FordPrfkt/StepperController/Boards/StepperDisplay/StepperDisplay_Top.png

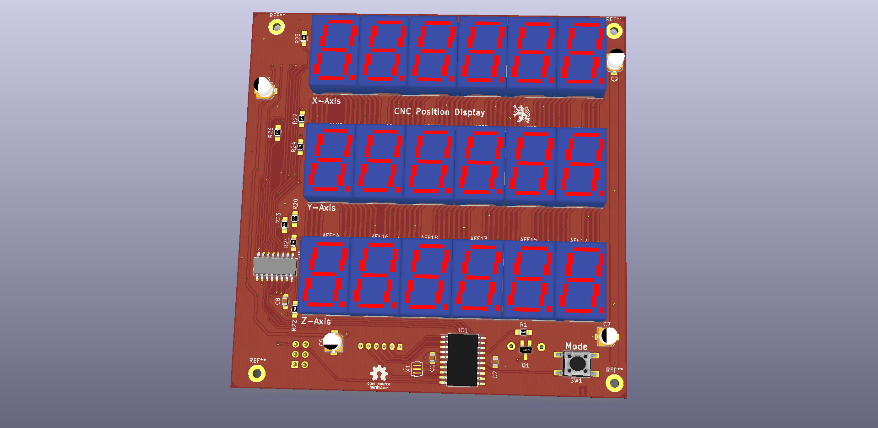
Boards/StepperDisplay/StepperDisplay_Top.png
