FordPrfkt/StepperController/boards/HighPowerDriver/HPDriver/HPDriver.png

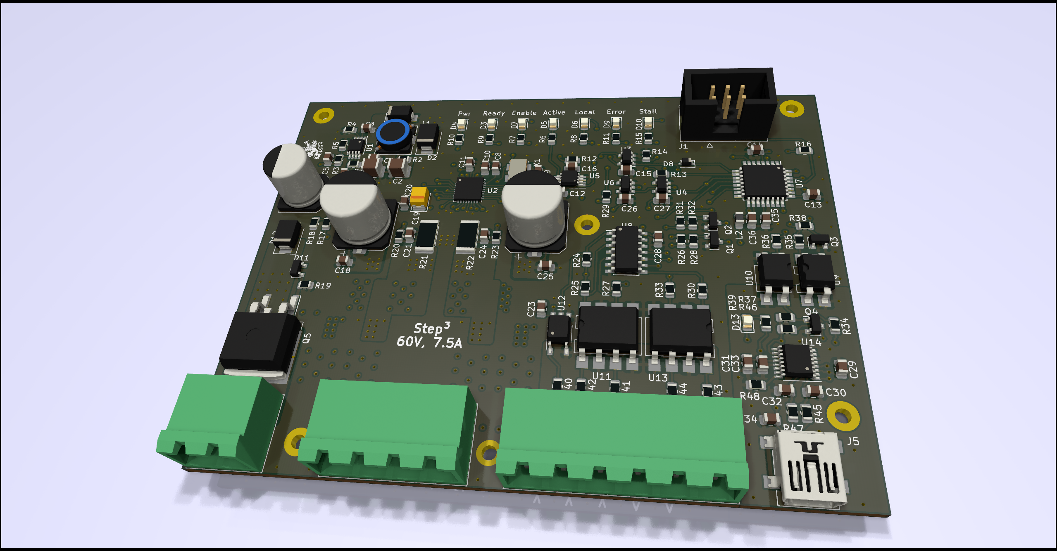
boards/HighPowerDriver/HPDriver/HPDriver.png
