FordPrfkt/StepperController/README.md

# StepperController
Stepper Motor Controller using TMC2660
