FordPrfkt/StepperController/Boards/StepperController/StepperController_Bot.png

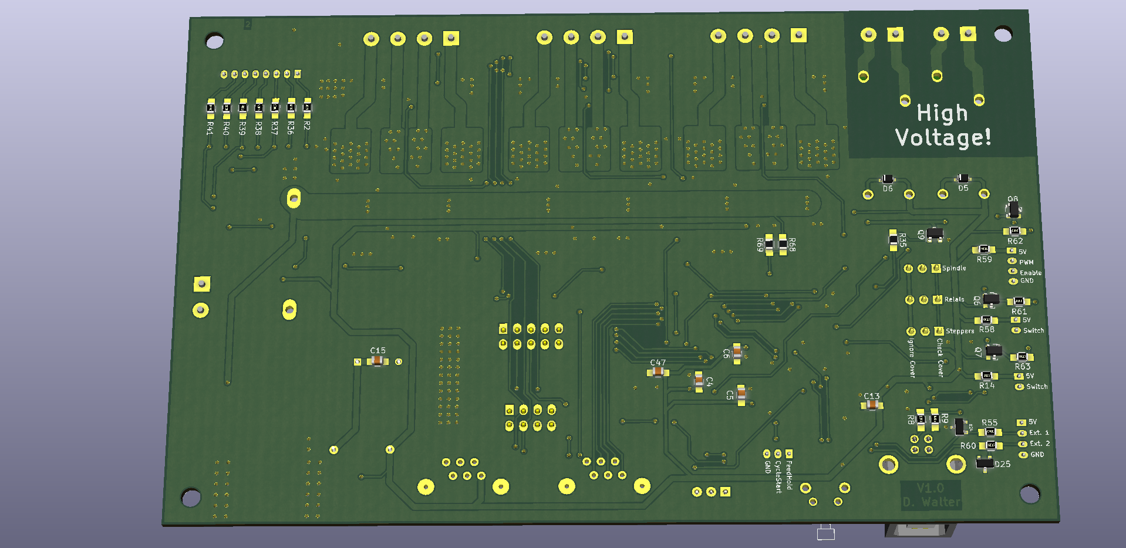
Boards/StepperController/StepperController_Bot.png
