FordPrfkt/StepperController/Boards/StepperController/StepperController_Top.png

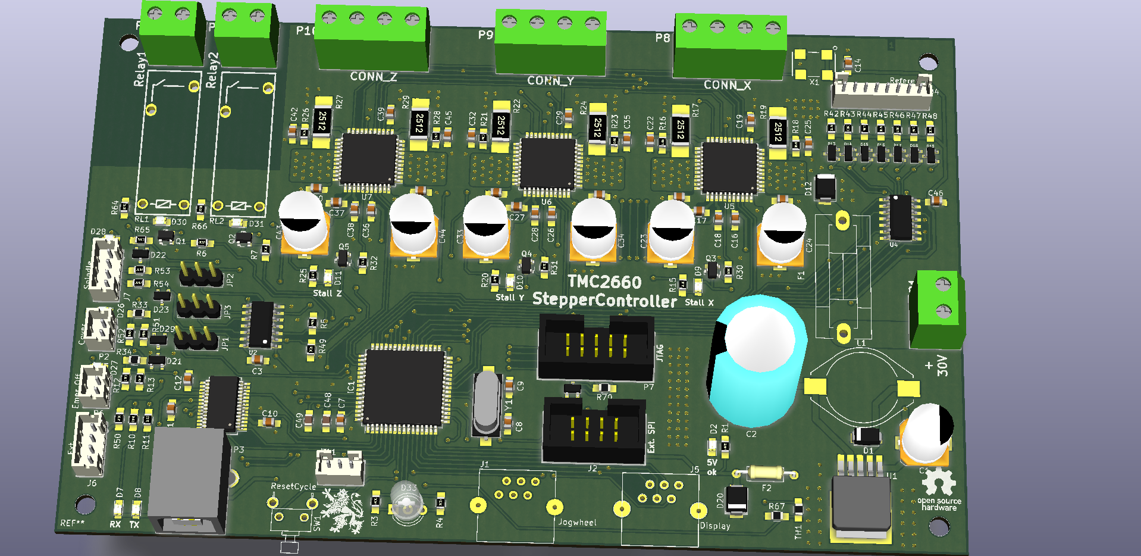
Boards/StepperController/StepperController_Top.png
