FordPrfkt/StepperController/Boards/StepperDisplay/StepperDisplay_Bot.png

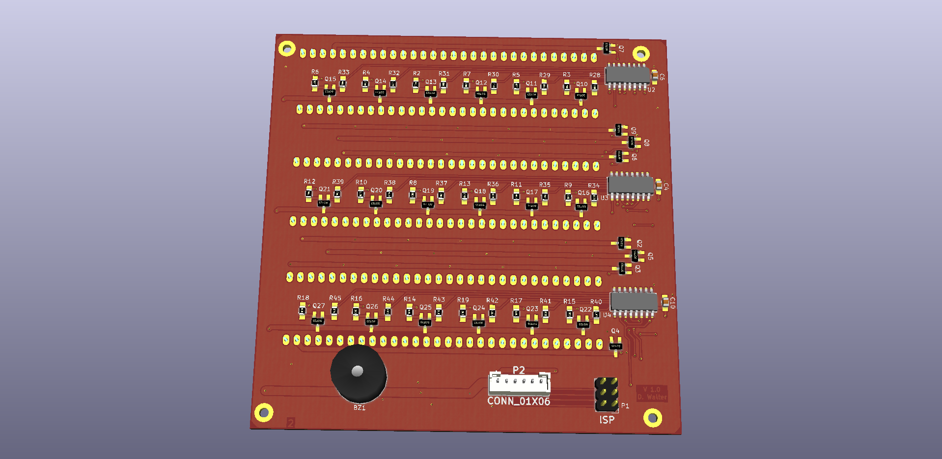
Boards/StepperDisplay/StepperDisplay_Bot.png
