FordPrfkt/StepperController/Boards/StepperController/StepperController.pdf

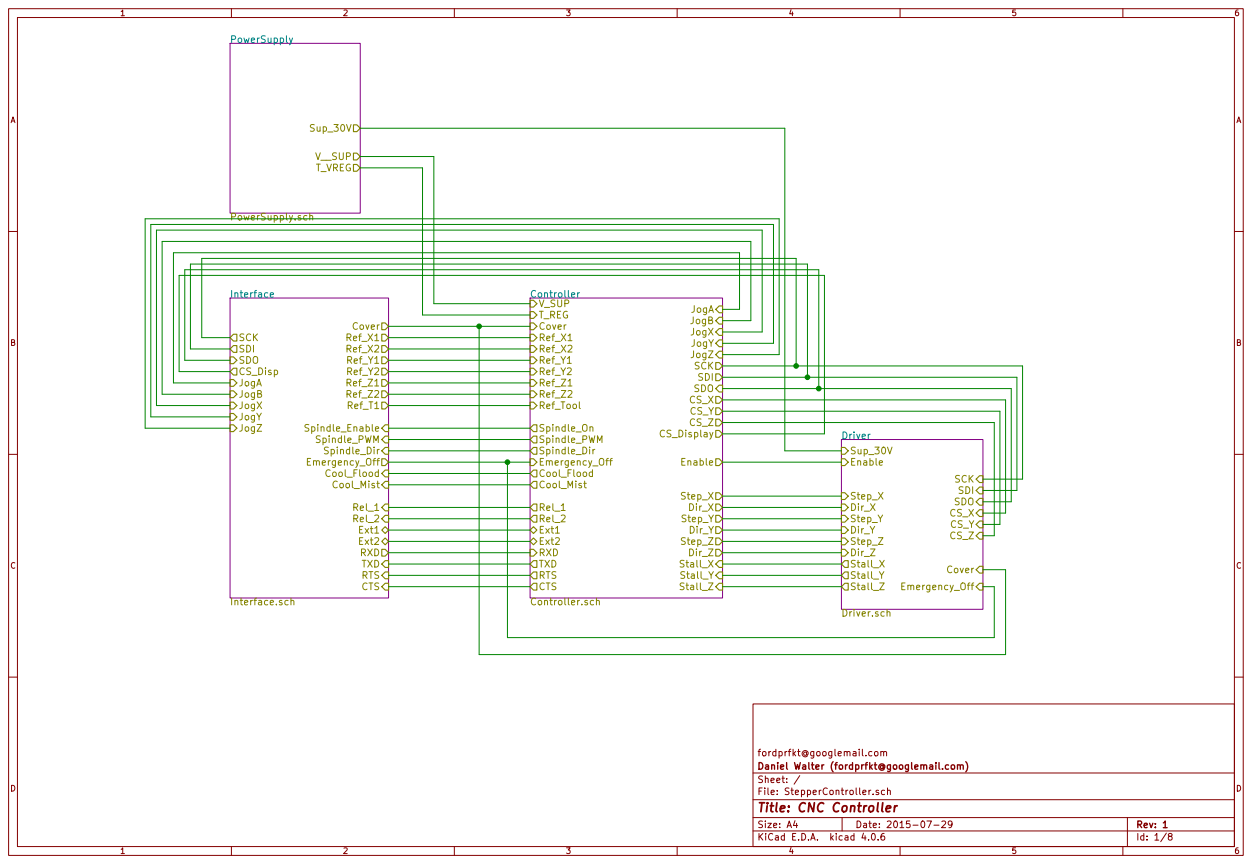
[picture p6: page 1]

fordprfkt@googlemail.com
File: StepperController.sch Sheet: / Daniel Walter (fordprfkt@googlemail.com)

Id: 1/8 Title: CNC Controller

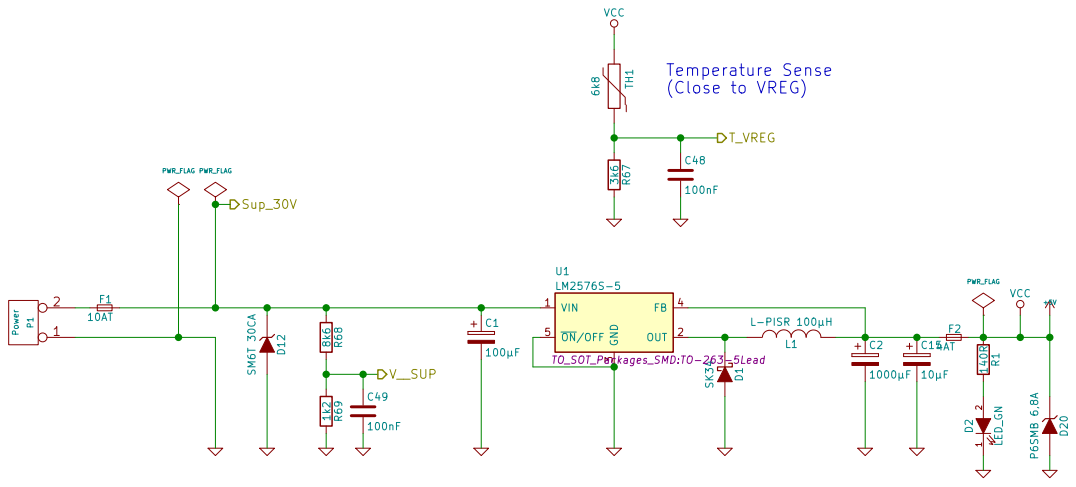
[picture p7: page 2]

fordprfkt@googlemail.com
Daniel Walter (fordprfkt@googlemail.com)
Sheet: /PowerSupply/
File: PowerSupply.sch
Id: 2/8 Title: CNC Controller

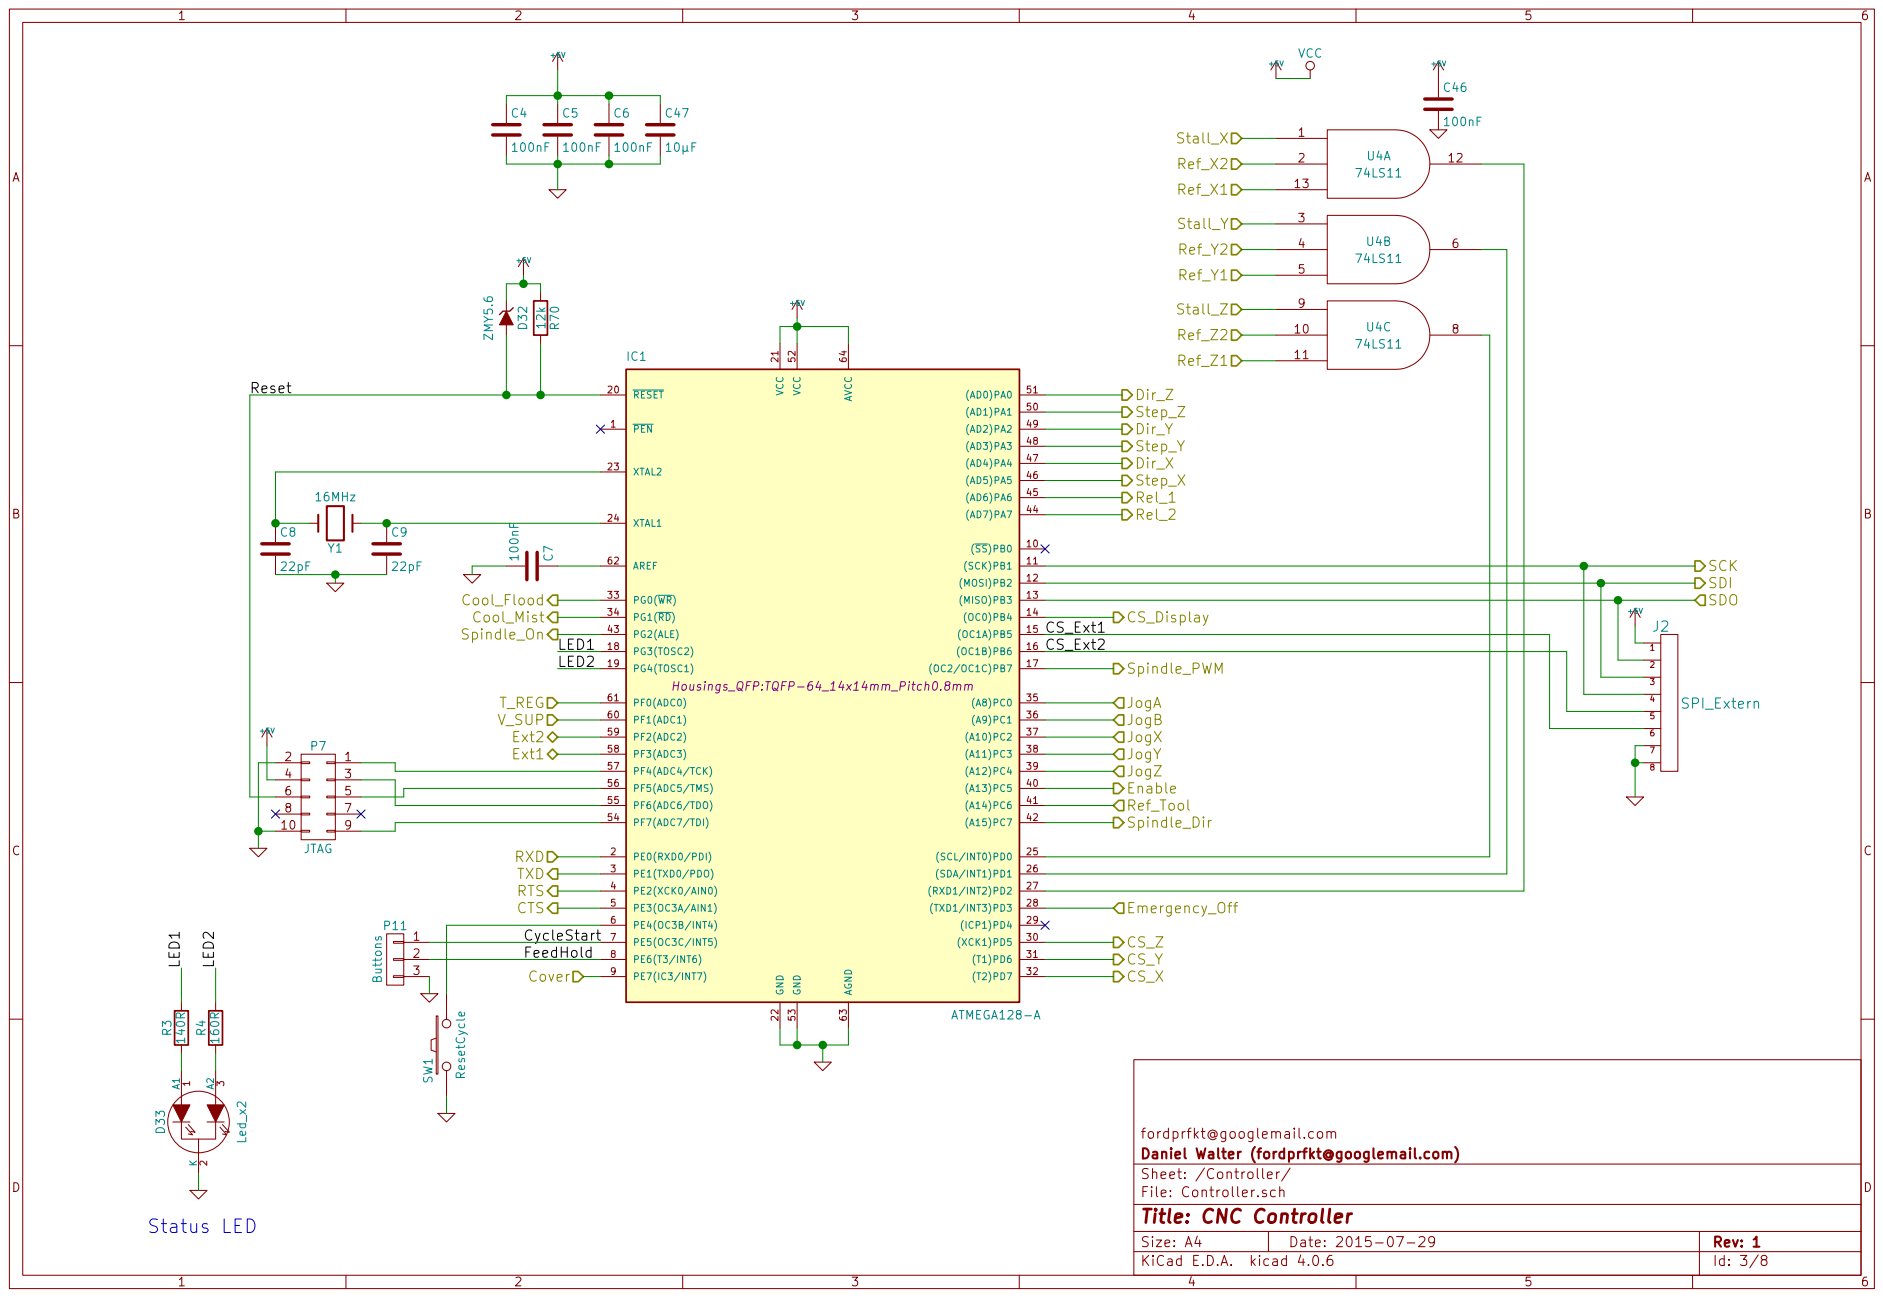
[picture p8: page 3]

PEN 1 PE0(RXD0/PDI) 2 PE1(TXD0/PDO) 3 PE2(XCK0/AIN0) 4 PE3(OC3A/AIN1) 5 PE4(OC3B/INT4) 6 PE5(OC3C/INT5) 7 PE6(T3/INT6) 8 PE7(IC3/INT7) 9 | CS_Display

CS_Ext2

Spindle_PWM JogA JogB JogX JogY JogZ Spindle_Dir

fordprfkt@googlemail.com
Id: 3/8 Title: CNC Controller File: Controller.sch Sheet: /Controller/ Daniel Walter (fordprfkt@googlemail.com)

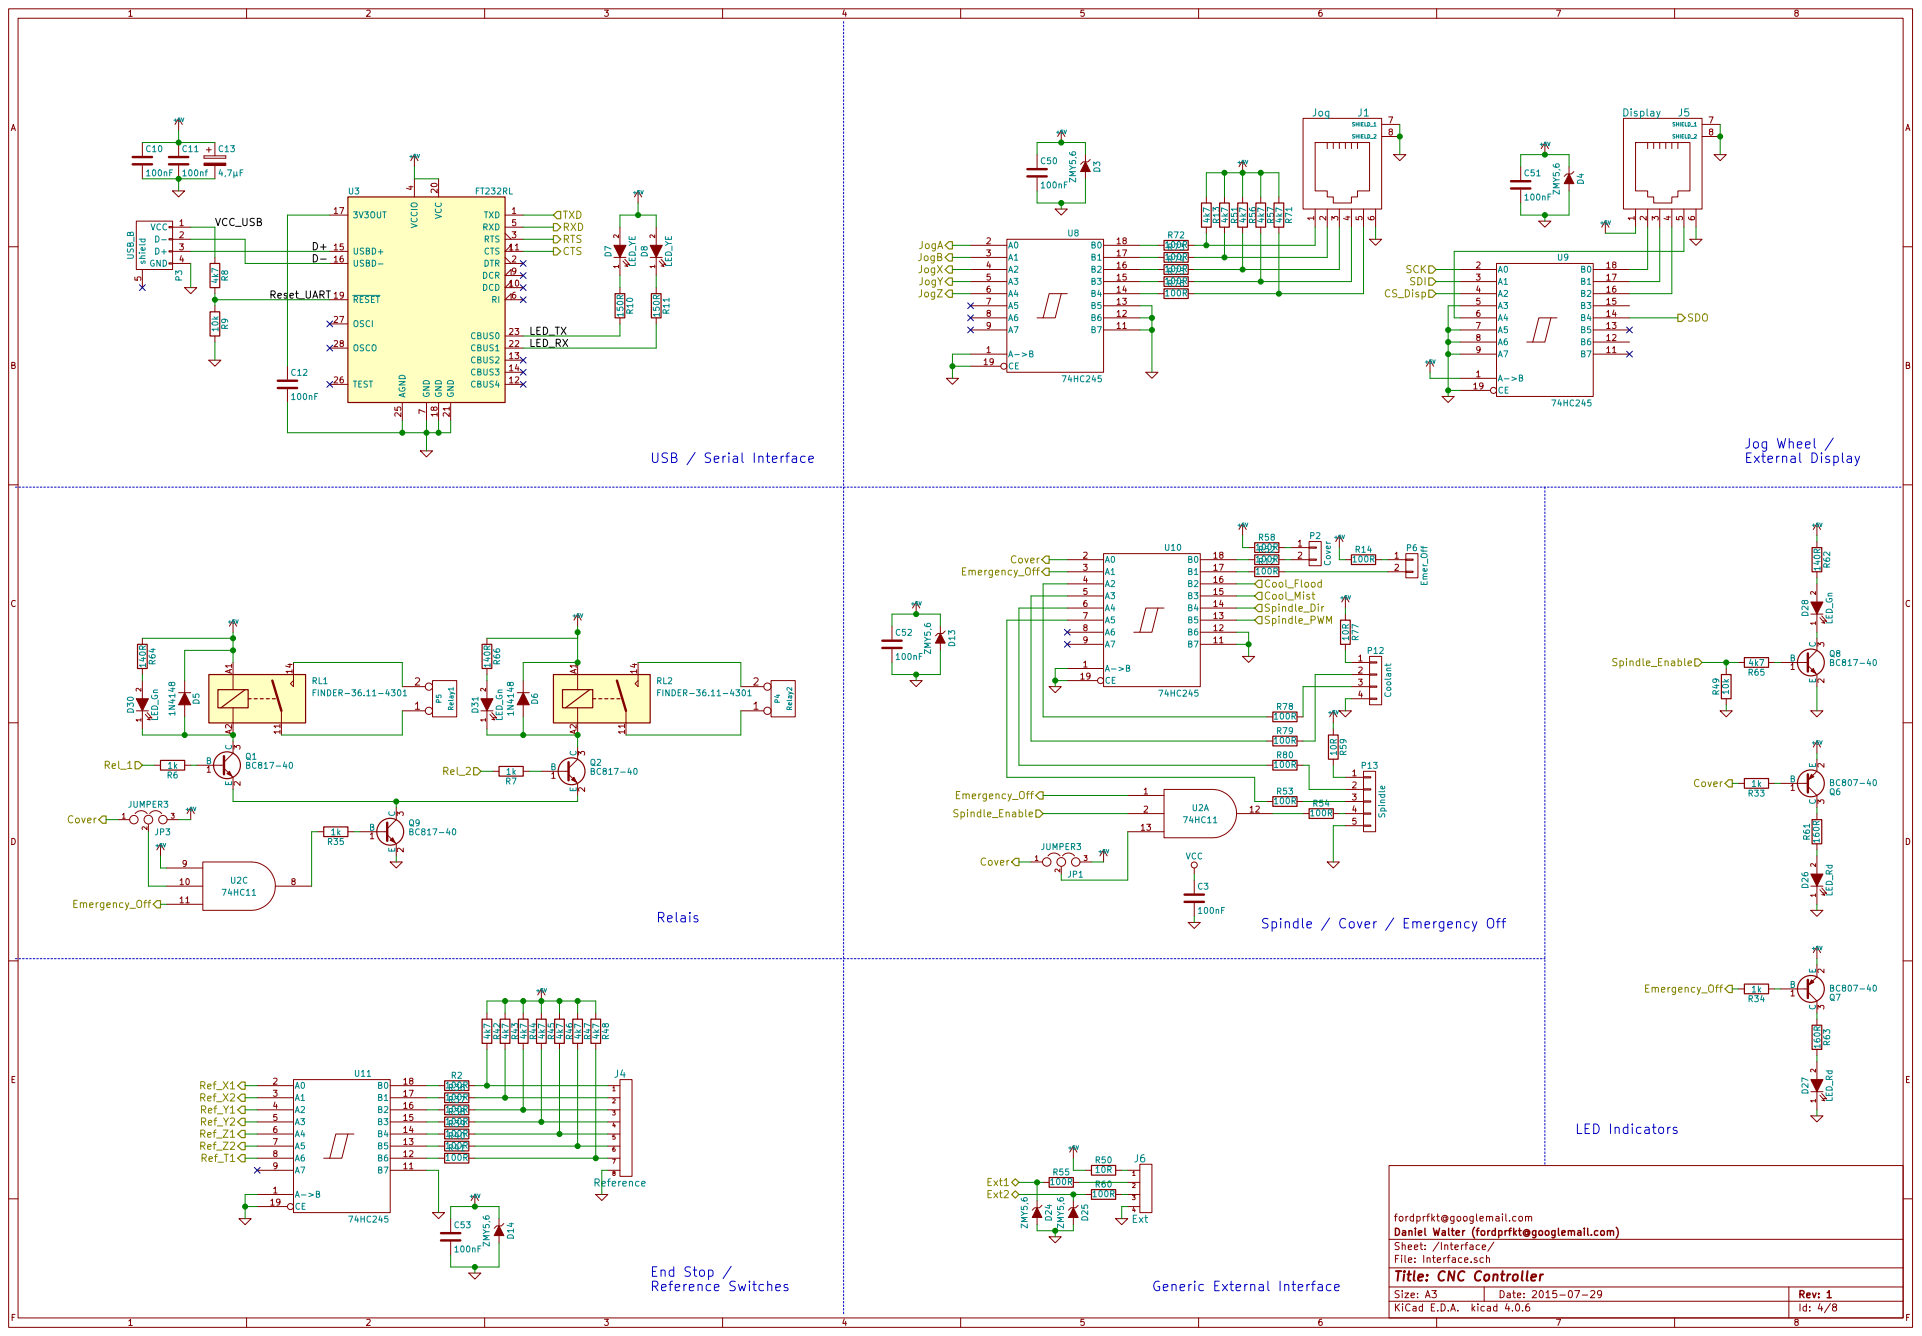
[picture p9: page 4]

7 DCR 9 DCD 10 VCC 20 CTS 11 GND 21 CBUS4 12 CBUS1 22 CBUS2 13 CBUS0 23 CBUS3 14 USBD+ 15 AGND 25 USBD- 16 TEST 26

Spindle / Cover / Emergency Off

fordprfkt@googlemail.com
Id: 4/8 Title: CNC Controller File: Interface.sch Sheet: /Interface/ Daniel Walter (fordprfkt@googlemail.com)

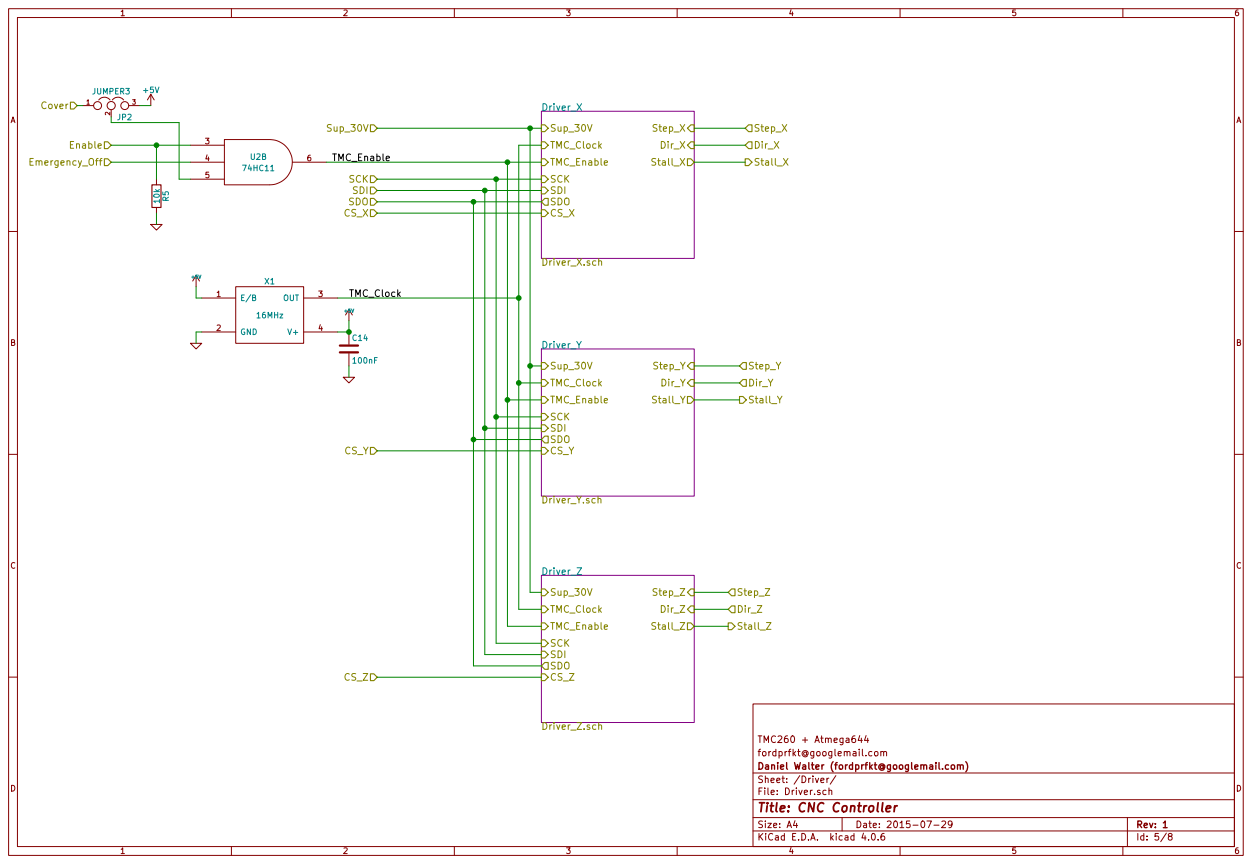
[picture p10: page 5]

TMC260 + Atmega644
fordprfkt@googlemail.com
Id: 5/8 Title: CNC Controller File: Driver.sch Sheet: /Driver/ Daniel Walter (fordprfkt@googlemail.com)

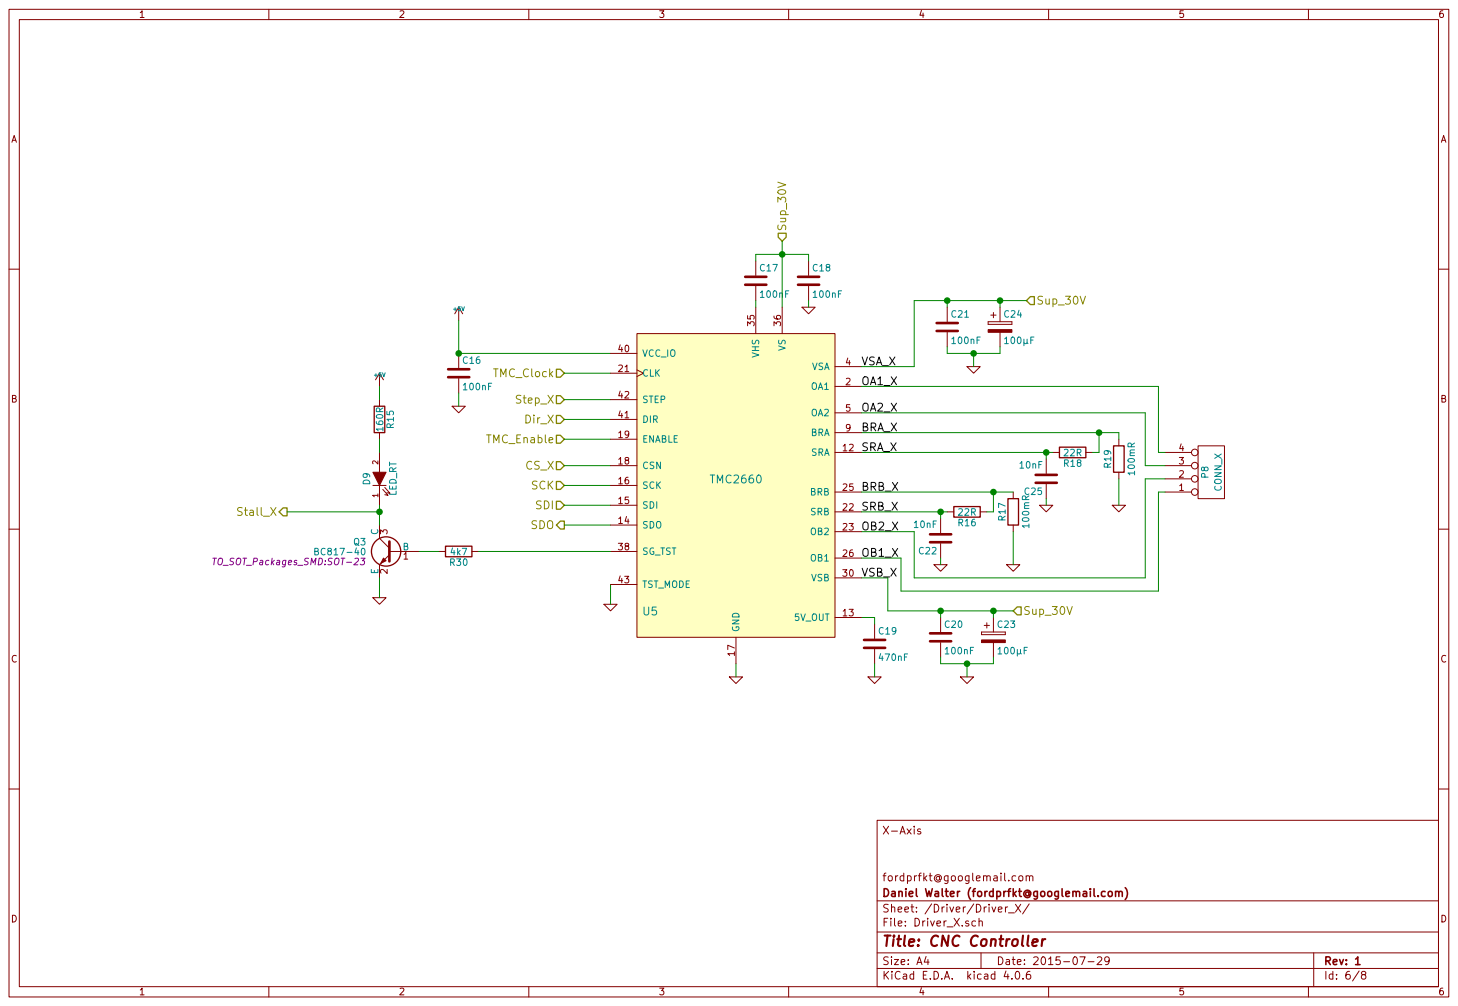
[picture p11: page 6]

fordprfkt@googlemail.com
Daniel Walter (fordprfkt@googlemail.com)
Sheet: /Driver/Driver_X/
File: Driver_X.sch
Id: 6/8 Title: CNC Controller

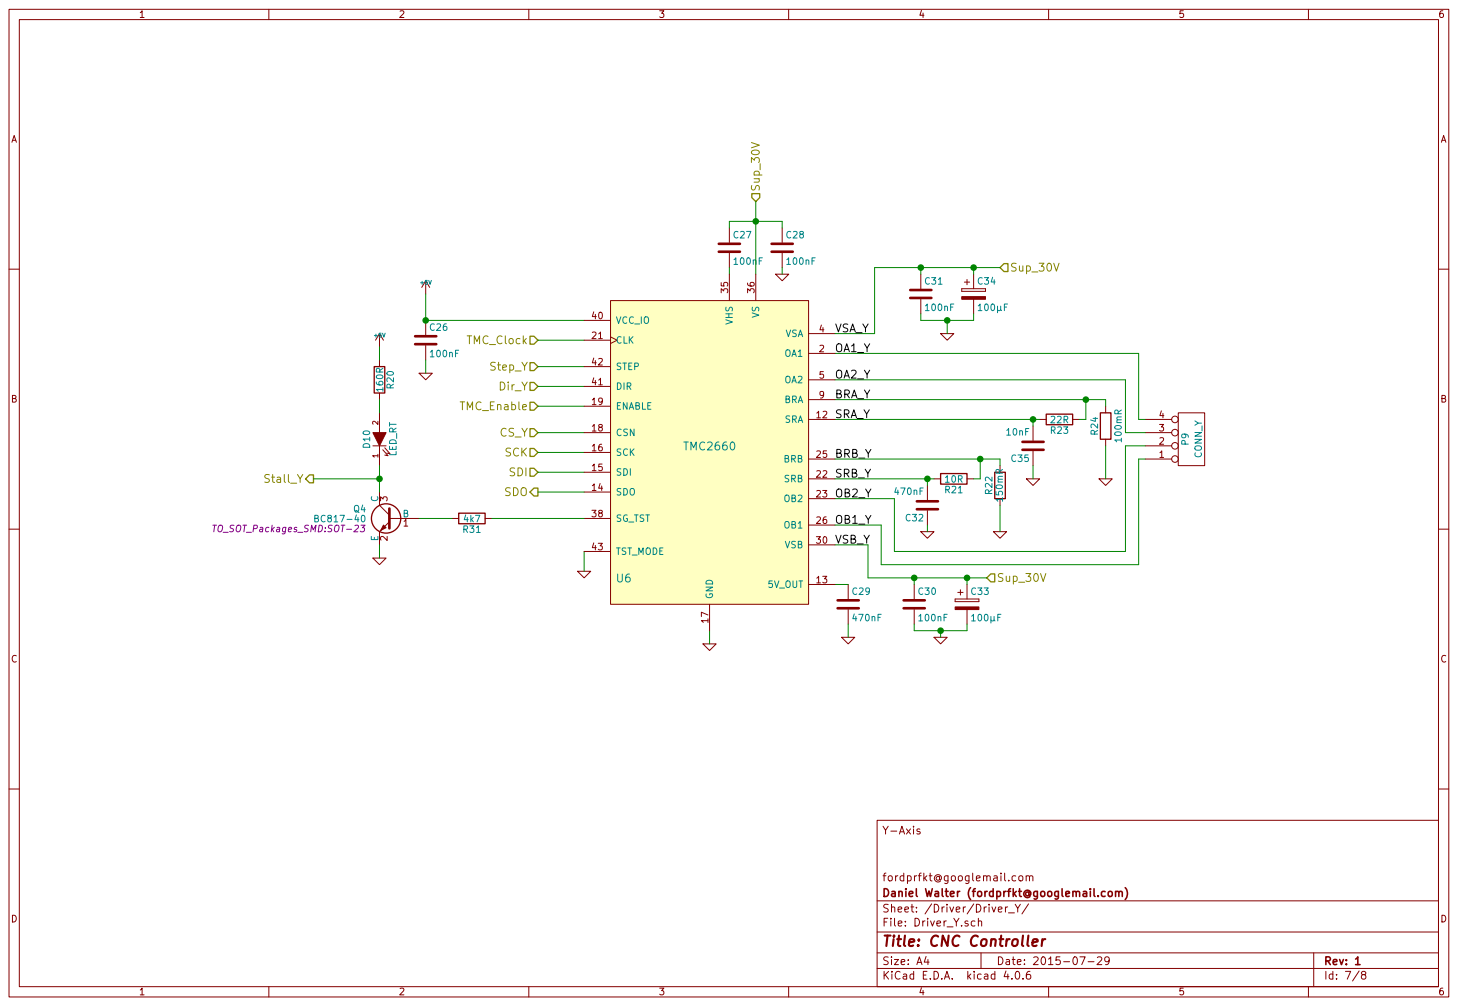
[picture p12: page 7]

fordprfkt@googlemail.com
Daniel Walter (fordprfkt@googlemail.com)
Sheet: /Driver/Driver_Y/
File: Driver_Y.sch
Id: 7/8 Title: CNC Controller

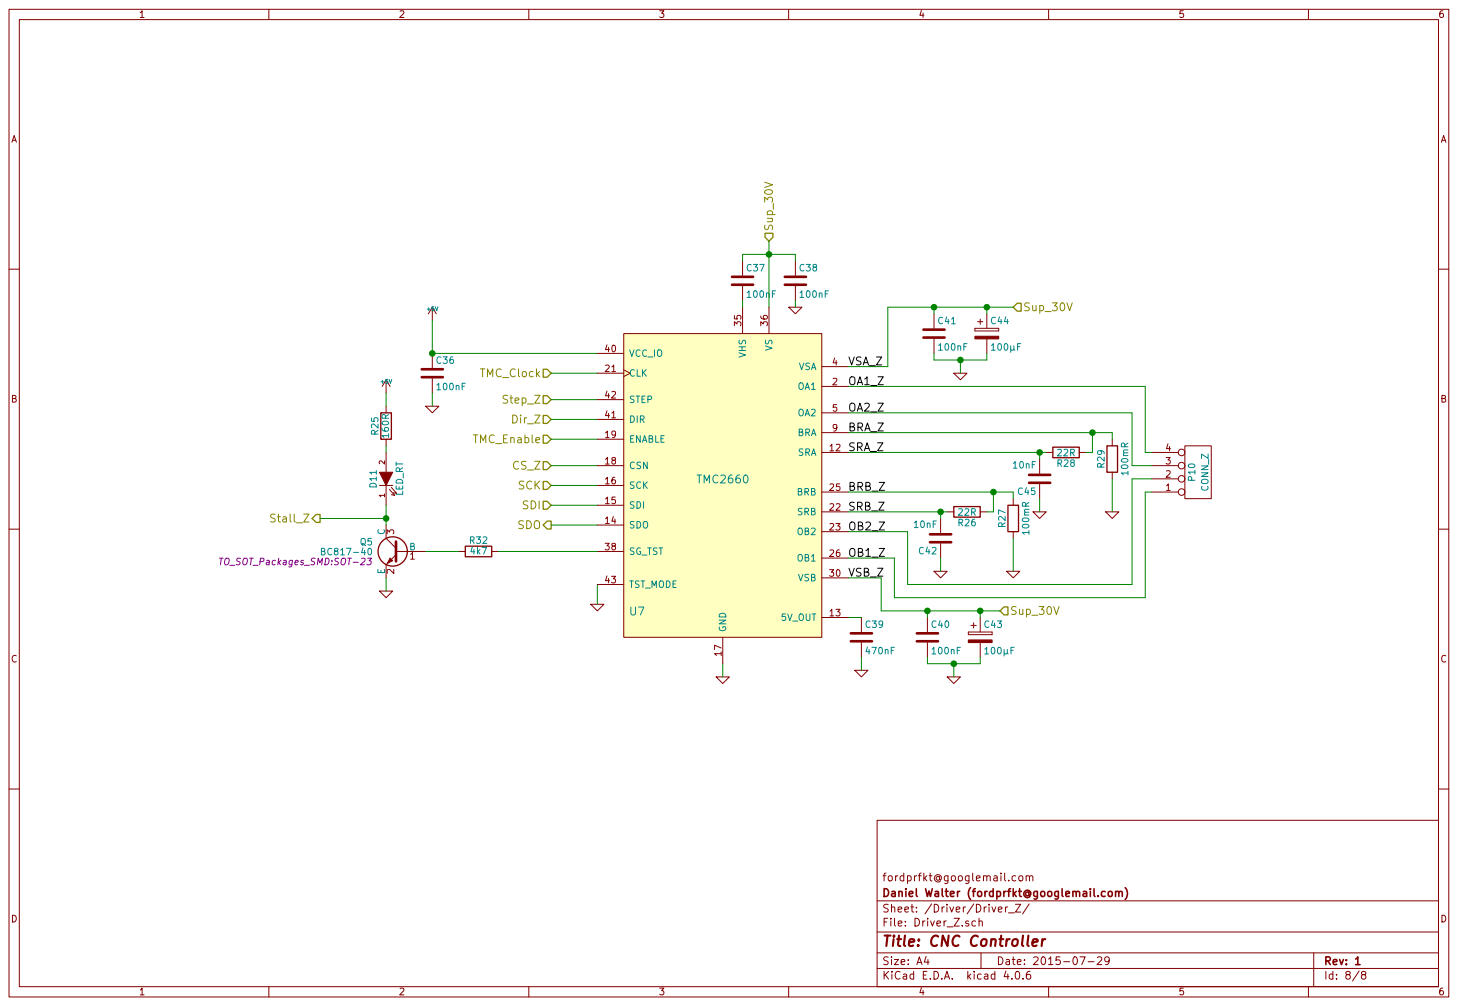
[picture p13: page 8]

Daniel Walter (fordprfkt@googlemail.com)
Sheet: /Driver/Driver_Z/
File: Driver_Z.sch
Id: 8/8 Title: CNC Controller
