FordPrfkt/StepperController/Boards/StepperDisplay/StepperDisplay.pdf

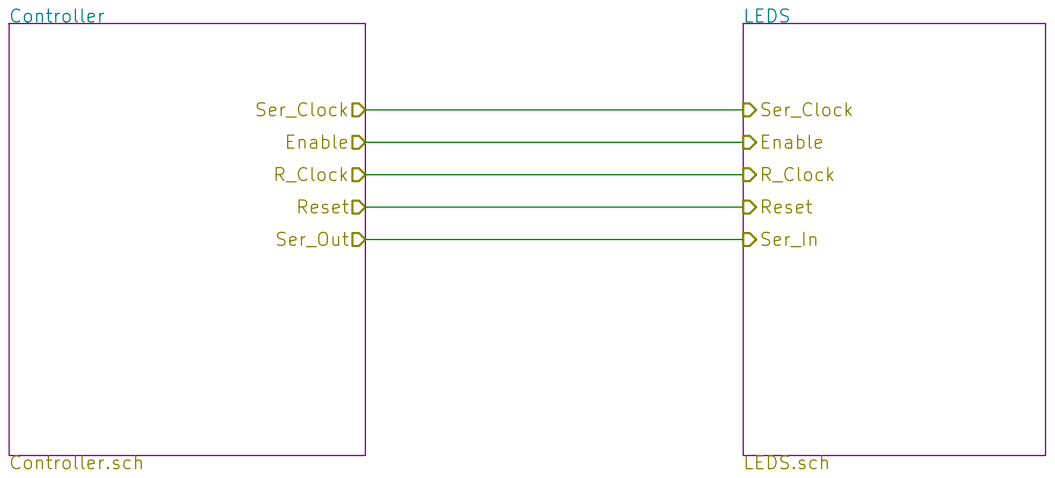
[picture p14: page 1]

File: StepperDisplay.sch Sheet: / Daniel Walter (fordprfkt@googlemail.com)

Id: 1/6 Title: CNC Controller Positionsanzeige

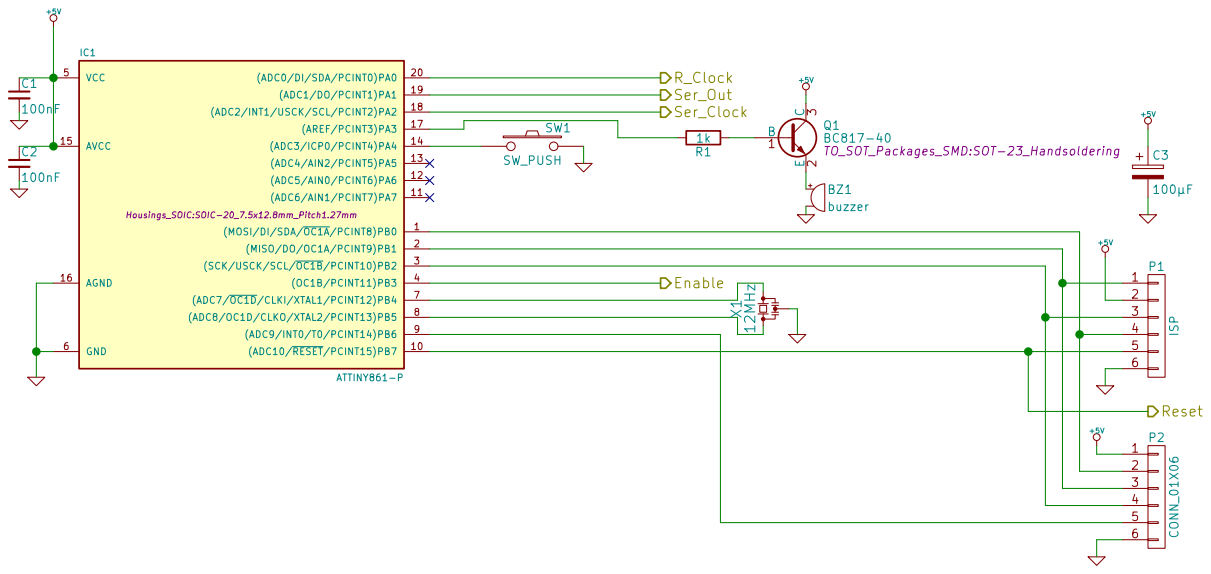
[picture p15: page 2]

File: Controller.sch Sheet: /Controller/ Daniel Walter (fordprfkt@googlemail.com)

Id: 2/6 Title: CNC Controller Positionsanzeige

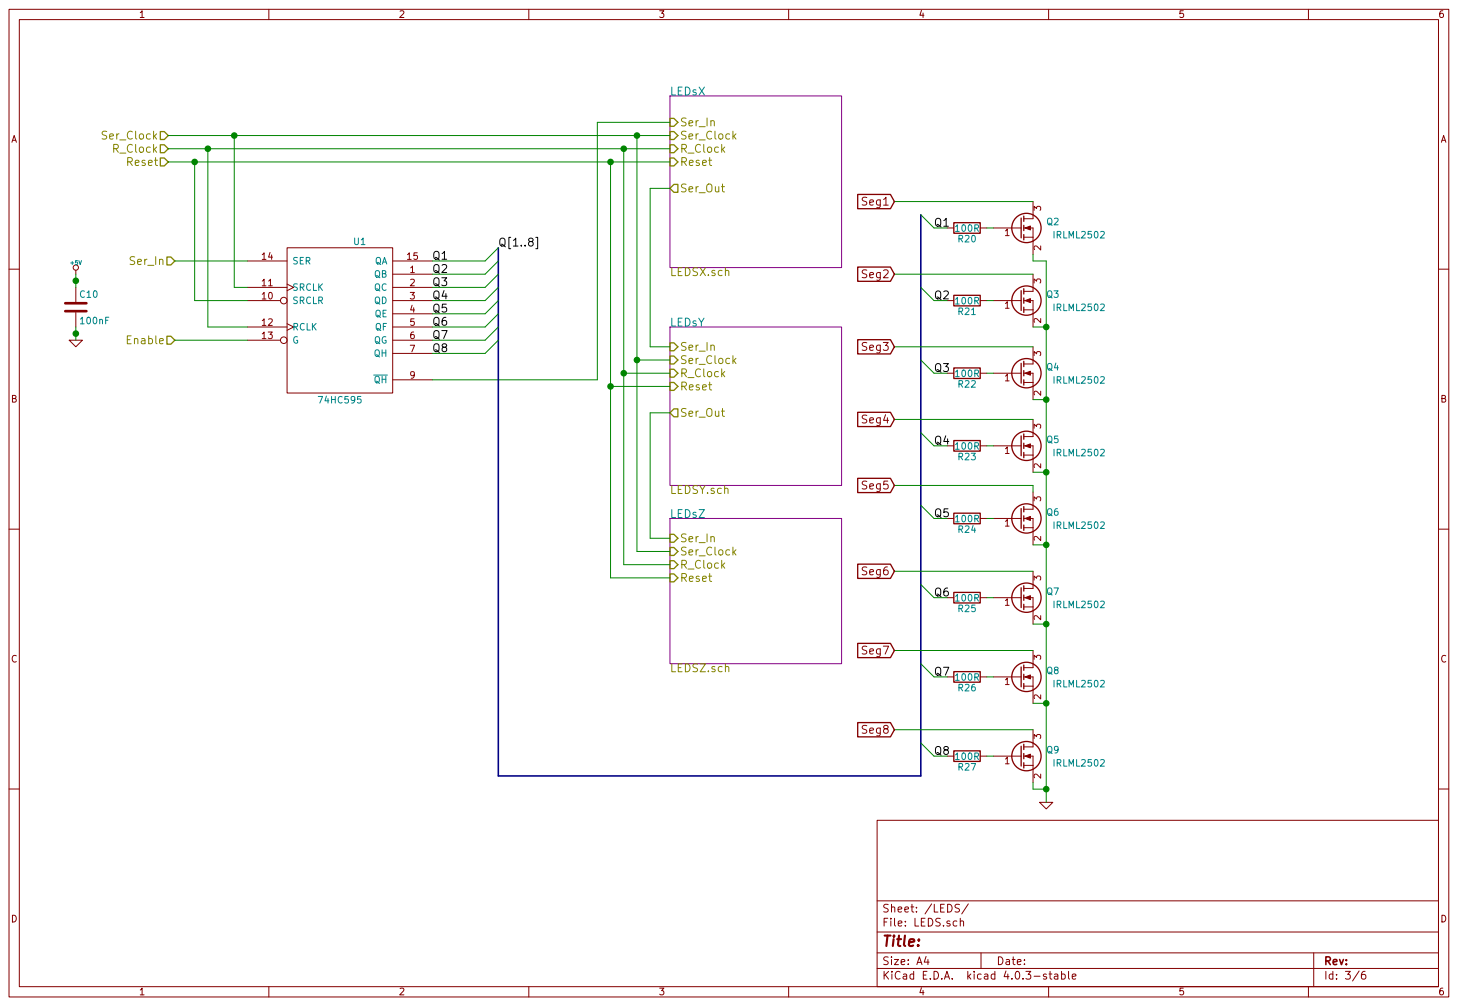
[picture p16: page 3]

Id: 3/6 Title: File: LEDS.sch Sheet: /LEDS/

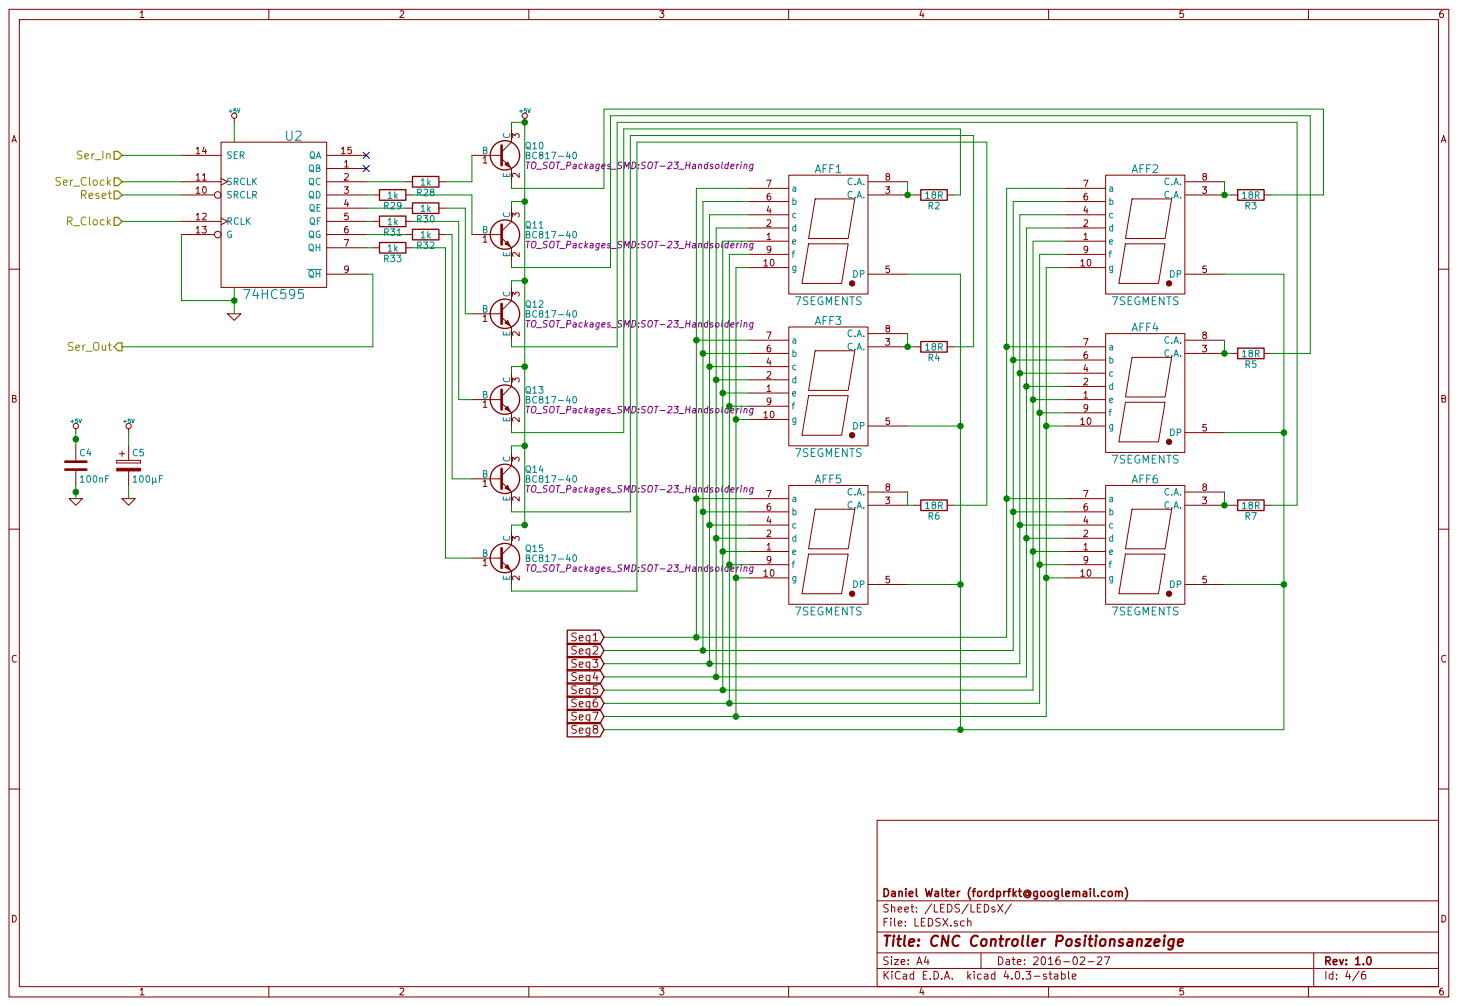
[picture p17: page 4]

File: LEDSX.sch Sheet: /LEDS/LEDsX/ Daniel Walter (fordprfkt@googlemail.com)

Id: 4/6 Title: CNC Controller Positionsanzeige

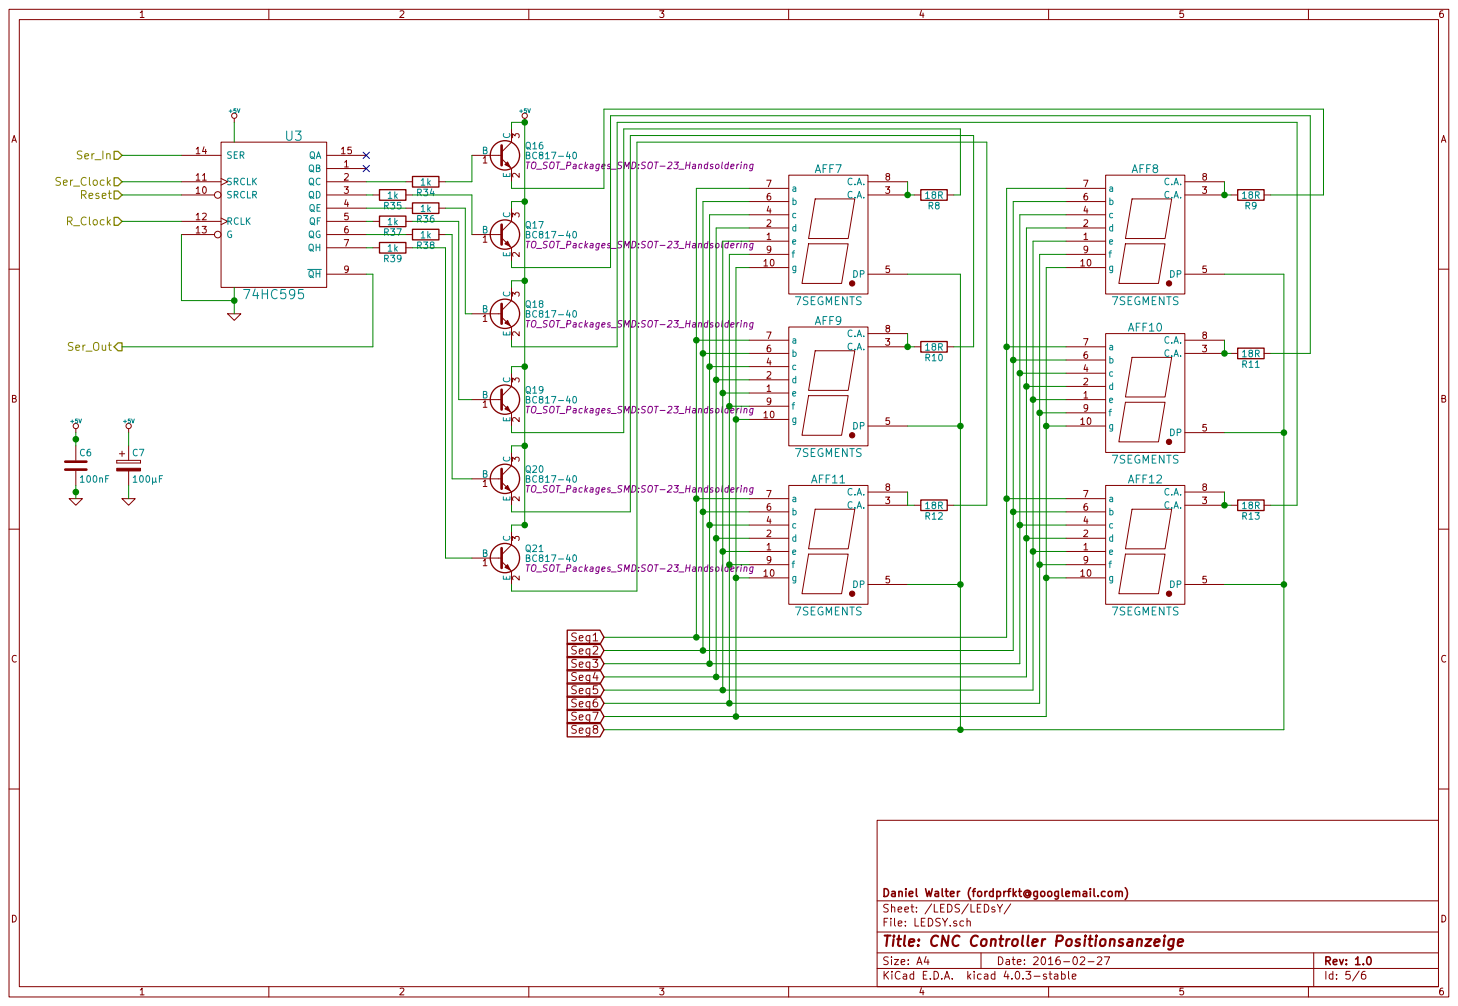
[picture p18: page 5]

File: LEDSY.sch Sheet: /LEDS/LEDsY/ Daniel Walter (fordprfkt@googlemail.com)

Id: 5/6 Title: CNC Controller Positionsanzeige

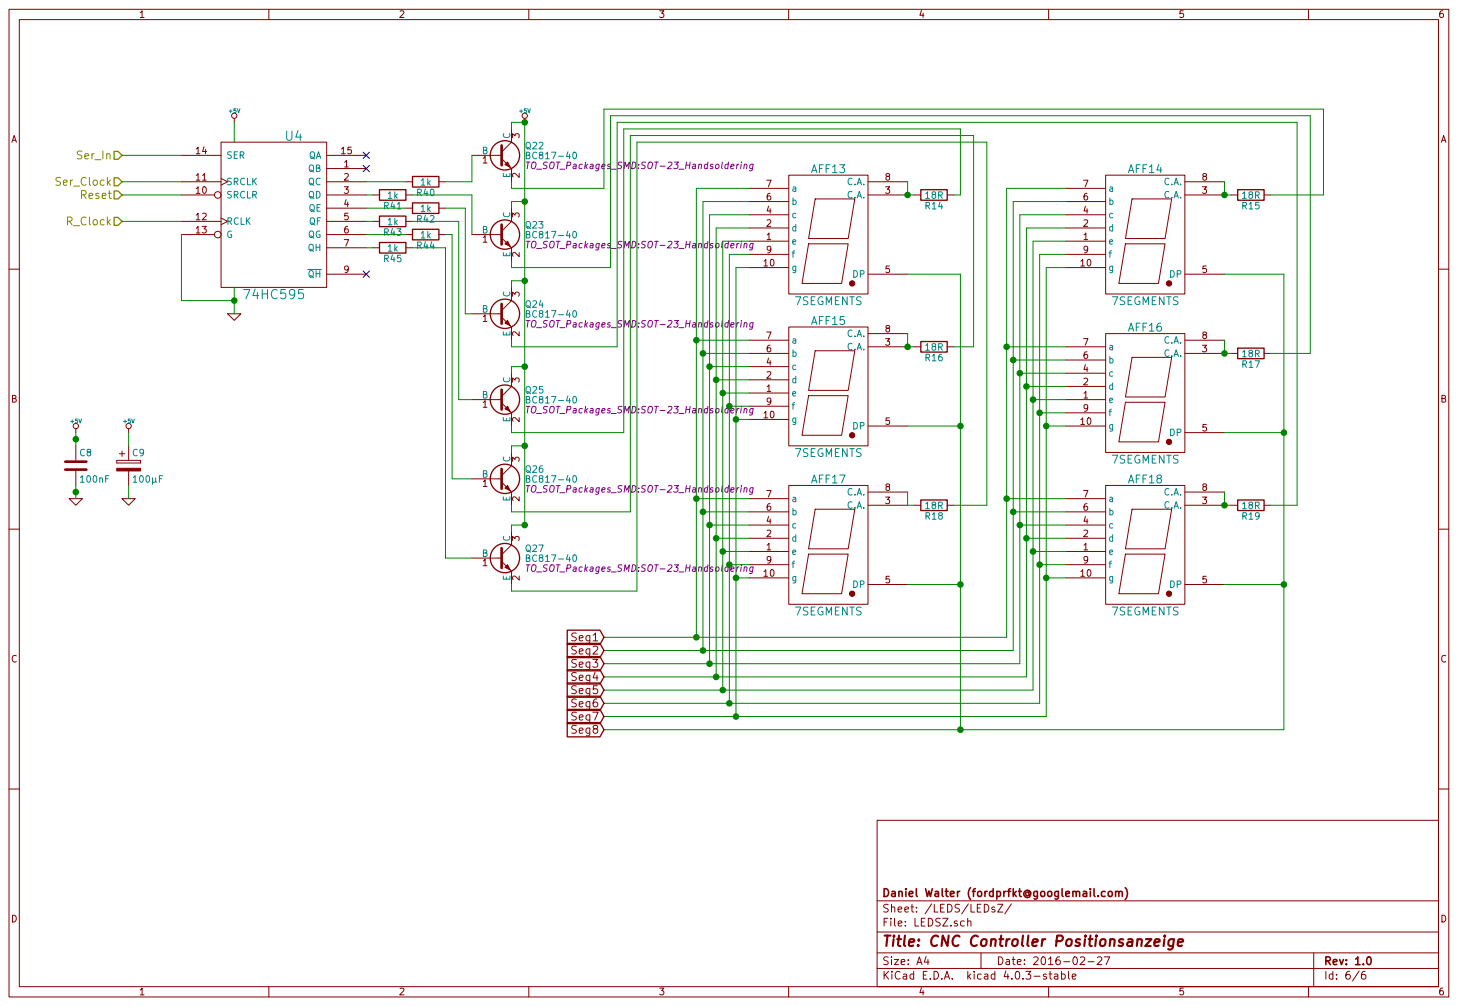
[picture p19: page 6]

File: LEDSZ.sch Sheet: /LEDS/LEDsZ/ Daniel Walter (fordprfkt@googlemail.com)

Id: 6/6 Title: CNC Controller Positionsanzeige
