FordPrfkt/StepperController/boards/HighPowerDriver/HPDriver/HPDriver.pdf

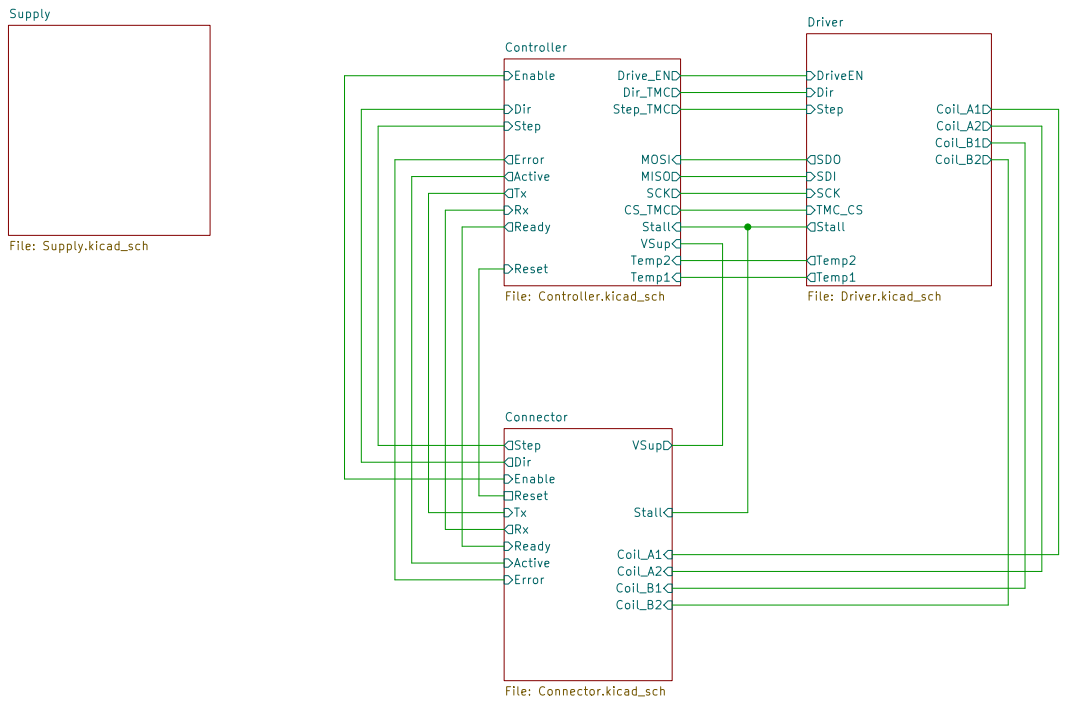
[picture p20: page 1]

Daniel Walter
File: HPDriver.kicad_sch Sheet: / fordprfkt@googlemail.com

Id: 1/5 Title: High Power Stepper Driver

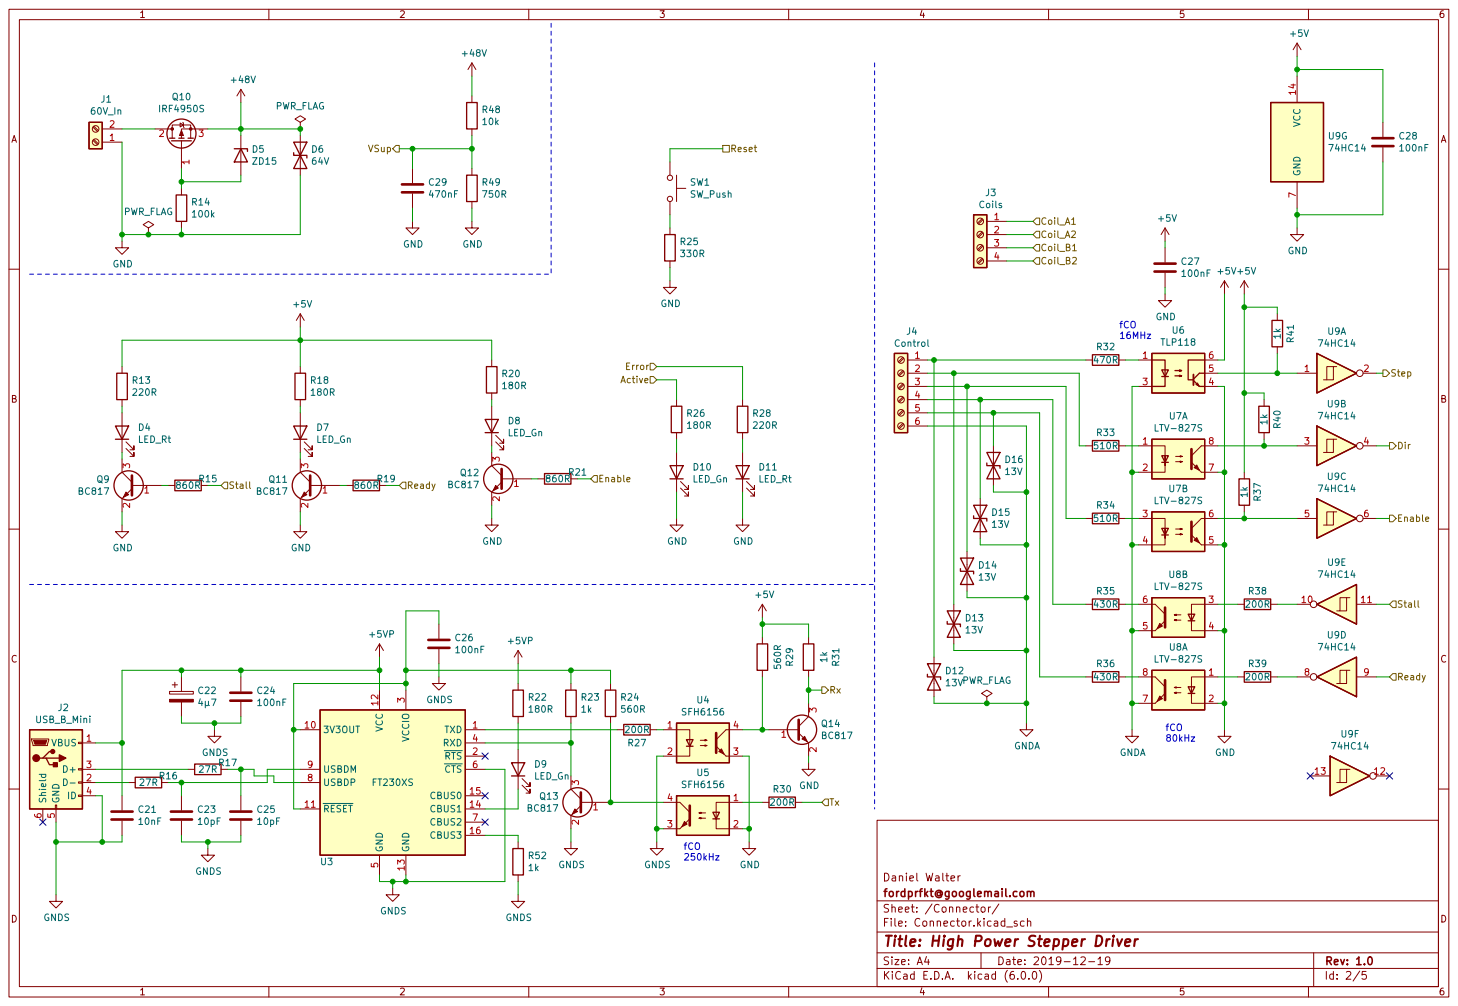
[picture p21: page 2]

5 ~{CTS} 6 CBUS2 7 USBDP 8 USBDM 9 U3 FT230XS GNDS C25

Daniel Walter
File: Connector.kicad_sch Sheet: /Connector/ fordprfkt@googlemail.com

Id: 2/5 Title: High Power Stepper Driver

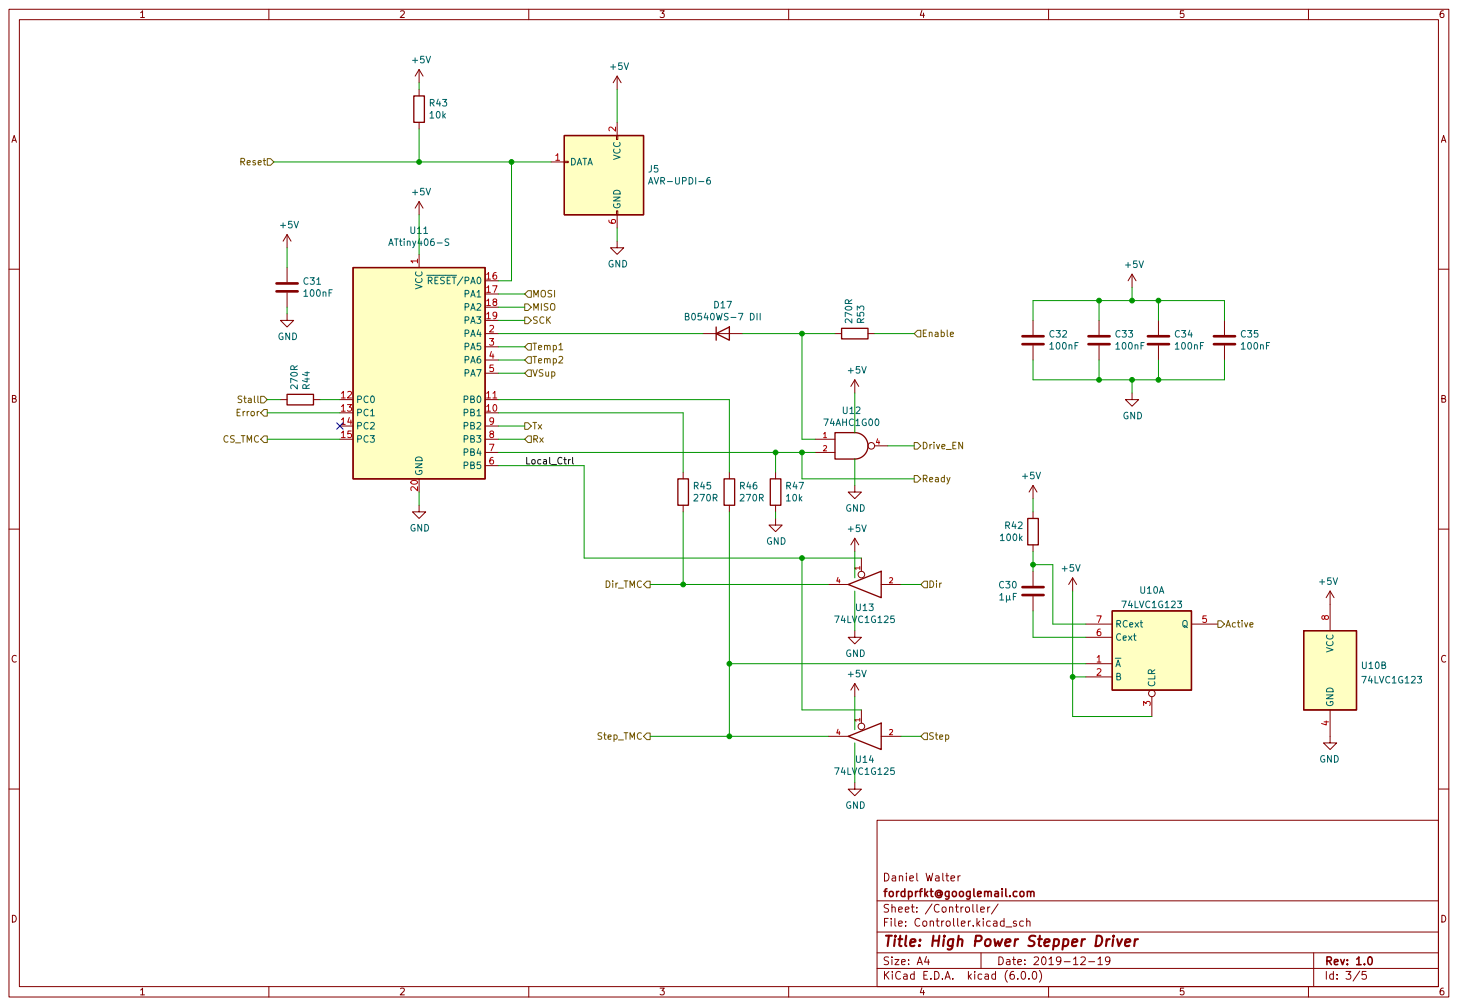
[picture p22: page 3]

File: Controller.kicad_sch Sheet: /Controller/ fordprfkt@googlemail.com

Id: 3/5 Title: High Power Stepper Driver

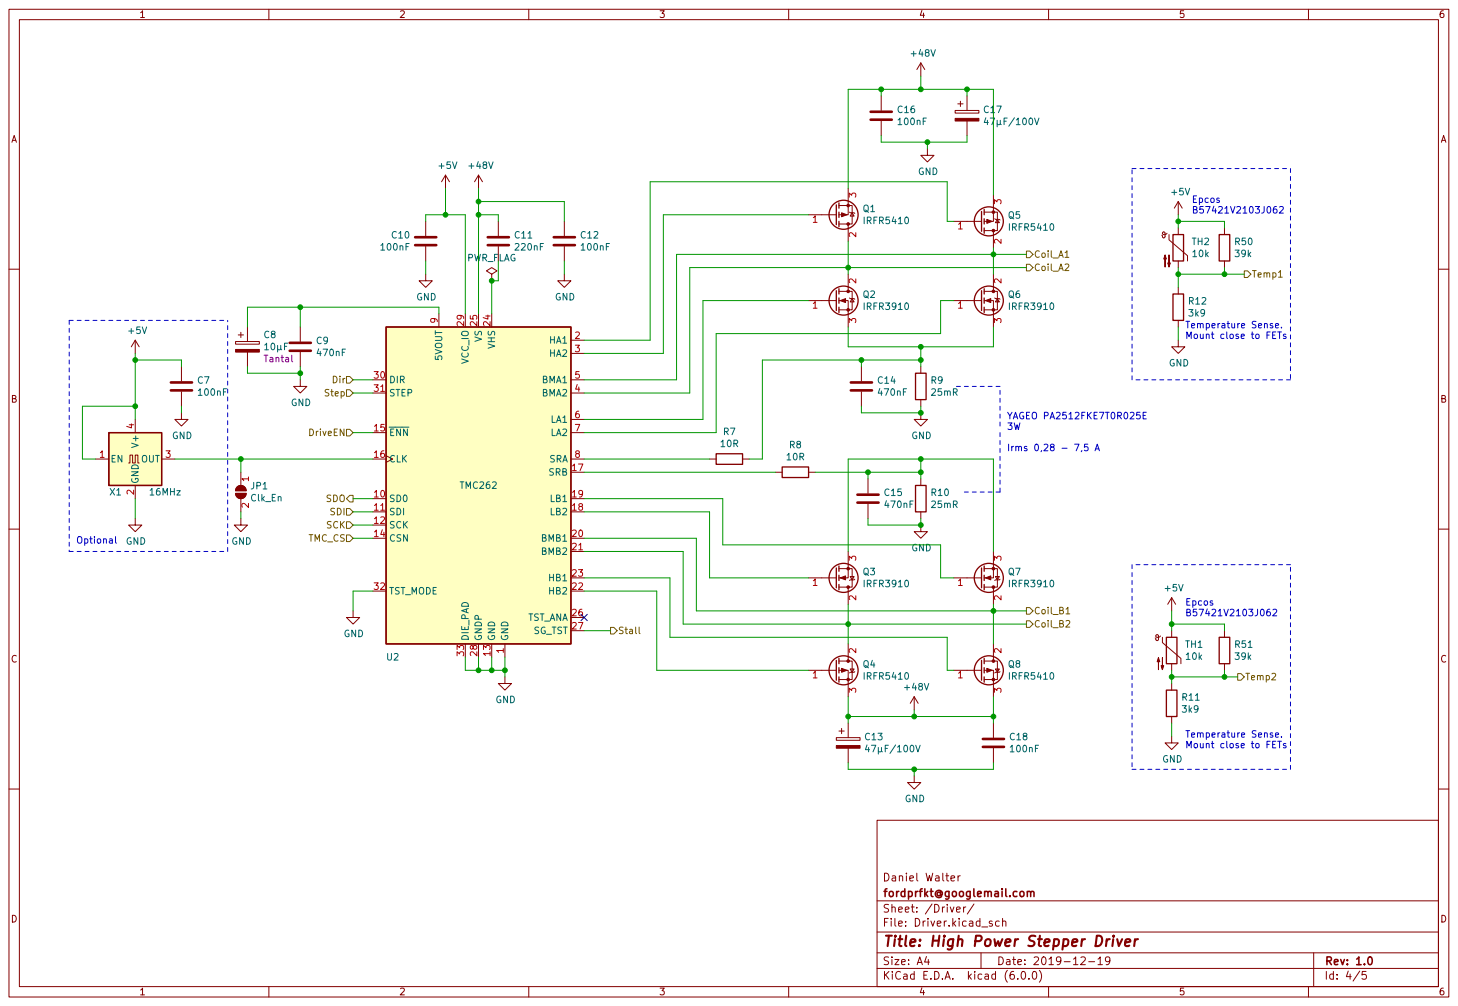
[picture p23: page 4]

Epcos B57421V2103J062 Temperature Sense. Mount close to FETs Optional

1 SD0 10 SDI 11 SCK 12 GND 13 CSN 14 ~{ENN} 15 CLK 16 SRB 17

Epcos B57421V2103J062 Temperature Sense. Mount close to FETs

Daniel Walter
File: Driver.kicad_sch Sheet: /Driver/ fordprfkt@googlemail.com

Id: 4/5 Title: High Power Stepper Driver

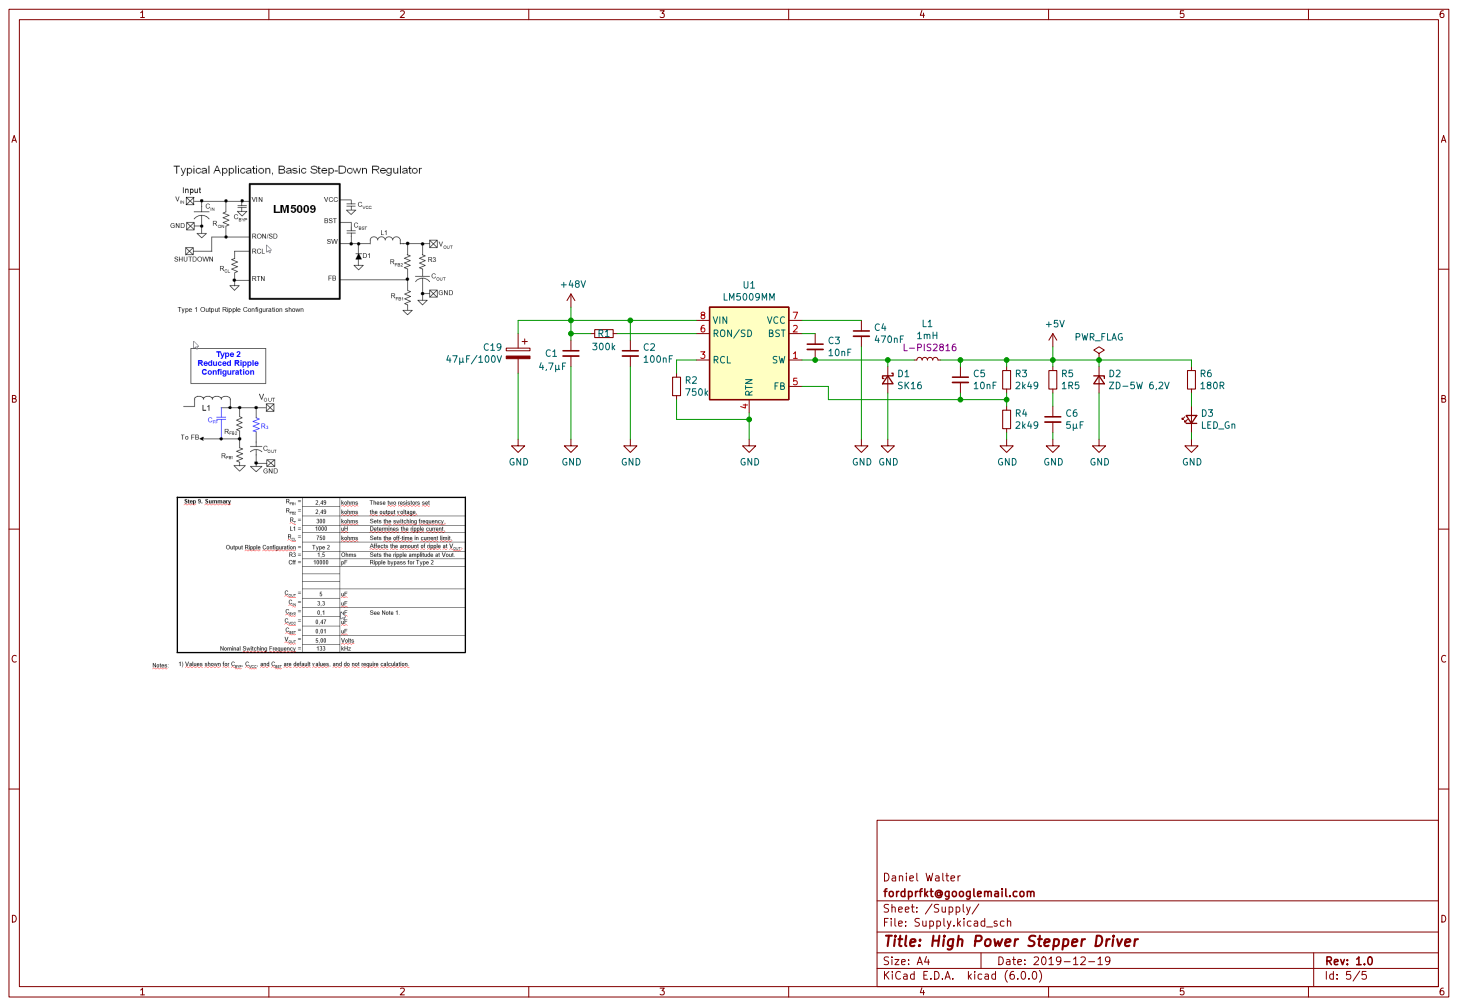
[picture p24: page 5]

4 FB 5 RON/SD 6 VCC 7 VIN 8 U1

Daniel Walter
fordprfkt@googlemail.com
Sheet: /Supply/
File: Supply.kicad_sch
Id: 5/5 Title: High Power Stepper Driver
