FordPrfkt/StepperController/boards/HighPowerDriver - Kopie/HPDriver/HPDriver.pdf

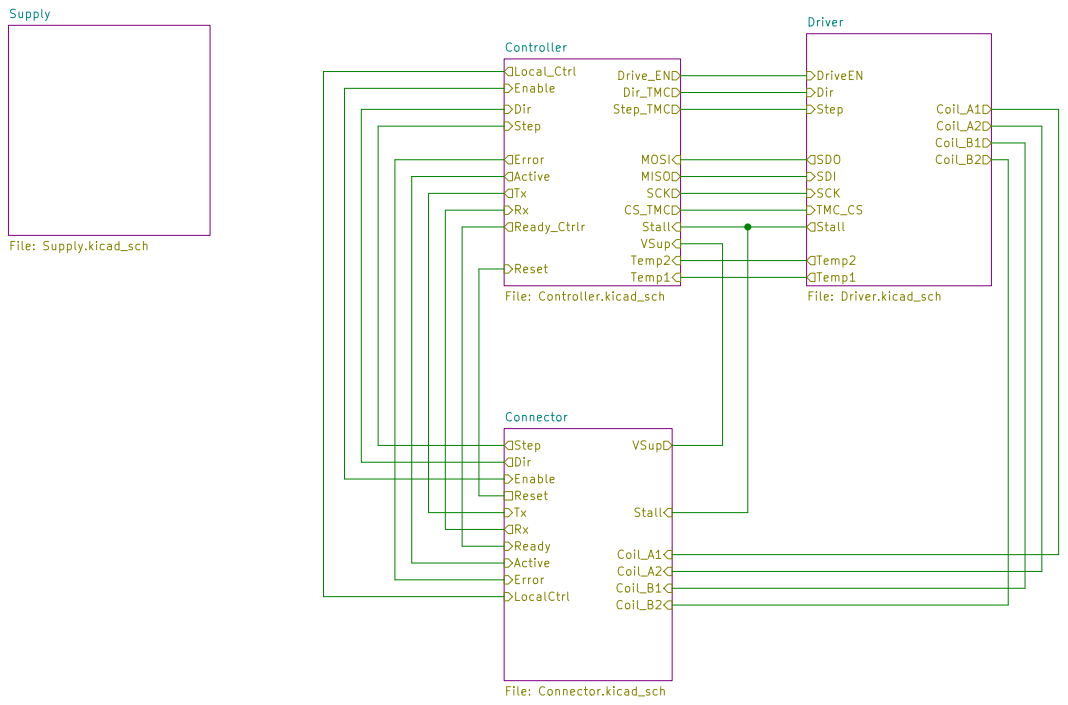
[picture p25: page 1]

SDO
SDI SCK
LocalCtrl Connector File: Connector.kicad_sch

Daniel Walter
File: HPDriver.kicad_sch Sheet: / fordprfkt@googlemail.com

Id: 1/5 Title: High Power Stepper Driver

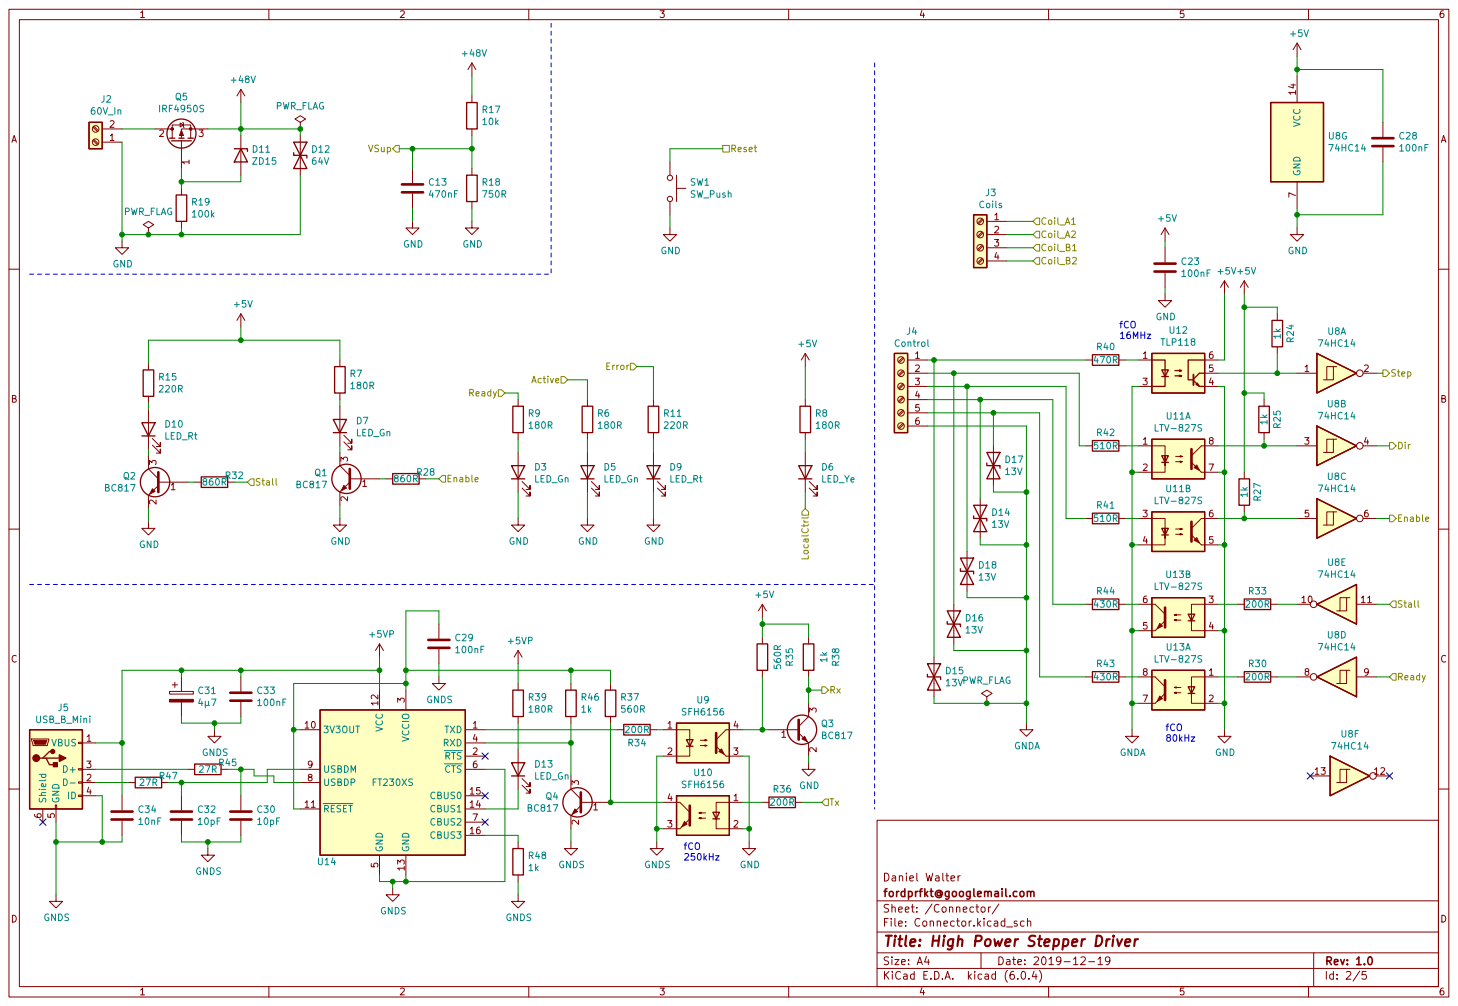
[picture p26: page 2]

6 | | LTV-827S R8

Daniel Walter
File: Connector.kicad_sch Sheet: /Connector/ fordprfkt@googlemail.com

Id: 2/5 Title: High Power Stepper Driver

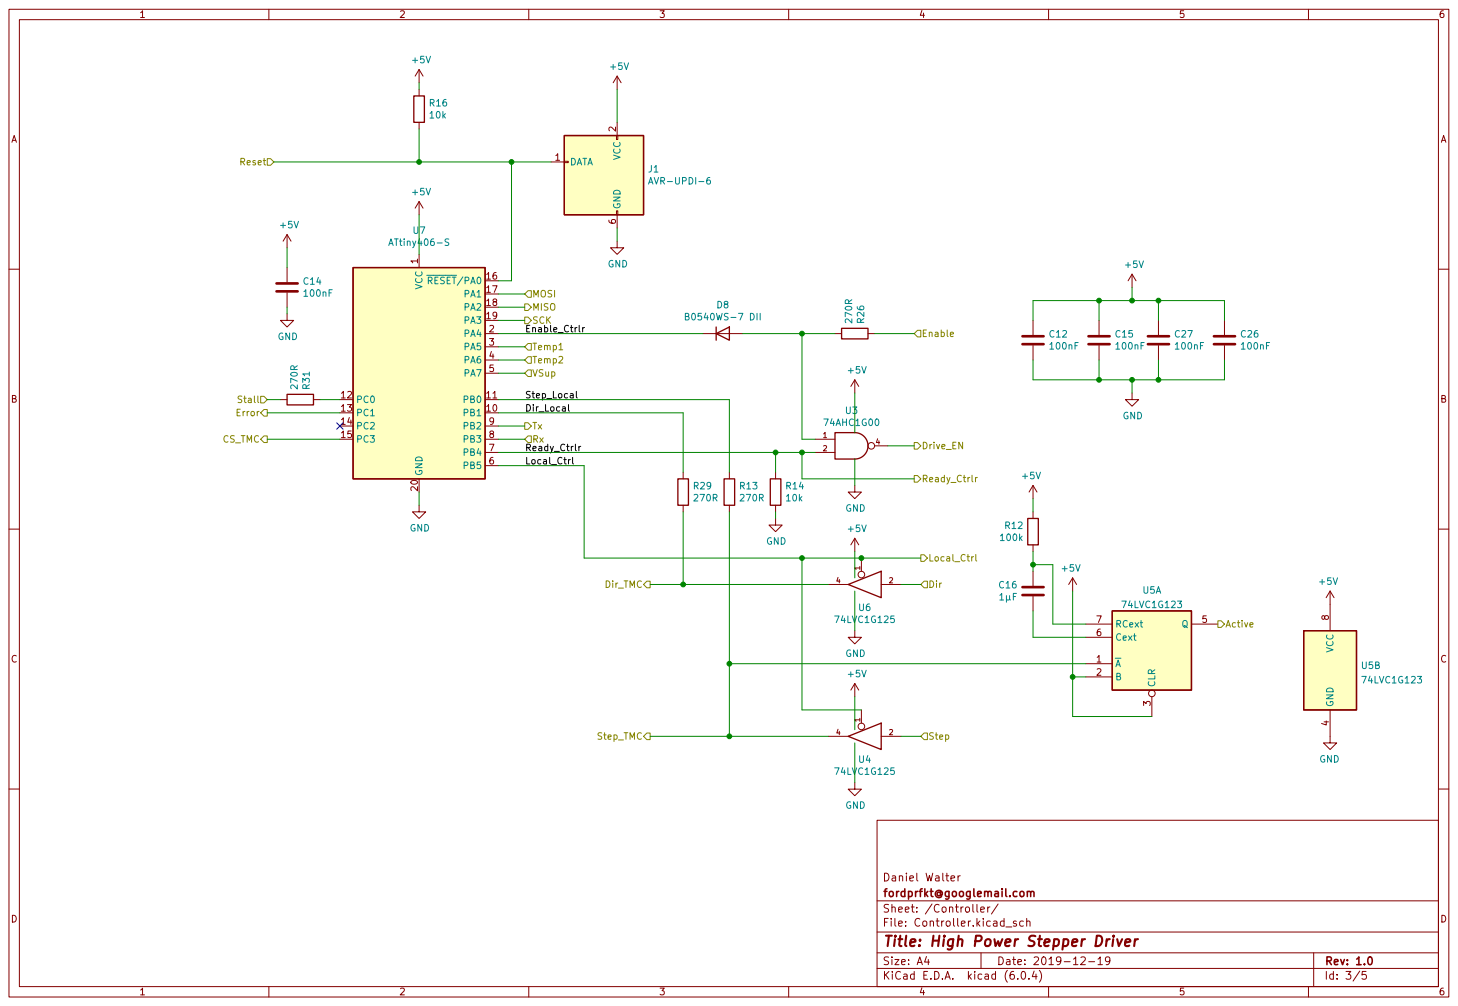
[picture p27: page 3]

Daniel Walter
File: Controller.kicad_sch Sheet: /Controller/ fordprfkt@googlemail.com

Id: 3/5 Title: High Power Stepper Driver

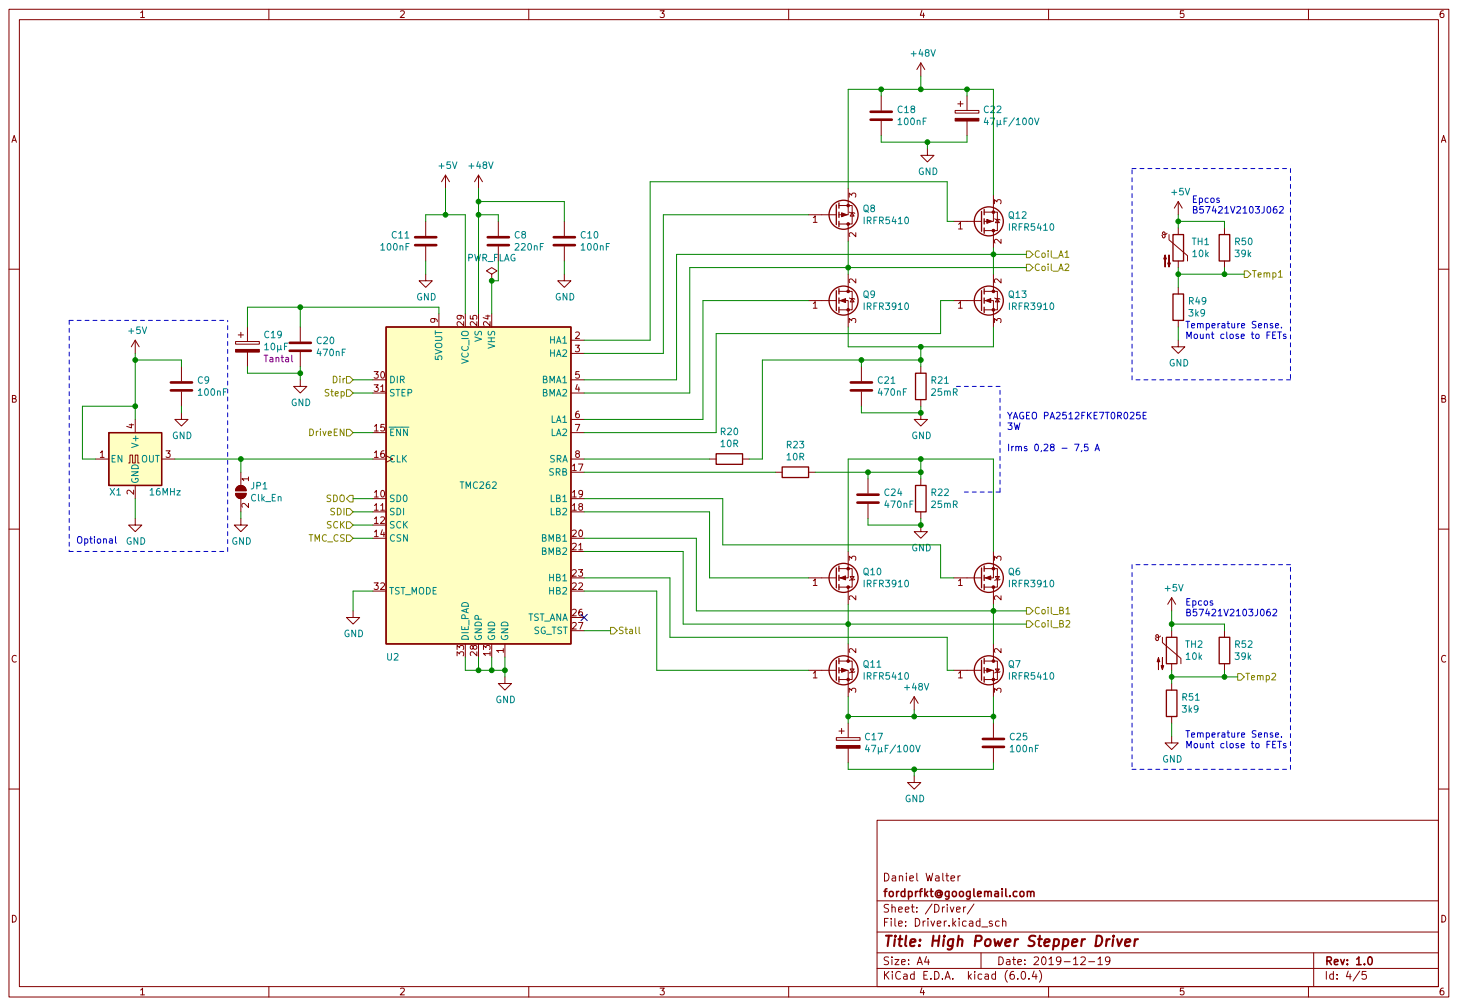
[picture p28: page 4]

Epcos B57421V2103J062 Temperature Sense. Mount close to FETs Optional

1 SD0 10 SDI 11 SCK 12 GND 13 CSN 14 ~{ENN} 15 CLK 16 SRB 17

10k +5V GND
Epcos B57421V2103J062 Temperature Sense. Mount close to FETs

File: Driver.kicad_sch Sheet: /Driver/ fordprfkt@googlemail.com

Id: 4/5 Title: High Power Stepper Driver

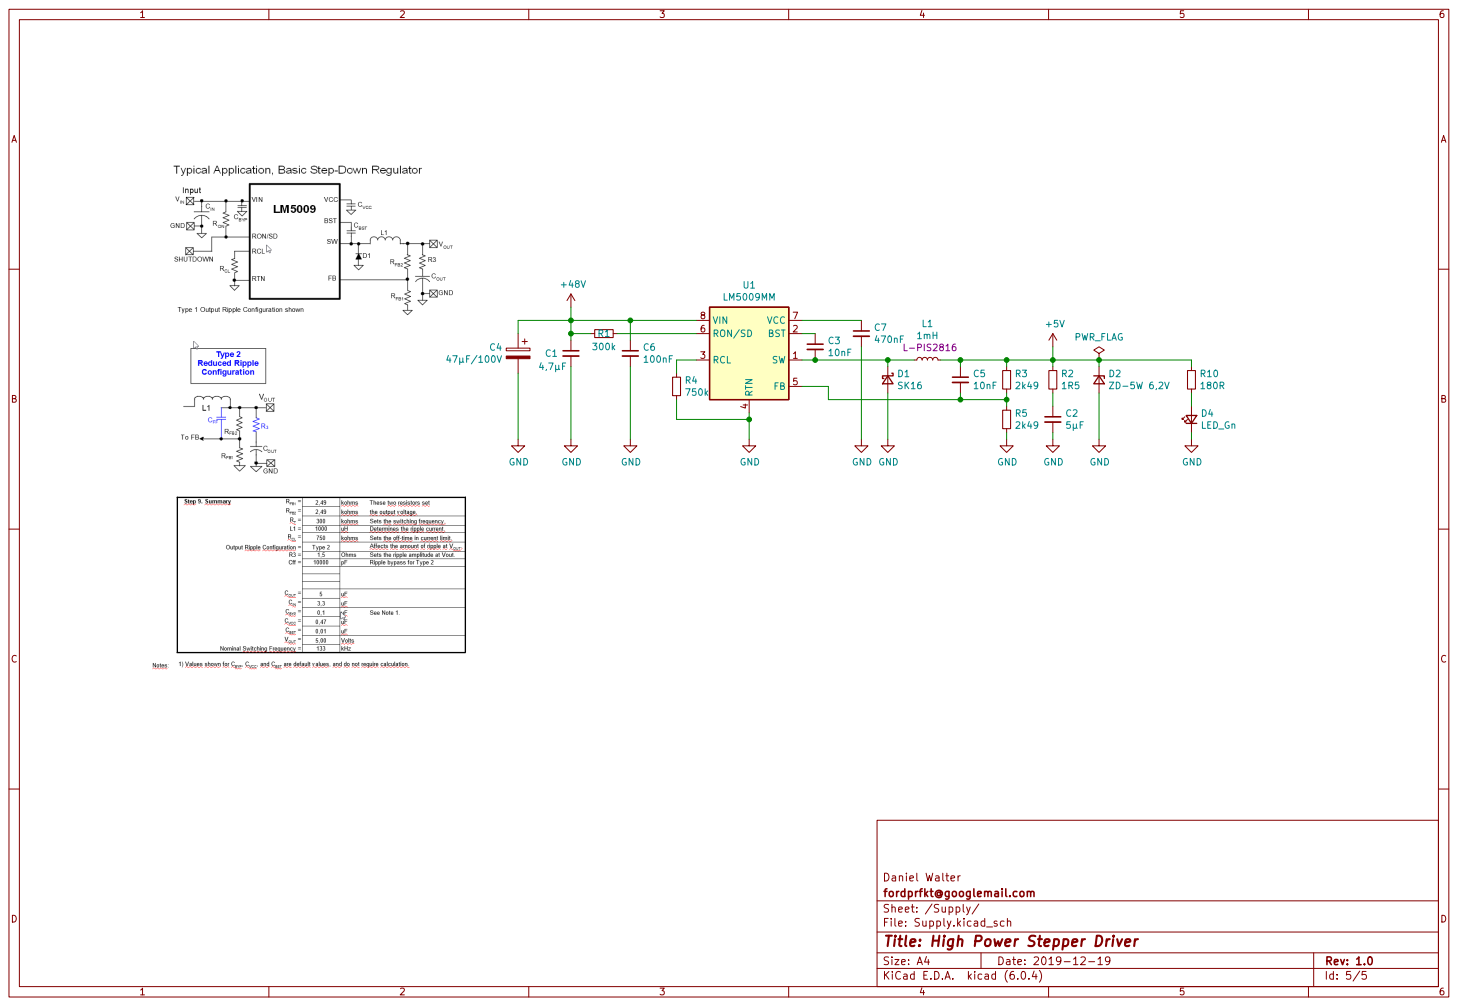
[picture p29: page 5]

4 FB 5 RON/SD 6 VCC 7 VIN 8 U1

fordprfkt@googlemail.com
Sheet: /Supply/
File: Supply.kicad_sch
Id: 5/5 Title: High Power Stepper Driver
