FordPrfkt/StepperController/(list of files, drawings)

Other design files:
Boards/StepperController/StepperController.dsn
