FordPrfkt/StepperController/boards/HighPowerDriver - Kopie/HPDriver/HPDriver.kicad_pcb

## KiCad design boards/HighPowerDriver - Kopie/HPDriver/HPDriver.kicad_pcb (2022-08-06, an earlier design)

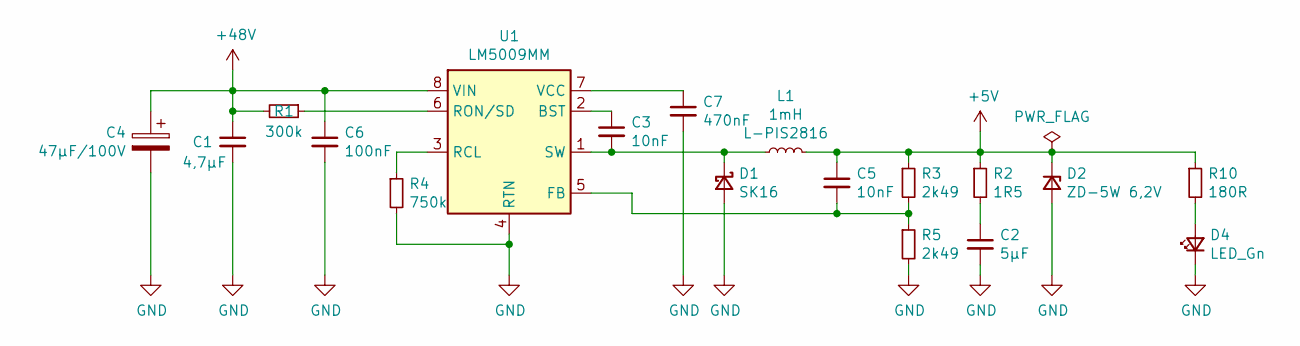
[picture p30: schematic Supply.kicad_sch, High Power Stepper Driver]

Parts:
C1: 4,7µF; C_1210_3225Metric
C2: 5µF; C_1210_3225Metric
C3, C5: 10nF; C_0805_2012Metric
C4: 47µF/100V; CP_Elec_8x10
C6: 100nF; C_0805_2012Metric
C7: 470nF; C_0805_2012Metric
D1: SK16; D_SMA
D2: ZD-5W 6,2V; D_SMB
D4: LED_Gn; LED_0805_2012Metric
L1: 1mH; L_7.3x7.3_H4.5
R1: 300k; R_0805_2012Metric
R2: 1R5; R_0805_2012Metric
R3, R5: 2k49; R_0805_2012Metric
R4: 750k; R_0805_2012Metric
R10: 180R; R_0805_2012Metric
U1: LM5009MM; MSOP-8_3x3mm_P0.65mm

Connections:
+5V: C5.1, D2.1 (K), L1.2, R2.1, R3.1, R10.1; also elsewhere on the board
+48V: C1.1, C4.1, C6.1, R1.2, U1.8 (VIN); also elsewhere on the board
GND: C1.2, C2.2, C4.2, C6.2, C7.2, D1.2 (A), D2.2 (A), D4.1 (K), R4.2, R5.2, U1.4 (RTN); also elsewhere on the board
unnamed: C2.1, R2.2
unnamed: C3.1, U1.2 (BST)
unnamed: C3.2, D1.1 (K), L1.1, U1.1 (SW)
unnamed: C5.2, R3.2, R5.1, U1.5 (FB)
unnamed: C7.1, U1.7 (VCC)
unnamed: D4.2 (A), R10.2
unnamed: R1.1, U1.6 (RON/SD)
unnamed: R4.1, U1.3 (RCL)

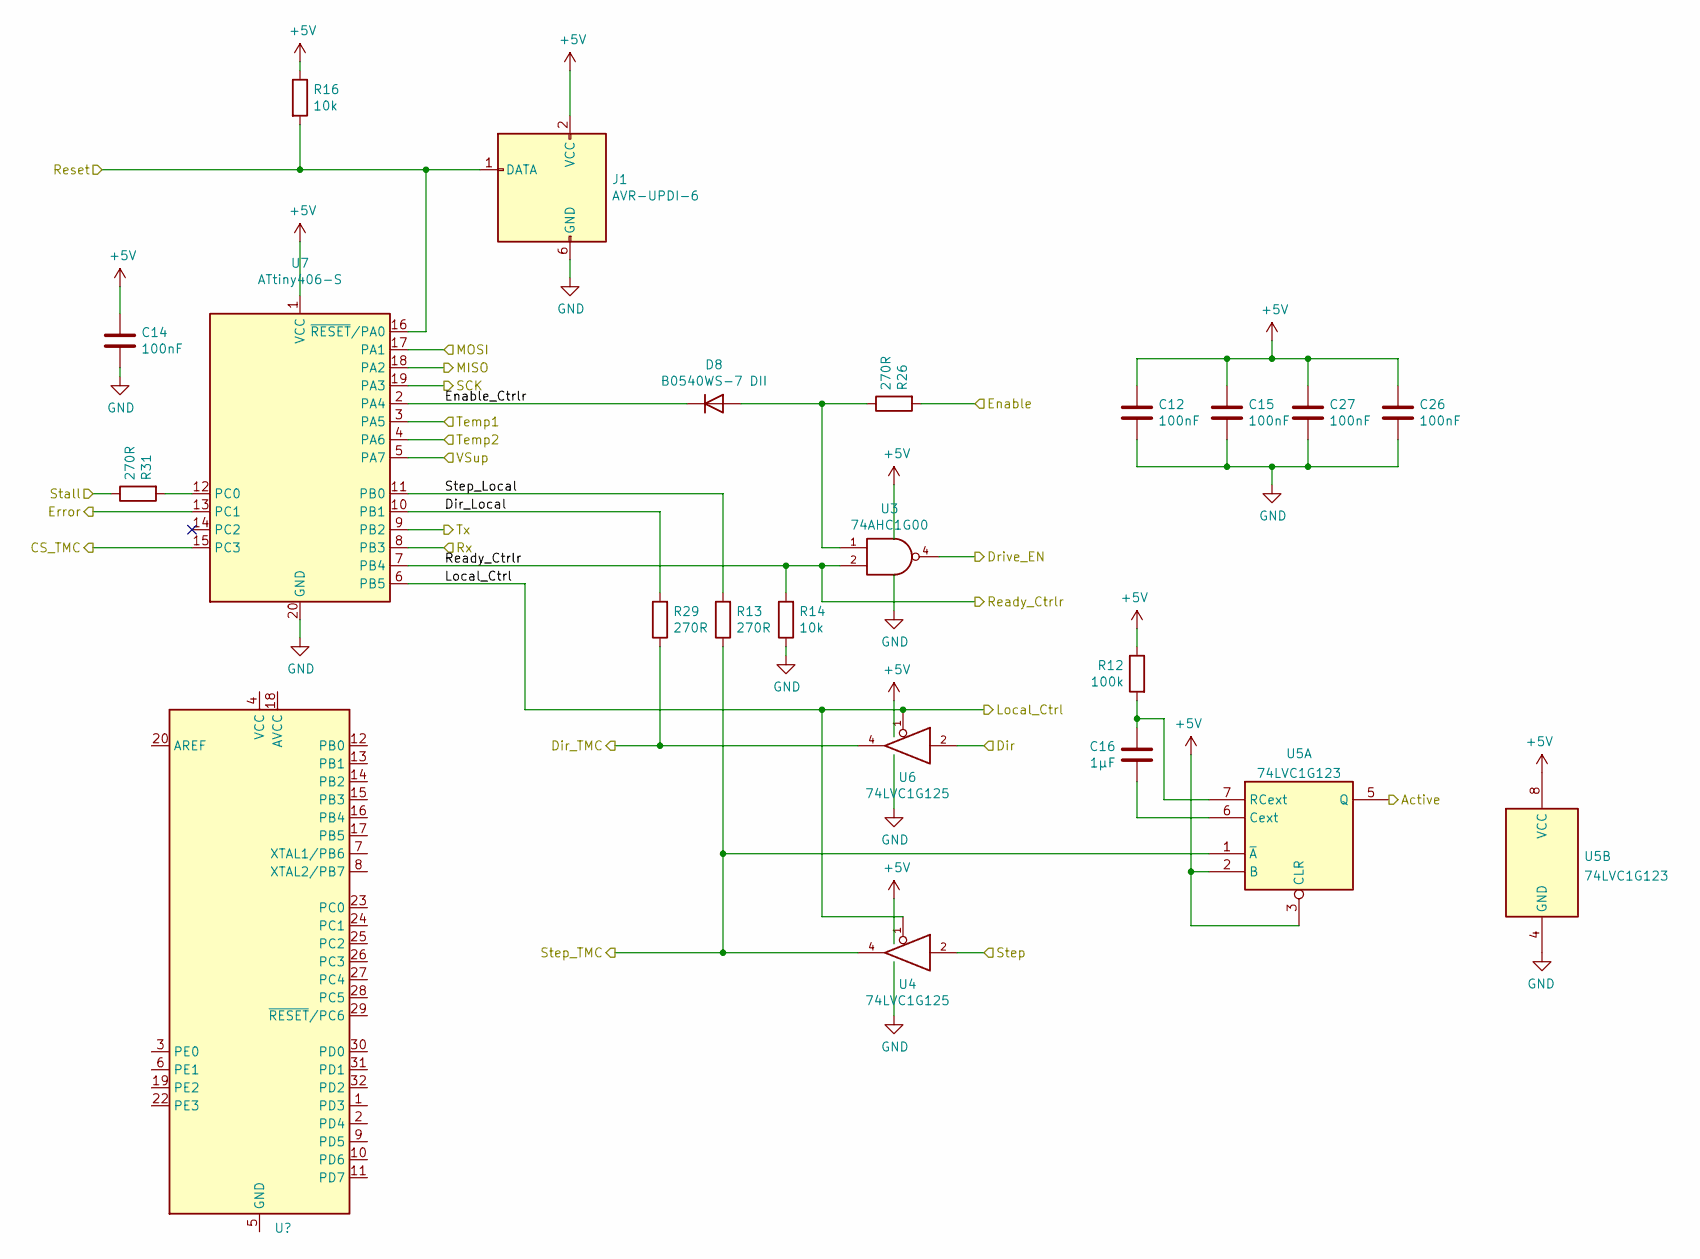
[picture p31: schematic Controller.kicad_sch, High Power Stepper Driver]

Parts:
C12, C14, C15, C26, C27: 100nF; C_0805_2012Metric
C16: 1µF; C_0805_2012Metric
D8: B0540WS-7 DII; D_SOD-323
J1: AVR-UPDI-6; IDC-Header_2x03_P2.54mm_Vertical
R12: 100k; R_0805_2012Metric
R13, R26, R29, R31: 270R; R_0805_2012Metric
R14, R16: 10k; R_0805_2012Metric
U3: 74AHC1G00; SOT-23-5
U4, U6: 74LVC1G125; SOT-23-5
U5: 74LVC1G123; VSSOP-8_3.0x3.0mm_P0.65mm
U7: ATtiny406-S; SOIC-20W_7.5x12.8mm_P1.27mm

Connections:
+5V: C12.1, C14.1, C15.1, C26.1, C27.1, J1.2 (VCC), R12.1, R16.1, U3.5 (VCC), U4.5 (VCC), U5.2 (B), U5.3 (CLR), U5.8 (VCC), U6.5 (VCC), U7.1 (VCC); also elsewhere on the board
/Connector/Active: U5.5 (Q); also elsewhere on the board
/Connector/Dir: U6.2; also elsewhere on the board
/Connector/Enable: R26.2; also elsewhere on the board
/Connector/Error: U7.13 (PC1); also elsewhere on the board
/Connector/Reset: J1.1 (DATA), R16.2, U7.16 (~RESET/PA0); also elsewhere on the board
/Connector/Rx: U7.8 (PB3); also elsewhere on the board
/Connector/Stall: R31.1; also elsewhere on the board
/Connector/Step: U4.2; also elsewhere on the board
/Connector/Tx: U7.9 (PB2); also elsewhere on the board
/Connector/VSup: U7.5 (PA7); also elsewhere on the board
/Controller/CS_TMC: U7.15 (PC3); also elsewhere on the board
/Controller/Dir_Local: R29.2, U7.10 (PB1)
/Controller/Dir_TMC: R29.1, U6.4; also elsewhere on the board
/Controller/Drive_EN: U3.4; also elsewhere on the board
/Controller/Enable_Ctrlr: D8.1 (K), U7.2 (PA4)
/Controller/Local_Ctrl: U4.1, U6.1, U7.6 (PB5); also elsewhere on the board
/Controller/MISO: U7.18 (PA2); also elsewhere on the board
/Controller/MOSI: U7.17 (PA1); also elsewhere on the board
/Controller/Ready_Ctrlr: R14.2, U3.2, U7.7 (PB4); also elsewhere on the board
/Controller/SCK: U7.19 (PA3); also elsewhere on the board
/Controller/Step_Local: R13.2, U7.11 (PB0)
/Controller/Step_TMC: R13.1, U4.4, U5.1 (~A); also elsewhere on the board
/Controller/Temp1: U7.3 (PA5); also elsewhere on the board
/Controller/Temp2: U7.4 (PA6); also elsewhere on the board
GND: C12.2, C14.2, C15.2, C26.2, C27.2, J1.6 (GND), R14.1, U3.3 (GND), U4.3 (GND), U5.4 (GND), U6.3 (GND), U7.20 (GND); also elsewhere on the board
unnamed: C16.1, U5.6 (Cext)
unnamed: C16.2, R12.2, U5.7 (RCext)
unnamed: D8.2 (A), R26.1, U3.1
unnamed: R31.2, U7.12 (PC0)

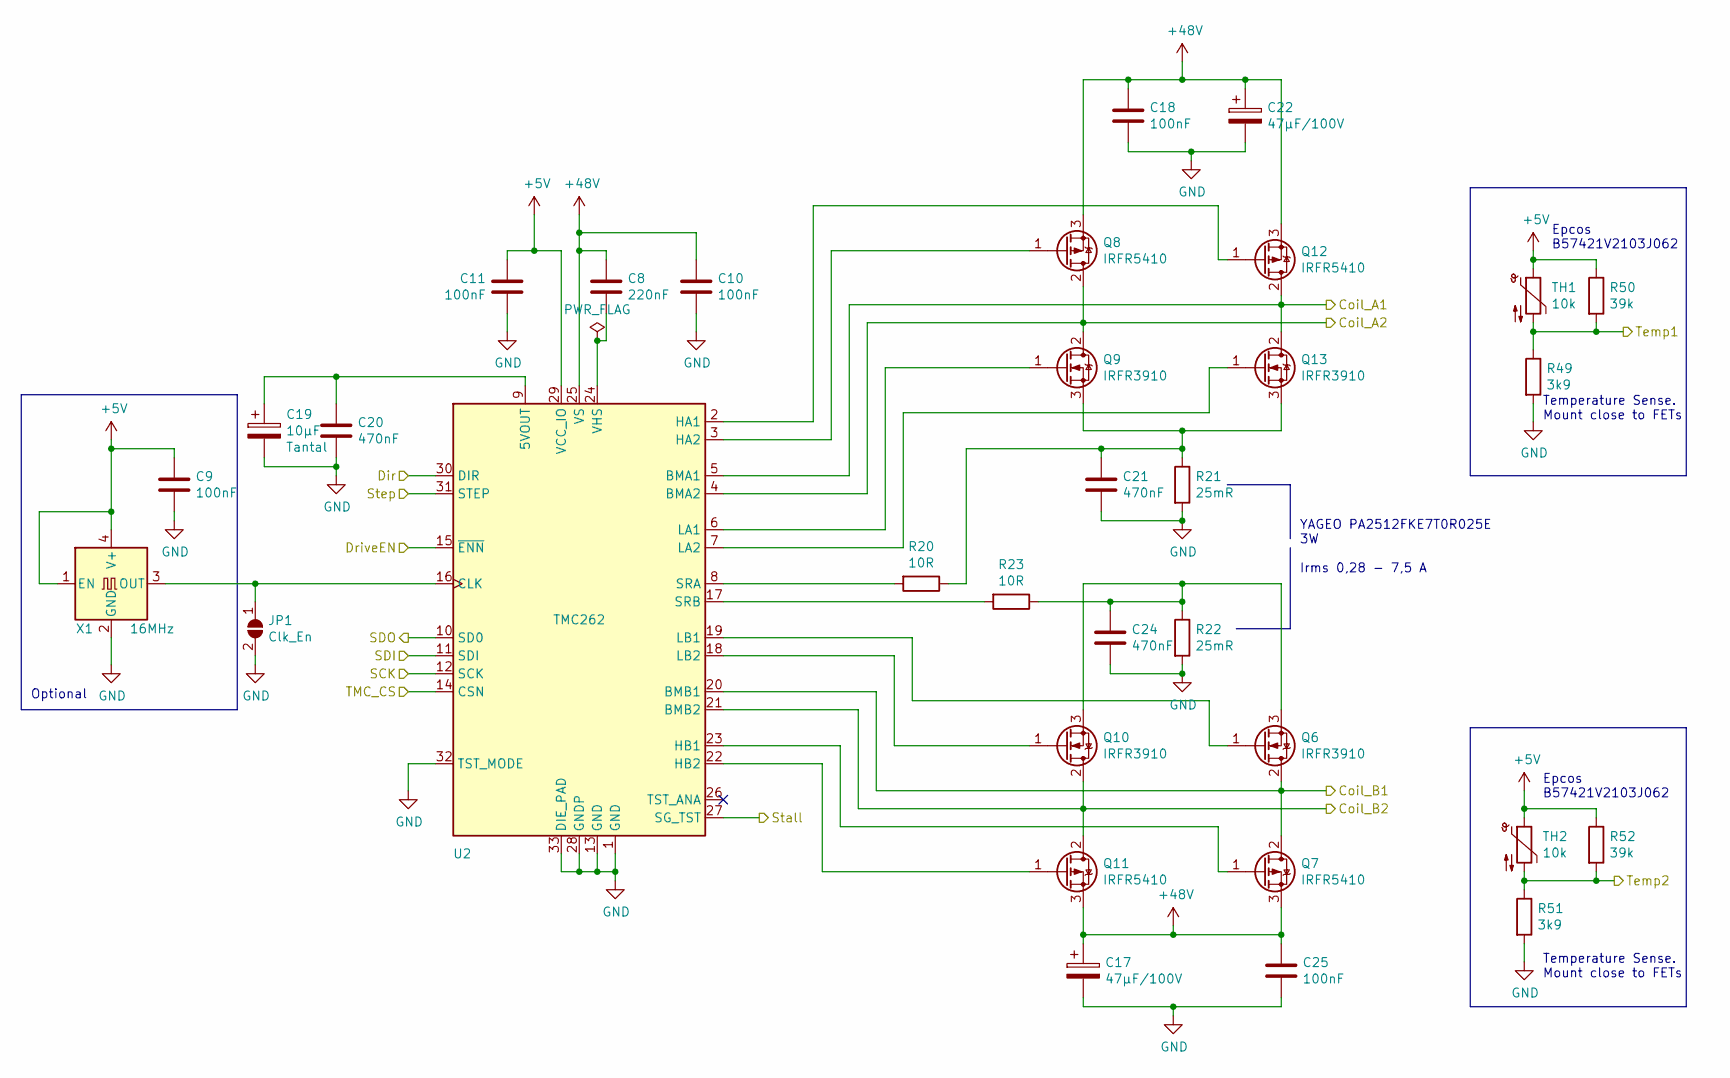
[picture p32: schematic Driver.kicad_sch, High Power Stepper Driver]

Parts:
C8: 220nF; C_0805_2012Metric
C9, C10, C11, C18, C25: 100nF; C_0805_2012Metric
C17, C22: 47µF/100V; CP_Elec_10x10
C19: 10µF; CP_EIA-3528-21_Kemet-B
C20, C21, C24: 470nF; C_0805_2012Metric
JP1: Clk_En; SolderJumper-2_P1.3mm_Open_TrianglePad1.0x1.5mm
Q6, Q9, Q10, Q13: IRFR3910; TO-252-2
Q7, Q8, Q11, Q12: IRFR5410; TO-252-2
R20, R23: 10R; R_0805_2012Metric
R21, R22: 25mR; R_2512_6332Metric
R49, R51: 3k9; R_0805_2012Metric
R50, R52: 39k; R_0805_2012Metric
TH1, TH2: 10k; R_0805_2012Metric
U2: TMC262; QFN-32-1EP_5x5mm_P0.5mm_EP3.45x3.45mm
X1: 16MHz; Oscillator_SMD_EuroQuartz_XO53-4Pin_5.0x3.2mm_HandSoldering

Connections:
+5V: C9.1, C11.1, R50.1, R52.1, TH1.1, TH2.1, U2.29 (VCC_IO), X1.1 (EN), X1.4 (V+); also elsewhere on the board
+48V: C8.1, C10.1, C17.1, C18.1, C22.1, C25.1, Q7.3 (S), Q8.3 (S), Q11.3 (S), Q12.3 (S), U2.25 (VS); also elsewhere on the board
/Connector/Coil_A1: Q12.2 (D), Q13.2 (D), U2.5 (BMA1); also elsewhere on the board
/Connector/Coil_A2: Q8.2 (D), Q9.2 (D), U2.4 (BMA2); also elsewhere on the board
/Connector/Coil_B1: Q6.2 (D), Q7.2 (D), U2.20 (BMB1); also elsewhere on the board
/Connector/Coil_B2: Q10.2 (D), Q11.2 (D), U2.21 (BMB2); also elsewhere on the board
/Connector/Stall: U2.27 (SG_TST); also elsewhere on the board
/Controller/CS_TMC: U2.14 (CSN); also elsewhere on the board
/Controller/Dir_TMC: U2.30 (DIR); also elsewhere on the board
/Controller/Drive_EN: U2.15 (~ENN); also elsewhere on the board
/Controller/MISO: U2.11 (SDI); also elsewhere on the board
/Controller/MOSI: U2.10 (SD0); also elsewhere on the board
/Controller/SCK: U2.12 (SCK); also elsewhere on the board
/Controller/Step_TMC: U2.31 (STEP); also elsewhere on the board
/Controller/Temp1: R49.1, R50.2, TH1.2; also elsewhere on the board
/Controller/Temp2: R51.1, R52.2, TH2.2; also elsewhere on the board
GND: C9.2, C10.2, C11.2, C17.2, C18.2, C19.2, C20.2, C21.2, C22.2, C24.2, C25.2, JP1.2 (B), R21.2, R22.2, R49.2, R51.2, U2.1 (GND), U2.13 (GND), U2.28 (GNDP), U2.32 (TST_MODE), U2.33 (DIE_PAD), X1.2 (GND); also elsewhere on the board
unnamed: C8.2, U2.24 (VHS)
unnamed: C19.1, C20.1, U2.9 (5VOUT)
unnamed: C21.1, Q9.3 (S), Q13.3 (S), R20.1, R21.1
unnamed: C24.1, Q6.3 (S), Q10.3 (S), R22.1, R23.1
unnamed: JP1.1 (A), U2.16 (CLK), X1.3 (OUT)
unnamed: Q6.1 (G), U2.19 (LB1)
unnamed: Q7.1 (G), U2.23 (HB1)
unnamed: Q8.1 (G), U2.3 (HA2)
unnamed: Q9.1 (G), U2.6 (LA1)
unnamed: Q10.1 (G), U2.18 (LB2)
unnamed: Q11.1 (G), U2.22 (HB2)
unnamed: Q12.1 (G), U2.2 (HA1)
unnamed: Q13.1 (G), U2.7 (LA2)
unnamed: R20.2, U2.8 (SRA)
unnamed: R23.2, U2.17 (SRB)

Notes on the sheet:
YAGEO PA2512FKE7T0R025E 3W Irms 0,28 - 7,5 A
Epcos B57421V2103J062
Temperature Sense. Mount close to FETs
Optional

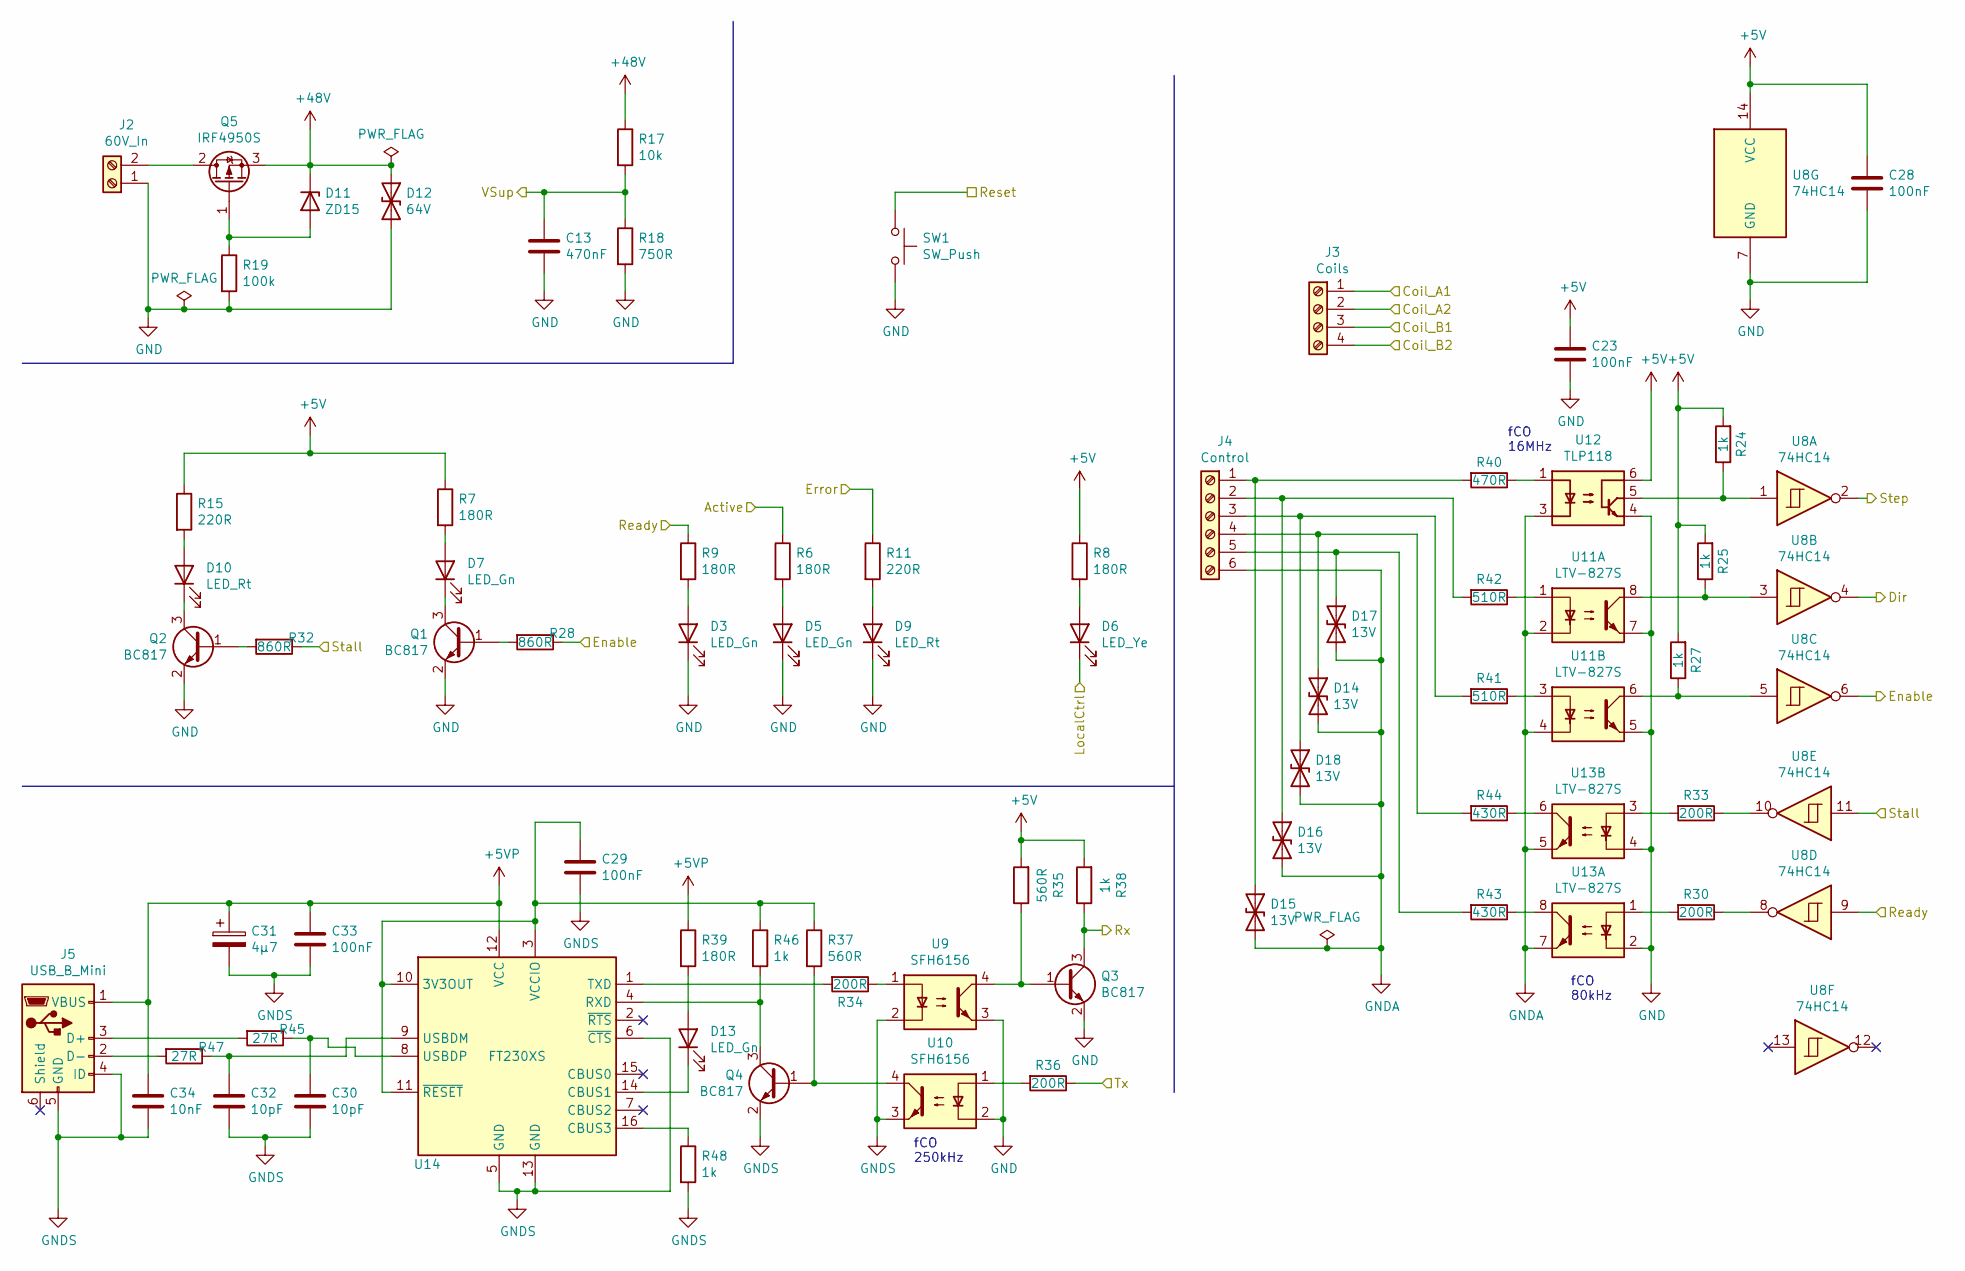
[picture p33: schematic Connector.kicad_sch, High Power Stepper Driver]

Parts:
C13: 470nF; C_0805_2012Metric
C23, C28, C29, C33: 100nF; C_0805_2012Metric
C30, C32: 10pF; C_0805_2012Metric
C31: 4µ7; C_0805_2012Metric_Pad1.15x1.40mm_HandSolder
C34: 10nF; C_0805_2012Metric
D3, D5, D7, D13: LED_Gn; LED_0805_2012Metric
D6: LED_Ye; LED_0805_2012Metric
D9, D10: LED_Rt; LED_0805_2012Metric
D11: ZD15; D_SOT-23_ANK
D12: 64V; D_SMB
D14, D15, D16, D17, D18: 13V; D_SMA
J2: 60V_In; PhoenixContact_MSTBA_2,5_2-G_1x02_P5.00mm_Horizontal
J3: Coils; PhoenixContact_MSTBA_2,5_4-G_1x04_P5.00mm_Horizontal
J4: Control; PhoenixContact_MSTBA_2,5_6-G_1x06_P5.00mm_Horizontal
J5: USB_B_Mini; USB_Mini-B_Lumberg_2486_01_Horizontal
Q1, Q2, Q3, Q4: BC817; SOT-23
Q5: IRF4950S; TO-263-2
R6, R7, R8, R9, R39: 180R; R_0805_2012Metric
R11, R15: 220R; R_0805_2012Metric
R17: 10k; R_0805_2012Metric
R18: 750R; R_0805_2012Metric
R19: 100k; R_0805_2012Metric
R24, R25, R27, R38, R46, R48: 1k; R_0805_2012Metric
R28, R32: 860R; R_0805_2012Metric
R30, R33, R34, R36: 200R; R_0805_2012Metric
R35, R37: 560R; R_0805_2012Metric
R40: 470R; R_0805_2012Metric
R41, R42: 510R; R_0805_2012Metric
R43, R44: 430R; R_0805_2012Metric
R45, R47: 27R; R_0805_2012Metric
SW1: SW_Push; SW_SPST_B3S-1000
U8: 74HC14; SOIC-14_3.9x8.7mm_P1.27mm
U9, U10: SFH6156; SMDIP-4_W7.62mm
U11, U13: LTV-827S; SMDIP-8_W9.53mm
U12: TLP118; MFSOP6-5_4.4x3.6mm_P1.27mm
U14: FT230XS; SSOP-16_3.9x4.9mm_P0.635mm

Connections:
+5V: C23.1, C28.1, R7.1, R8.1, R15.1, R24.2, R25.2, R27.2, R35.2, R38.2, U8.14 (VCC), U12.6; also elsewhere on the board
+5VP: C31.1, C33.1, C34.1, J5.1 (VBUS), R39.1, U14.12 (VCC)
+48V: D11.1 (K), D12.1 (A1), Q5.3 (S), R17.1; also elsewhere on the board
/Connector/Active: R6.1; also elsewhere on the board
/Connector/Coil_A1: J3.1; also elsewhere on the board
/Connector/Coil_A2: J3.2; also elsewhere on the board
/Connector/Coil_B1: J3.3; also elsewhere on the board
/Connector/Coil_B2: J3.4; also elsewhere on the board
/Connector/Dir: U8.4; also elsewhere on the board
/Connector/Enable: R28.1, U8.6; also elsewhere on the board
/Connector/Error: R11.1; also elsewhere on the board
/Connector/Reset: SW1.1; also elsewhere on the board
/Connector/Rx: Q3.3 (C), R38.1; also elsewhere on the board
/Connector/Stall: R32.1, U8.11; also elsewhere on the board
/Connector/Step: U8.2; also elsewhere on the board
/Connector/Tx: R36.1; also elsewhere on the board
/Connector/VSup: C13.1, R17.2, R18.1; also elsewhere on the board
/Controller/Local_Ctrl: D6.1 (K); also elsewhere on the board
/Controller/Ready_Ctrlr: R9.1, U8.9; also elsewhere on the board
GND: C13.2, C23.2, C28.2, D3.1 (K), D5.1 (K), D9.1 (K), D12.2 (A2), J2.1, Q1.2 (E), Q2.2 (E), Q3.2 (E), R18.2, R19.2, SW1.2, U8.7 (GND), U9.3, U10.2, U11.5, U11.7, U12.4, U13.2, U13.4; also elsewhere on the board
GNDA: D14.2 (A2), D15.2 (A2), D16.2 (A2), D17.2 (A2), D18.2 (A2), J4.6, U11.2, U11.4, U12.3, U13.5, U13.7
GNDS: C29.2, C30.2, C31.2, C32.2, C33.2, C34.2, J5.4 (ID), J5.5 (GND), Q4.2 (E), R48.2, U9.2, U10.3, U14.5 (GND), U14.6 (~CTS), U14.13 (GND)
unnamed: C29.1, R37.1, R46.1, U14.3 (VCCIO), U14.10 (3V3OUT), U14.11 (~RESET)
unnamed: C30.1, R45.1, U14.8 (USBDP)
unnamed: C32.1, R47.1, U14.9 (USBDM)
unnamed: D3.2 (A), R9.2
unnamed: D5.2 (A), R6.2
unnamed: D6.2 (A), R8.2
unnamed: D7.1 (K), Q1.3 (C)
unnamed: D7.2 (A), R7.2
unnamed: D9.2 (A), R11.2
unnamed: D10.1 (K), Q2.3 (C)
unnamed: D10.2 (A), R15.2
unnamed: D11.2 (A), Q5.1 (G), R19.1
unnamed: D13.1 (K), U14.14 (CBUS1)
unnamed: D13.2 (A), R39.2
unnamed: D14.1 (A1), J4.4, R44.2
unnamed: D15.1 (A1), J4.1, R40.2
unnamed: D16.1 (A1), J4.2, R42.2
unnamed: D17.1 (A1), J4.5, R43.2
unnamed: D18.1 (A1), J4.3, R41.2
unnamed: J2.2, Q5.2 (D)
unnamed: J5.2 (D-), R47.2
unnamed: J5.3 (D+), R45.2
unnamed: Q1.1 (B), R28.2
unnamed: Q2.1 (B), R32.2
unnamed: Q3.1 (B), R35.1, U9.4
unnamed: Q4.1 (B), R37.2, U10.4
unnamed: Q4.3 (C), R46.2, U14.4 (RXD)
unnamed: R24.1, U8.1, U12.5
unnamed: R25.1, U8.3, U11.8
unnamed: R27.1, U8.5, U11.6
unnamed: R30.1, U8.8
unnamed: R30.2, U13.1
unnamed: R33.1, U8.10
unnamed: R33.2, U13.3
unnamed: R34.1, U9.1
unnamed: R34.2, U14.1 (TXD)
unnamed: R36.2, U10.1
unnamed: R40.1, U12.1
unnamed: R41.1, U11.3
unnamed: R42.1, U11.1
unnamed: R43.1, U13.8
unnamed: R44.1, U13.6
unnamed: R48.1, U14.16 (CBUS3)

Notes on the sheet:
fCO 80kHz
fCO 16MHz
fCO 250kHz

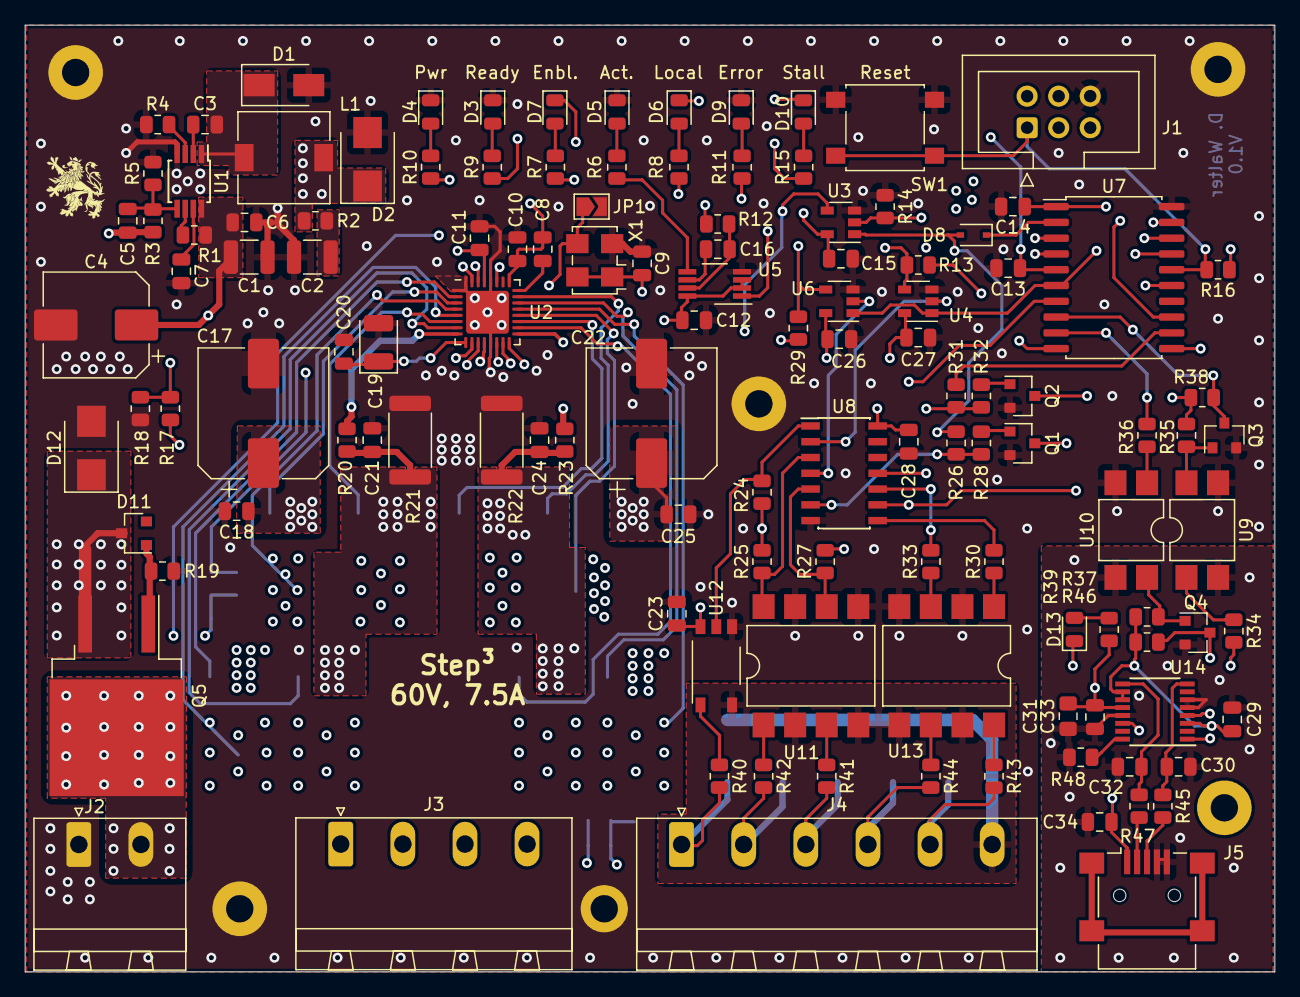
[picture p34: board HPDriver.kicad_pcb from above]

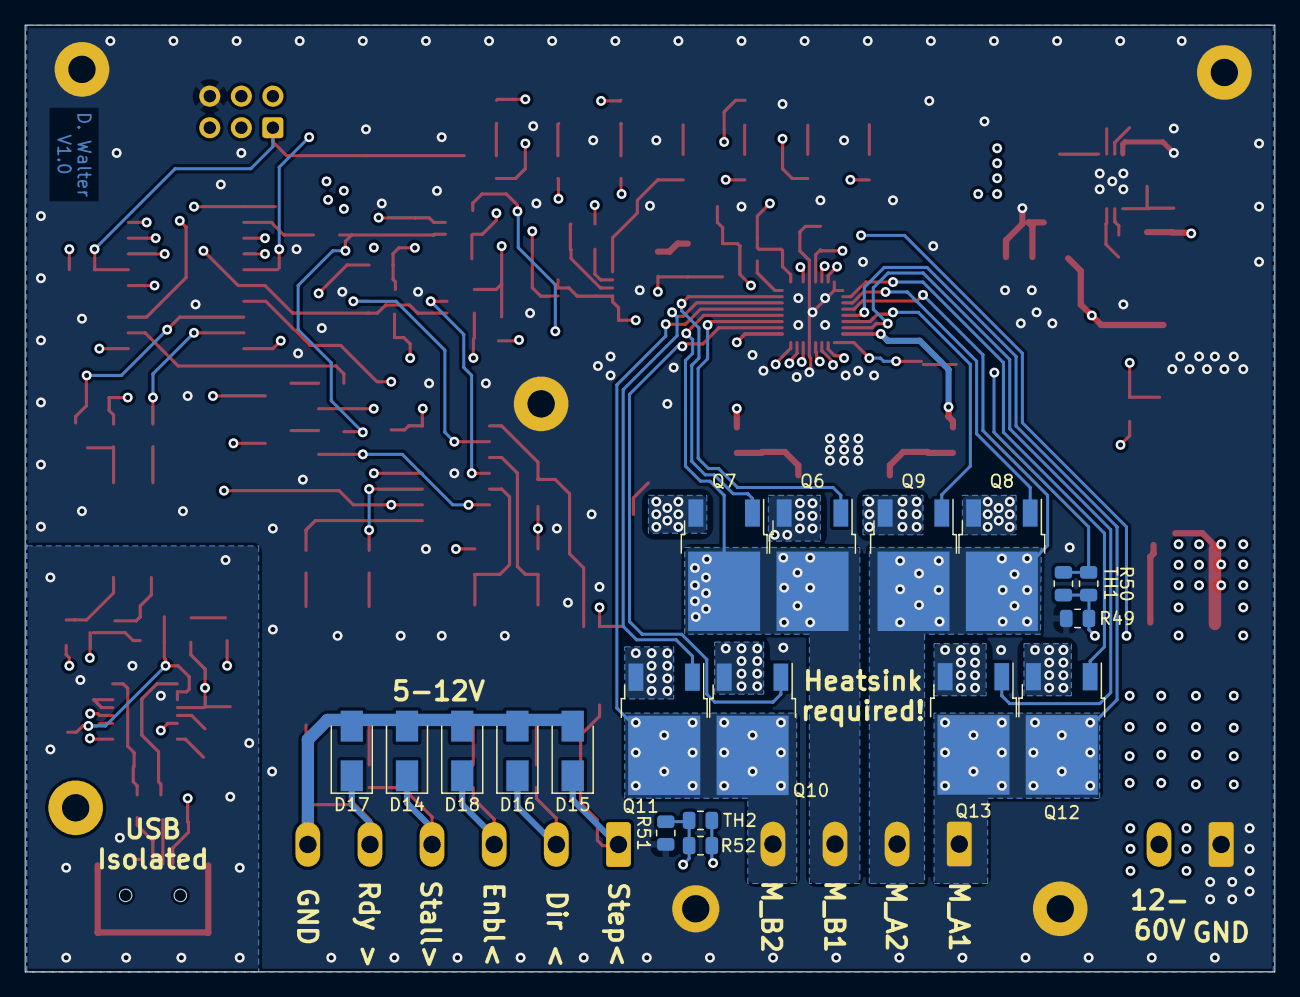
[picture p35: board HPDriver.kicad_pcb from below]

Board: 4 copper layers, 100.6 x 76.2 mm, 142 parts (19 on the bottom side), 104 nets.
