FordPrfkt/StepperController/Boards/HandController/HandController.kicad_pcb

## KiCad design Boards/HandController/HandController.kicad_pcb (2018-02-11)

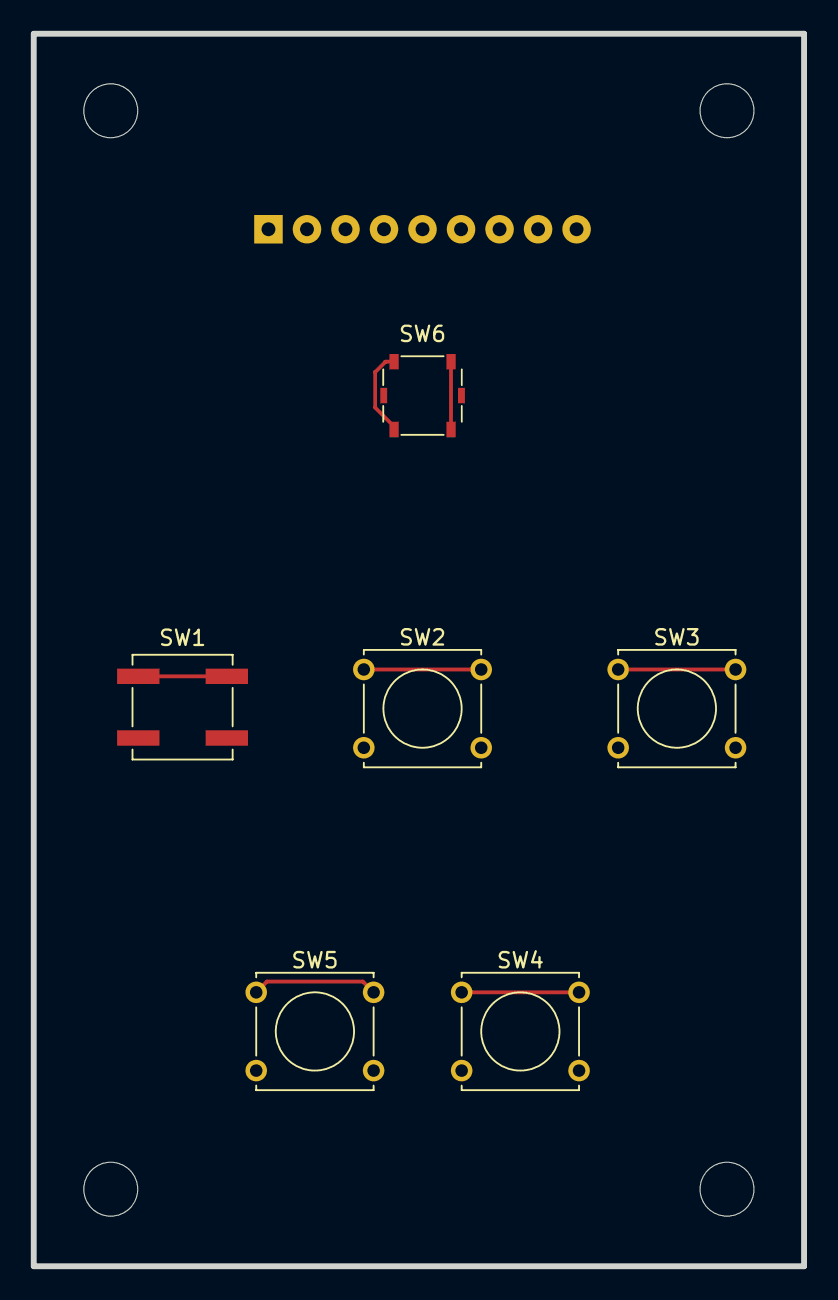
[picture p36: board HandController.kicad_pcb from above]

Board: 2 copper layers, 50.0 x 80.0 mm, 7 parts (1 on the bottom side), 8 nets.

Parts:
J1: Conn_01x09; JST_EH_B09B-EH-A_09x2.50mm_Straight
SW1: SW_Push; SW_SPST_B3SL-1002P
SW2, SW3, SW4, SW5: SW_Push; SW_Tactile_Straight_KSA0Axx1LFTR
SW6: Rotary_Encoder; SW_SPST_Panasonic_EVQPL_3PL_5PL_PT_A08

Connections:
GND: J1.9, SW1.2, SW2.2, SW3.2, SW4.2, SW5.2
unnamed: J1.1, SW6.1
unnamed: J1.2, SW6.2
unnamed: J1.4, SW1.1
unnamed: J1.5, SW2.1
unnamed: J1.6, SW3.1
unnamed: J1.7, SW4.1
unnamed: J1.8, SW5.1
