FordPrfkt/StepperController/Boards/StepperController/StepperController.kicad_pcb

## KiCad design Boards/StepperController/StepperController.kicad_pcb (2018-02-11)

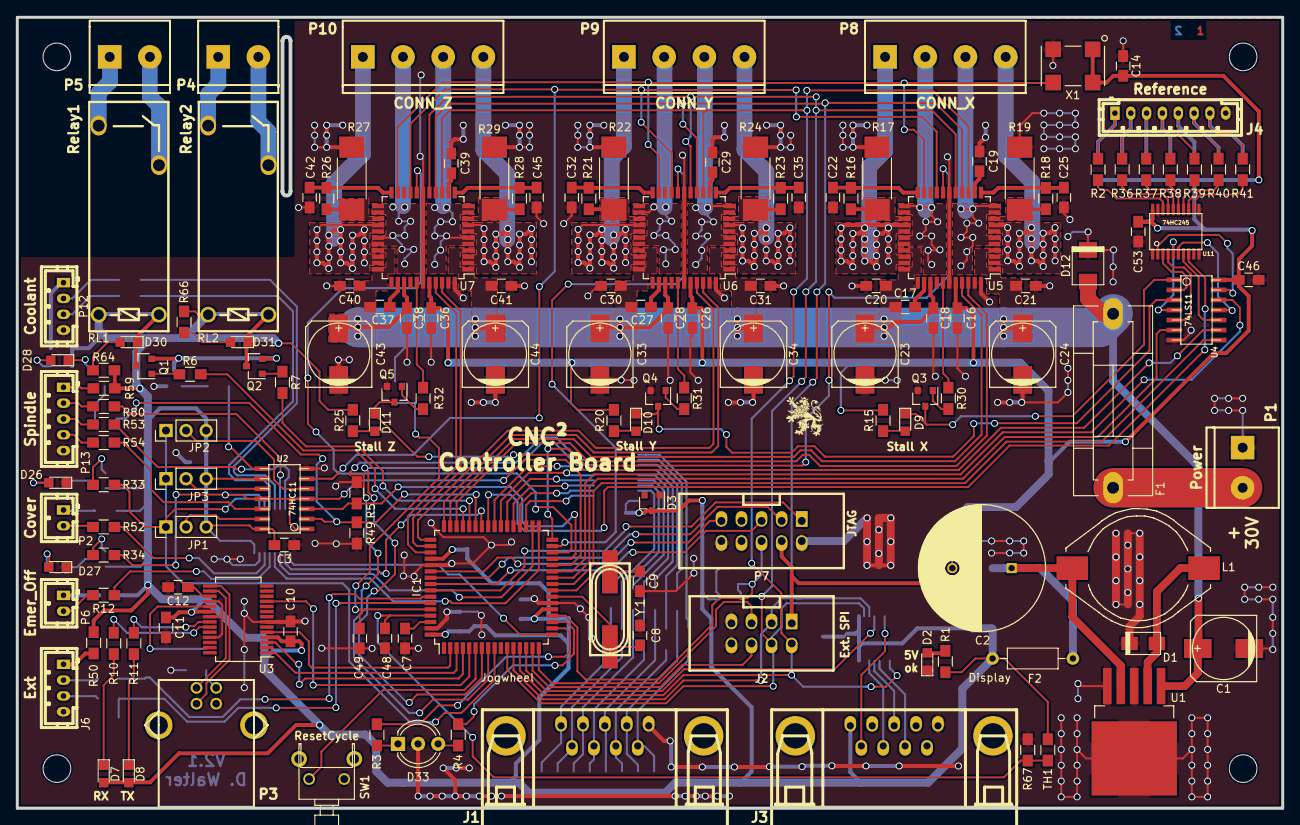
[picture p37: board StepperController.kicad_pcb from above]

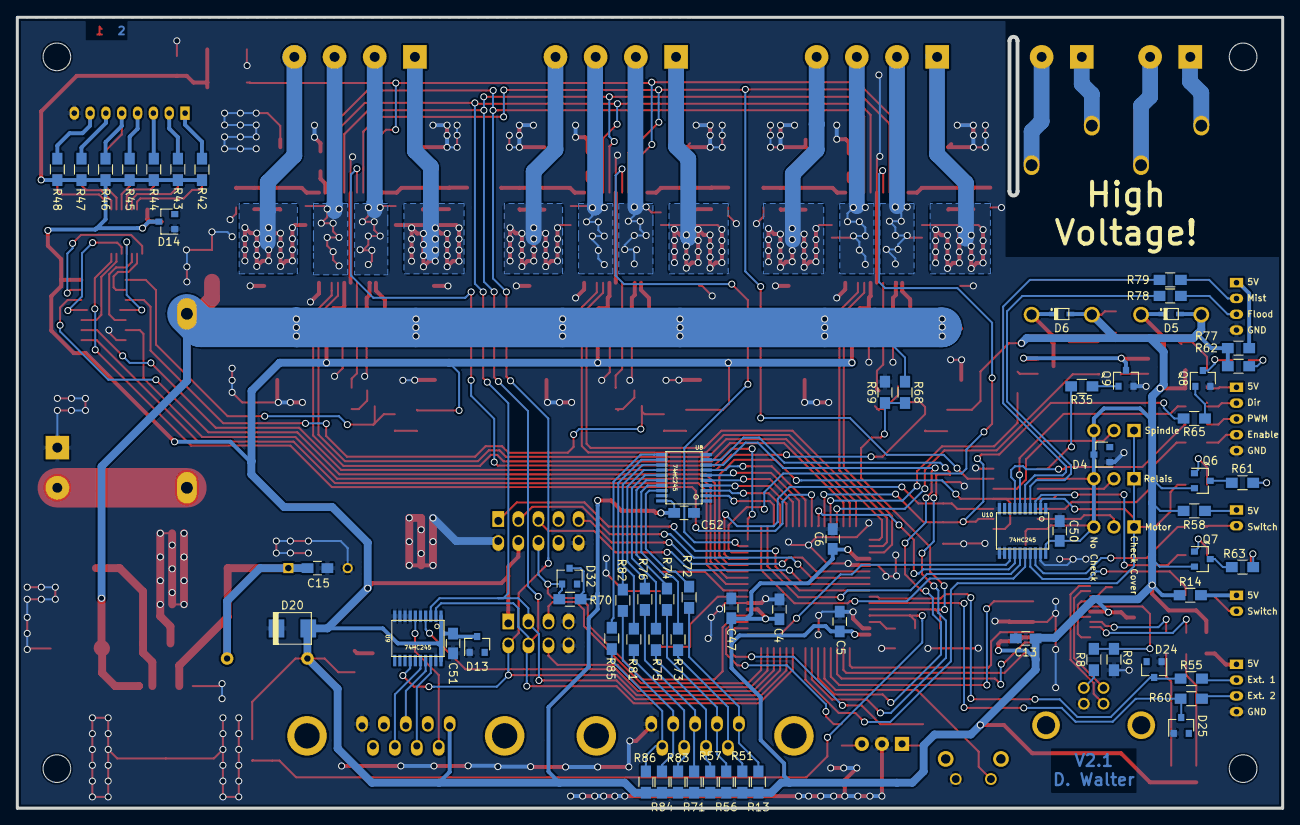
[picture p38: board StepperController.kicad_pcb from below]

Board: 2 copper layers, 160.0 x 100.0 mm, 213 parts (65 on the bottom side), 204 nets.

Parts:
C1, C23, C24, C33, C34, C43, C44: 100µF; c_elec_8x10.5
C2: 1000µF; C_Radial_D16_L25_P7.5
C3, C4, C5, C6, C7, C10, C12, C14, C16, C17, C18, C20, C21, C26, C27, C28, C30, C31, C36, C37, C38, C40, C41, C46, C48, C49, C50, C51, C52, C53: 100nF; C_0805_HandSoldering
C8, C9: 22pF; C_0805_HandSoldering
C11: 100nf; C_0805_HandSoldering
C13: 4,7µF; C_0805_HandSoldering
C15, C47: 10µF; C_0805_HandSoldering
C19, C29, C32, C39: 470nF; C_0805_HandSoldering
C22, C25, C35, C42, C45: 10nF; C_0805_HandSoldering
D1: SK34; do214ac
D2: LED_GN; LED_0805
D3, D4, D13, D14, D24, D25: ZMY5,6; D_SOT-23_ANK
D5, D6: 1N4148; sod323
D7, D8: LED_YE; LED_0805
D9, D10, D11: LED_RT; LED_0805
D12: SM6T 30CA; do214aa
D20: P6SMB 6,8A; do214aa
D26, D27: LED_Rd; LED_0805
D28, D30, D31: LED_Gn; LED_0805
D32: ZMY5.6; D_SOT-23_ANK
D33: Led_x2; LED_D5.0mm-3
F1: 10AT; Fuseholder5x20_horiz_SemiClosed_Casing10x25mm
F2: 4AT; R_Axial_DIN0207_L6.3mm_D2.5mm_P10.16mm_Horizontal
IC1: ATMEGA128-A; TQFP-64_14x14mm_Pitch0.8mm
J1, J3: DB9_Female; DB_9F
J2: SPI_Extern; vasch_strip_4x2
J4: Reference; b8b-ph-kl
J6: Ext; b4b-ph-kl
JP1, JP2, JP3: JUMPER3; Pin_Header_Straight_1x03_Pitch2.54mm
L1: L-PISR 100µH; Choke_SMD_PISR_Handsoldering_FASTRON
P1: Power; mors_2p
P2: Cover; b2b-ph-kl
P3: USB_B; conn_usb_B
P4: Relay2; mors_2p
P5: Relay1; mors_2p
P6: Emer_Off; b2b-ph-kl
P7: JTAG; vasch_strip_5x2
P8: CONN_X; mors_4p
P9: CONN_Y; mors_4p
P10: CONN_Z; mors_4p
P12: Coolant; b4b-ph-kl
P13: Spindle; b5b-ph-kl
Q1, Q2, Q3, Q4, Q5, Q8, Q9: BC817-40; SOT-23
Q6, Q7: BC807-40; SOT-23
R1, R3, R62, R64, R66: 140R; R_0805_HandSoldering
R2, R12, R14, R36, R37, R38, R39, R40, R41, R52, R53, R54, R55, R58, R60, R72, R73, R74, R75, R76, R78, R79, R80, R81, R82, R85: 100R; R_0805_HandSoldering
R4, R15, R20, R25, R61, R63: 160R; R_0805_HandSoldering
R5, R9, R49: 10k; R_0805_HandSoldering
R6, R7, R33, R34, R35: 1k; R_0805_HandSoldering
R8, R13, R30, R31, R32, R42, R43, R44, R45, R46, R47, R48, R51, R56, R57, R65, R71, R83, R84, R86: 4k7; R_0805_HandSoldering
R10, R11: 150R; R_0805_HandSoldering
R16, R18, R23, R26, R28: 22R; R_0805_HandSoldering
R17, R19, R24, R27, R29: 100mR; R_2512_HandSoldering
R21, R50, R59, R77: 10R; R_0805_HandSoldering
R22: 150mR; R_2512_HandSoldering
R67: 3k6; R_0805_HandSoldering
R68: 8k6; R_0805_HandSoldering
R69: 1k2; R_0805_HandSoldering
R70: 12k; R_0805_HandSoldering
RL1, RL2: FINDER-36.11-4301; Fujiutsu_JS-MT
SW1: ResetCycle; SW_0773
TH1: 6k8; R_0805_HandSoldering
U1: LM2576S-5; TO-263-5Lead
U2: 74HC11; so-14
U3: FT232RL; SSOP-28_5.3x10.2mm_Pitch0.65mm
U4: 74LS11; so-14
U5, U6, U7: TMC2660; TQFP-44_10x10mm_Pitch0.8mm
U8, U9, U10, U11: 74HC245; tssop-20
X1: 16MHz; XO91
Y1: 16MHz; hc-49_smd

Connections:
+5V: C3.1, C4.1, C5.1, C6.1, C10.1, C11.1, C13.1, C14.1, C16.1, C26.1, C36.1, C46.1, C47.1, C50.1, C51.1, C52.1, C53.1, D3.1, D4.1, D5.1, D6.1, D7.2, D8.2, D13.1, D14.1, D20.1, D32.1, F2.2, IC1.21, IC1.52, IC1.64, J2.1, J3.5, JP1.3, JP2.3, JP3.3, P7.4, Q6.2, Q7.2, R1.1, R13.1, R14.1, R15.1, R20.1, R25.2, R42.1, R43.1, R44.1, R45.1, R46.1, R47.1, R48.1, R50.1, R51.1, R56.1, R57.1, R58.1, R59.1, R62.1, R64.1, R66.1, R70.1, R71.1, R77.1, R83.1, R84.1, R86.1, RL1.A1, RL2.A1, TH1.1, U2.9, U2.14, U3.4, U3.20, U4.14, U5.40, U6.40, U7.40, U8.20, U9.1, U9.20, U10.20, U11.20, X1.1, X1.4
/Controller/CS_Ext1: IC1.15, J2.6
/Controller/CS_Ext2: IC1.16, J2.5
/Controller/CS_X: IC1.32, U5.18
/Controller/CS_Y: IC1.31, U6.18
/Controller/CS_Z: IC1.30, U7.18
/Controller/CTS: IC1.5, U3.11
/Controller/Cool_Flood: IC1.33, U10.16
/Controller/Cool_Mist: IC1.34, U10.15
/Controller/Cover: IC1.9, JP1.1, JP2.1, JP3.1, R33.2, U10.2
/Controller/CycleStart: IC1.8, U8.9
/Controller/Dir_X: IC1.47, U5.41
/Controller/Dir_Y: IC1.49, U6.41
/Controller/Dir_Z: IC1.51, U7.41
/Controller/Emergency_Off: IC1.28, R34.2, U2.1, U2.4, U2.11, U10.3
/Controller/Enable: IC1.29, R5.1, U2.3
/Controller/Ext1: D24.1, IC1.58, R55.1
/Controller/Ext2: D25.1, IC1.59, R60.1
/Controller/FeedHold: IC1.7, U8.8
/Controller/JogA: IC1.35, U8.2
/Controller/JogB: IC1.36, U8.3
/Controller/JogC: IC1.37, U8.4
/Controller/JogX: IC1.38, U8.5
/Controller/JogY: IC1.39, U8.6
/Controller/JogZ: IC1.40, U8.7
/Controller/LED1: IC1.18, R3.2
/Controller/LED2: IC1.19, R4.2
/Controller/RTS: IC1.4, U3.3
/Controller/RXD: IC1.2, U3.5
/Controller/Ref_X1: U4.13, U11.2
/Controller/Ref_X2: U4.2, U11.3
/Controller/Ref_Y1: U4.5, U11.4
/Controller/Ref_Y2: U4.4, U11.5
/Controller/Ref_Z1: U4.11, U11.6
/Controller/Ref_Z2: U4.10, U11.7
/Controller/Rel_1: IC1.45, R6.2
/Controller/Rel_2: IC1.44, R7.2
/Controller/Reset: D32.2, IC1.20, P7.6, R70.2
/Controller/SCK: IC1.11, J2.4, U5.16, U6.16, U7.16, U9.2
/Controller/SDI: IC1.12, J2.3, U5.15, U6.15, U7.15, U9.3
/Controller/SDO: IC1.13, J2.2, U5.14, U6.14, U7.14, U9.14
/Controller/Spindle_Dir: IC1.42, U10.14
/Controller/Spindle_PWM: IC1.17, U10.13
/Controller/Stall_X: D9.1, Q3.3, U4.1
/Controller/Stall_Y: D10.1, Q4.3, U4.3
/Controller/Stall_Z: D11.1, Q5.3, U4.9
/Controller/Step_X: IC1.46, U5.42
/Controller/Step_Y: IC1.48, U6.42
/Controller/Step_Z: IC1.50, U7.42
/Controller/TXD: IC1.3, U3.1
/Controller/T_REG: C48.1, IC1.61, R67.1, TH1.2
/Controller/V_SUP: C49.1, IC1.60, R68.2, R69.1
/Driver/Driver_X/BRA_X: R18.1, R19.2, U5.9
/Driver/Driver_X/BRB_X: R16.1, R17.2, U5.25
/Driver/Driver_X/OA1_X: P8.4, U5.2, U5.3, U5.7, U5.8
/Driver/Driver_X/OA2_X: P8.3, U5.5, U5.6, U5.10, U5.11
/Driver/Driver_X/OB1_X: P8.1, U5.26, U5.27, U5.31, U5.32
/Driver/Driver_X/OB2_X: P8.2, U5.23, U5.24, U5.28, U5.29
/Driver/Driver_X/SRA_X: C25.2, R18.2, U5.12
/Driver/Driver_X/SRB_X: C22.2, R16.2, U5.22
/Driver/Driver_Y/BRA_Y: R23.1, R24.2, U6.9
/Driver/Driver_Y/BRB_Y: R21.1, R22.2, U6.25
/Driver/Driver_Y/OA1_Y: P9.4, U6.2, U6.3, U6.7, U6.8
/Driver/Driver_Y/OA2_Y: P9.3, U6.5, U6.6, U6.10, U6.11
/Driver/Driver_Y/OB1_Y: P9.1, U6.26, U6.27, U6.31, U6.32
/Driver/Driver_Y/OB2_Y: P9.2, U6.23, U6.24, U6.28, U6.29
/Driver/Driver_Y/SRA_Y: C35.2, R23.2, U6.12
/Driver/Driver_Y/SRB_Y: C32.2, R21.2, U6.22
/Driver/Driver_Z/BRA_Z: R28.1, R29.2, U7.9
/Driver/Driver_Z/BRB_Z: R26.1, R27.2, U7.25
/Driver/Driver_Z/OA1_Z: P10.4, U7.2, U7.3, U7.7, U7.8
/Driver/Driver_Z/OA2_Z: P10.3, U7.5, U7.6, U7.10, U7.11
/Driver/Driver_Z/OB1_Z: P10.1, U7.26, U7.27, U7.31, U7.32
/Driver/Driver_Z/OB2_Z: P10.2, U7.23, U7.24, U7.28, U7.29
/Driver/Driver_Z/SRA_Z: C45.2, R28.2, U7.12
/Driver/Driver_Z/SRB_Z: C42.2, R26.2, U7.22
/Driver/TMC_Clock: U5.21, U6.21, U7.21, X1.3
/Driver/TMC_Enable: U2.6, U5.19, U6.19, U7.19
/Interface/CS_Disp: IC1.14, U9.4
/Interface/D+: P3.3, U3.15
/Interface/D-: P3.2, U3.16
/Interface/LED_RX: R11.2, U3.22
/Interface/LED_TX: R10.2, U3.23
/Interface/Ref_T1: IC1.41, U11.8
/Interface/Reset_UART: R8.2, R9.1, U3.19
/Interface/Spindle_Enable: IC1.43, R49.2, R65.2, U2.2
/Interface/VCC_USB: P3.1, R8.1
GND: C1.2, C2.2, C3.2, C4.2, C5.2, C6.2, C7.2, C8.2, C9.2, C10.2, C11.2, C12.2, C13.2, C14.2, C15.2, C16.2, C18.2, C19.2, C20.2, C21.2, C22.1, C23.2, C24.2, C25.1, C26.2, C28.2, C29.2, C30.2, C31.2, C32.1, C33.2, C34.2, C35.1, C36.2, C38.2, C39.2, C40.2, C41.2, C42.1, C43.2, C44.2, C45.1, C46.2, C47.2, C48.2, C49.2, C50.2, C51.2, C52.2, C53.2, D1.2, D2.1, D3.2, D4.2, D12.2, D13.2, D14.2, D20.2, D24.2, D25.2, D26.1, D27.1, D33.2, IC1.22, IC1.53, IC1.63, J1.1, J2.7, J2.8, J3.1, J4.8, J6.4, P1.1, P3.4, P7.2, P7.10, P12.4, P13.5, Q3.2, Q4.2, Q5.2, Q8.2, Q9.2, R5.2, R9.2, R17.1, R19.1, R22.1, R24.1, R27.1, R29.1, R49.1, R67.2, R69.2, SW1.2, U1.3, U1.5, U2.7, U3.7, U3.18, U3.21, U3.25, U4.7, U5.17, U5.39, U5.43, U5.44, U6.17, U6.39, U6.43, U6.44, U7.17, U7.39, U7.43, U7.44, U8.1, U8.10, U8.19, U9.5, U9.7, U9.8, U9.9, U9.10, U9.19, U10.1, U10.10, U10.11, U10.12, U10.19, U11.1, U11.10, U11.11, U11.19, X1.2
unnamed: C7.1, IC1.62
unnamed: C8.1, IC1.23, Y1.2
unnamed: C9.1, IC1.24, Y1.1
unnamed: C12.1, U3.17
unnamed: C2.1, C15.1, F2.1, L1.2, U1.4
unnamed: C17.2, U5.35
unnamed: C19.1, U5.13
unnamed: C27.2, U6.35
unnamed: C29.1, U6.13
unnamed: C37.2, U7.35
unnamed: C39.1, U7.13
unnamed: D1.1, L1.1, U1.2
unnamed: D2.2, R1.2
unnamed: D7.1, R10.1
unnamed: D8.1, R11.1
unnamed: D9.2, R15.2
unnamed: D10.2, R20.2
unnamed: D11.2, R25.1
unnamed: D26.2, R61.1
unnamed: D27.2, R63.2
unnamed: D28.1, Q8.3
unnamed: D28.2, R62.2
unnamed: D5.2, D30.1, Q1.3, RL1.A2
unnamed: D30.2, R64.2
unnamed: D6.2, D31.1, Q2.3, RL2.A2
unnamed: D31.2, R66.2
unnamed: D33.1, R3.1
unnamed: D33.3, R4.1
unnamed: F1.1, P1.2
unnamed: IC1.6, SW1.1
unnamed: IC1.25, U4.8
unnamed: IC1.26, U4.6
unnamed: IC1.27, U4.12
unnamed: IC1.54, P7.9
unnamed: IC1.55, P7.3
unnamed: IC1.56, P7.5
unnamed: IC1.57, P7.1
unnamed: J1.2, R82.2, R84.2
unnamed: J1.3, R71.2, R76.2
unnamed: J1.4, R56.2, R74.2
unnamed: J1.5, R13.2, R72.2
unnamed: J1.6, R85.2, R86.2
unnamed: J1.7, R81.2, R83.2
unnamed: J1.8, R57.2, R75.2
unnamed: J1.9, R51.2, R73.2
unnamed: J3.3, U9.17
unnamed: J3.7, U9.16
unnamed: J3.8, U9.18
unnamed: J3.9, U9.6
unnamed: J4.1, R2.2, R42.2
unnamed: J4.2, R36.2, R43.2
unnamed: J4.3, R37.2, R44.2
unnamed: J4.4, R38.2, R45.2
unnamed: J4.5, R39.2, R46.2
unnamed: J4.6, R40.2, R47.2
unnamed: J4.7, R41.2, R48.2
unnamed: J6.1, R50.2
unnamed: J6.2, R55.2
unnamed: J6.3, R60.2
unnamed: JP1.2, U2.13
unnamed: JP2.2, U2.5
unnamed: JP3.2, U2.10
unnamed: P2.1, R58.2
unnamed: P2.2, R52.2
unnamed: P4.1, RL2.14
unnamed: P4.2, RL2.11
unnamed: P5.1, RL1.14
unnamed: P5.2, RL1.11
unnamed: P6.1, R14.2
unnamed: P6.2, R12.2
unnamed: P12.1, R77.2
unnamed: P12.2, R79.2
unnamed: P12.3, R78.2
unnamed: P13.1, R59.2
unnamed: P13.2, R80.2
unnamed: P13.3, R53.2
unnamed: P13.4, R54.2
unnamed: Q1.1, R6.1
unnamed: Q1.2, Q2.2, Q9.3
unnamed: Q2.1, R7.1
unnamed: Q3.1, R30.2
unnamed: Q4.1, R31.2
unnamed: Q5.1, R32.1
unnamed: Q6.1, R33.1
unnamed: Q6.3, R61.2
unnamed: Q7.1, R34.1
unnamed: Q7.3, R63.1
unnamed: Q8.1, R65.1
unnamed: Q9.1, R35.1
unnamed: R2.1, U11.18
unnamed: R12.1, U10.17
unnamed: R30.1, U5.38
unnamed: R31.1, U6.38
unnamed: R32.2, U7.38
unnamed: R35.2, U2.8
unnamed: R36.1, U11.17
unnamed: R37.1, U11.16
unnamed: R38.1, U11.15
unnamed: R39.1, U11.14
unnamed: R40.1, U11.13
unnamed: R41.1, U11.12
unnamed: R52.1, U10.18
unnamed: R53.1, U10.7
unnamed: R54.1, U2.12
unnamed: R72.1, U8.18
unnamed: R73.1, U8.17
unnamed: R74.1, U8.16
unnamed: R75.1, U8.15
unnamed: R76.1, U8.14
unnamed: R78.1, U10.4
unnamed: R79.1, U10.5
unnamed: R80.1, U10.6
unnamed: R81.1, U8.13
unnamed: R82.1, U8.12
unnamed: R85.1, U8.11
VSA: C1.1, C17.1, C18.1, C20.1, C21.1, C23.1, C24.1, C27.1, C28.1, C30.1, C31.1, C33.1, C34.1, C37.1, C38.1, C40.1, C41.1, C43.1, C44.1, D12.1, F1.2, R68.1, U1.1, U5.1, U5.4, U5.30, U5.33, U5.36, U6.1, U6.4, U6.30, U6.33, U6.36, U7.1, U7.4, U7.30, U7.33, U7.36
