FordPrfkt/StepperController/Boards/StepperDisplay/StepperDisplay.kicad_pcb

## KiCad design Boards/StepperDisplay/StepperDisplay.kicad_pcb (2016-10-01)

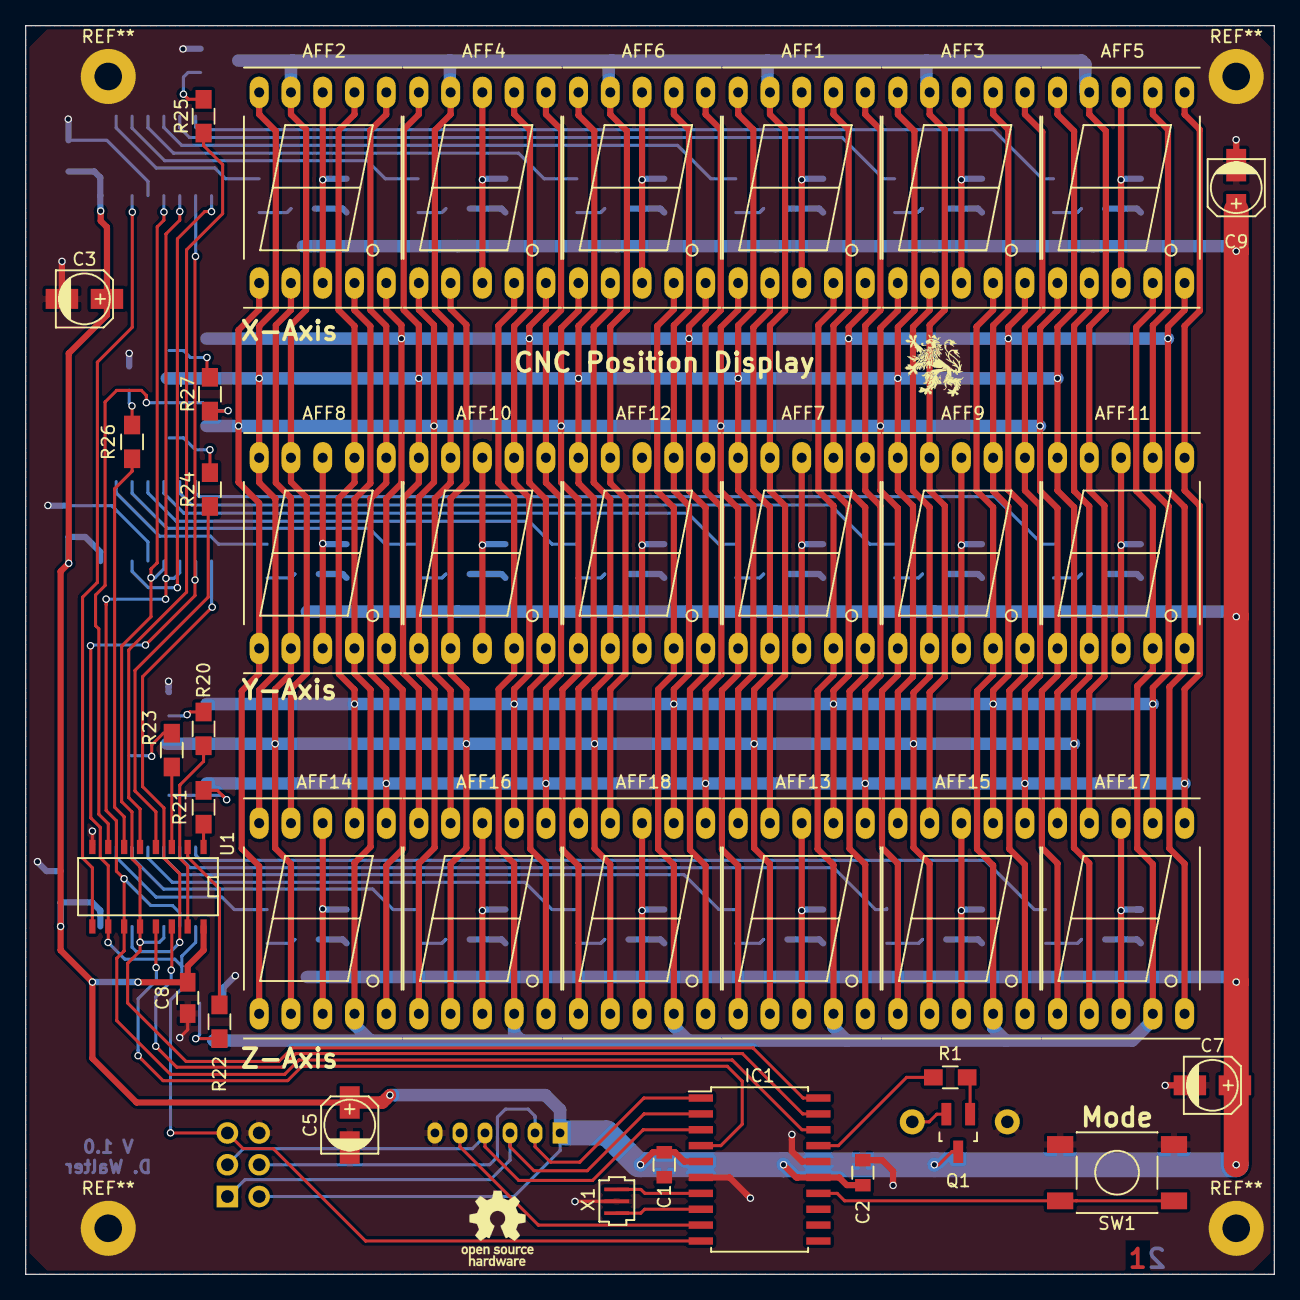
[picture p39: board StepperDisplay.kicad_pcb from above]

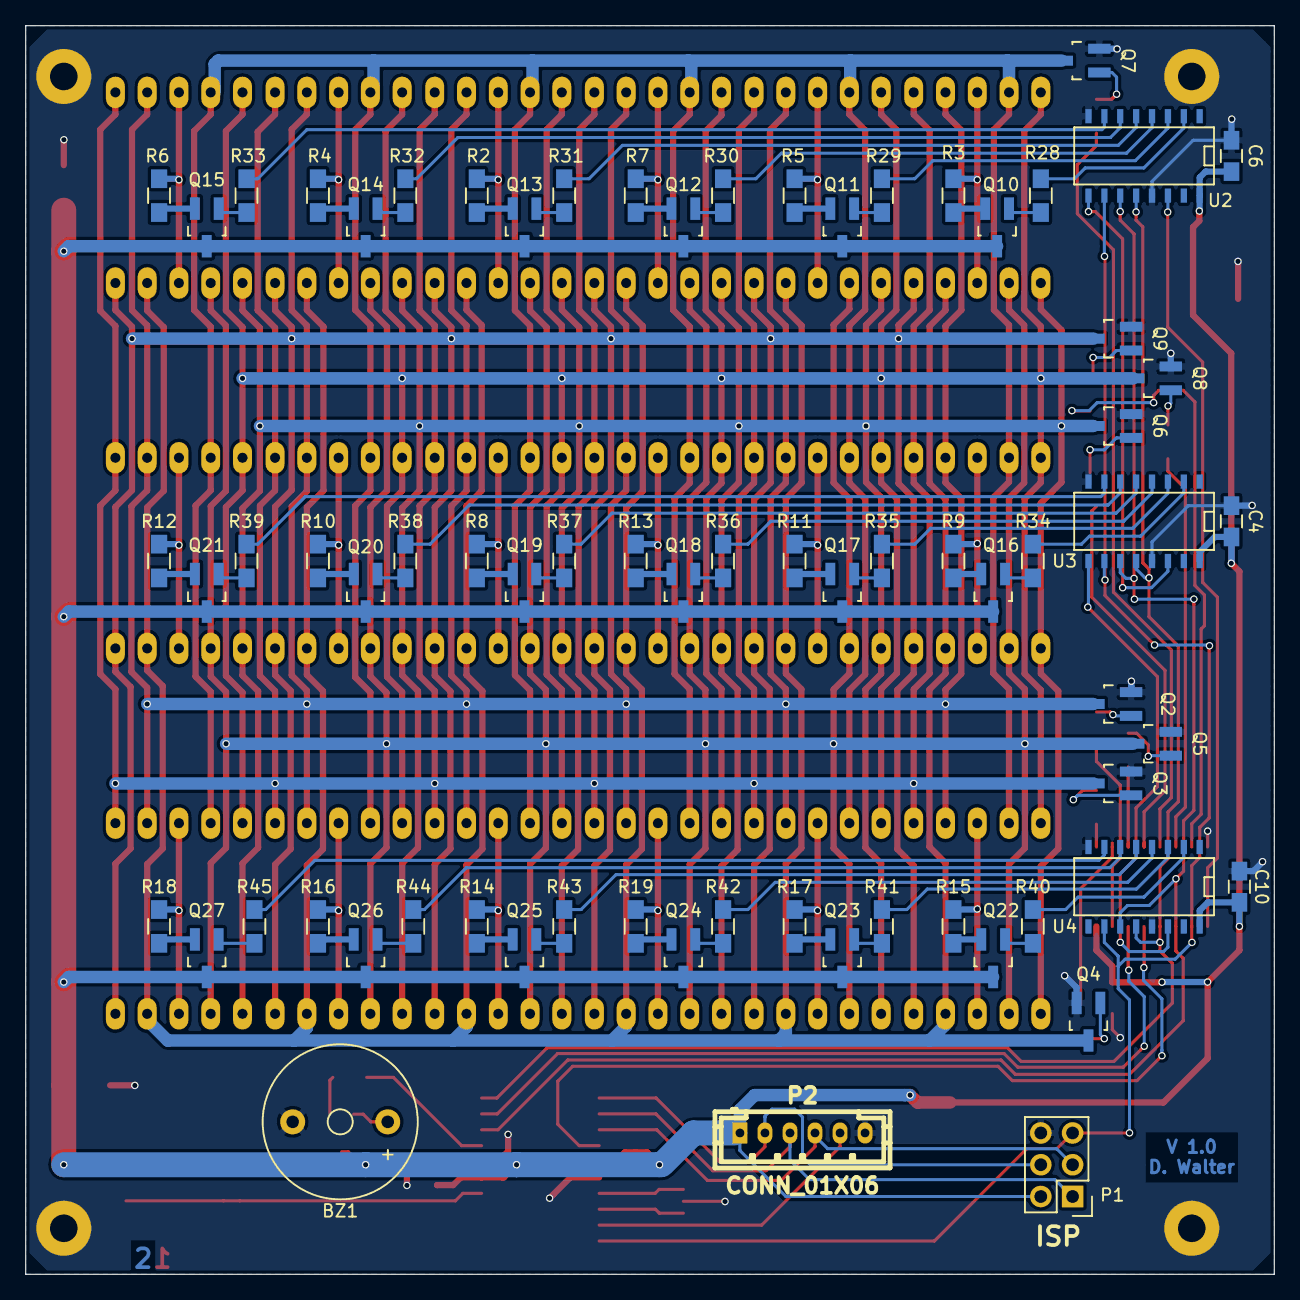
[picture p40: board StepperDisplay.kicad_pcb from below]

Board: 2 copper layers, 99.8 x 99.8 mm, 110 parts (71 on the bottom side), 116 nets.

Parts:
AFF1, AFF2, AFF3, AFF4, AFF5, AFF6, AFF7, AFF8, AFF9, AFF10, AFF11, AFF12, AFF13, AFF14, AFF15, AFF16, AFF17, AFF18: 7SEGMENTS; 7SegmentLED_LTS6760_LTS6780
BZ1: buzzer; Buzzer_12x9.5RM7.6
C1, C2: 100nF; C_0805
C3, C5, C7, C9: 100µF; c_elec_4x5.8
C4, C6, C8, C10: 100nF; C_0805_HandSoldering
IC1: ATTINY861-P; SOIC-20_7.5x12.8mm_Pitch1.27mm
P1: ISP; Pin_Header_Straight_2x03
P2: CONN_01X06; b6b-ph-kl
Q1, Q10, Q11, Q12, Q13, Q14, Q15, Q16, Q17, Q18, Q19, Q20, Q21, Q22, Q23, Q24, Q25, Q26, Q27: BC817-40; SOT-23_Handsoldering
Q2, Q3, Q4, Q5, Q6, Q7, Q8, Q9: IRLML2502; SOT-23_Handsoldering
R1, R28, R29, R30, R31, R32, R33, R34, R35, R36, R37, R38, R39, R40, R41, R42, R43, R44, R45: 1k; R_0805_HandSoldering
R2, R3, R4, R5, R6, R7, R8, R9, R10, R11, R12, R13, R14, R15, R16, R17, R18, R19: 18R; R_0805_HandSoldering
R20, R21, R22, R23, R24, R25, R26, R27: 100R; R_0805_HandSoldering
SW1: SW_PUSH; SW_LSx_1301
U1, U2, U3, U4: 74HC595; SO-16-N
X1: 12MHz; Resonator_CSTCE

Connections:
+5V: C1.1, C2.1, C3.1, C4.1, C5.1, C6.1, C7.1, C8.1, C9.1, C10.1, IC1.5, IC1.15, P1.2, P2.1, Q1.3, Q10.3, Q11.3, Q12.3, Q13.3, Q14.3, Q15.3, Q16.3, Q17.3, Q18.3, Q19.3, Q20.3, Q21.3, Q22.3, Q23.3, Q24.3, Q25.3, Q26.3, Q27.3, U1.16, U2.16, U3.16, U4.16
/Controller/Enable: IC1.4, U1.13
/Controller/R_Clock: IC1.20, U1.12, U2.12, U3.12, U4.12
/Controller/Reset: IC1.10, P1.5, U1.10, U2.10, U3.10, U4.10
/Controller/Ser_Clock: IC1.18, U1.11, U2.11, U3.11, U4.11
/LEDS/LEDsX/Ser_In: U1.9, U2.14
/LEDS/LEDsY/Ser_In: U2.9, U3.14
/LEDS/LEDsZ/Ser_In: U3.9, U4.14
/LEDS/Q1: R20.2, U1.15
/LEDS/Q2: R21.2, U1.1
/LEDS/Q3: R22.2, U1.2
/LEDS/Q4: R23.2, U1.3
/LEDS/Q5: R24.2, U1.4
/LEDS/Q6: R25.2, U1.5
/LEDS/Q7: R26.2, U1.6
/LEDS/Q8: R27.2, U1.7
/LEDS/Ser_In: IC1.19, U1.14
GND: BZ1.2, C1.2, C2.2, C3.2, C4.2, C5.2, C6.2, C7.2, C8.2, C9.2, C10.2, IC1.6, IC1.16, P1.6, P2.6, Q2.2, Q3.2, Q4.2, Q5.2, Q6.2, Q7.2, Q8.2, Q9.2, SW1.2, U1.8, U2.8, U2.13, U3.8, U3.13, U4.8, U4.13, X1.2
unnamed: AFF1.3, AFF1.8, R2.2
unnamed: AFF2.3, AFF2.8, R3.2
unnamed: AFF3.3, AFF3.8, R4.2
unnamed: AFF4.3, AFF4.8, R5.2
unnamed: AFF5.3, AFF5.8, R6.2
unnamed: AFF6.3, AFF6.8, R7.2
unnamed: AFF7.3, AFF7.8, R8.2
unnamed: AFF8.3, AFF8.8, R9.2
unnamed: AFF9.3, AFF9.8, R10.2
unnamed: AFF10.3, AFF10.8, R11.2
unnamed: AFF11.3, AFF11.8, R12.2
unnamed: AFF12.3, AFF12.8, R13.2
unnamed: AFF13.3, AFF13.8, R14.2
unnamed: AFF14.3, AFF14.8, R15.2
unnamed: AFF15.3, AFF15.8, R16.2
unnamed: AFF16.3, AFF16.8, R17.2
unnamed: AFF17.3, AFF17.8, R18.2
unnamed: AFF18.3, AFF18.8, R19.2
unnamed: BZ1.1, Q1.2
unnamed: IC1.1, P1.4, P2.2
unnamed: IC1.2, P1.1, P2.3
unnamed: IC1.3, P1.3, P2.4
unnamed: IC1.7, X1.3
unnamed: IC1.8, X1.1
unnamed: IC1.9, P2.5
unnamed: IC1.14, SW1.1
unnamed: IC1.17, R1.2
unnamed: Q1.1, R1.1
unnamed: Q2.1, R20.1
unnamed: Q3.1, R21.1
unnamed: Q4.1, R22.1
unnamed: Q5.1, R23.1
unnamed: Q6.1, R24.1
unnamed: Q7.1, R25.1
unnamed: Q8.1, R26.1
unnamed: Q9.1, R27.1
unnamed: Q10.1, R28.1
unnamed: Q10.2, R3.1
unnamed: Q11.1, R29.1
unnamed: Q11.2, R5.1
unnamed: Q12.1, R30.1
unnamed: Q12.2, R7.1
unnamed: Q13.1, R31.1
unnamed: Q13.2, R2.1
unnamed: Q14.1, R32.1
unnamed: Q14.2, R4.1
unnamed: Q15.1, R33.1
unnamed: Q15.2, R6.1
unnamed: Q16.1, R34.1
unnamed: Q16.2, R9.1
unnamed: Q17.1, R35.1
unnamed: Q17.2, R11.1
unnamed: Q18.1, R36.1
unnamed: Q18.2, R13.1
unnamed: Q19.1, R37.1
unnamed: Q19.2, R8.1
unnamed: Q20.1, R38.1
unnamed: Q20.2, R10.1
unnamed: Q21.1, R39.1
unnamed: Q21.2, R12.1
unnamed: Q22.1, R40.1
unnamed: Q22.2, R15.1
unnamed: Q23.1, R41.1
unnamed: Q23.2, R17.1
unnamed: Q24.1, R42.1
unnamed: Q24.2, R19.1
unnamed: Q25.1, R43.1
unnamed: Q25.2, R14.1
unnamed: Q26.1, R44.1
unnamed: Q26.2, R16.1
unnamed: Q27.1, R45.1
unnamed: Q27.2, R18.1
unnamed: R28.2, U2.2
unnamed: R29.2, U2.3
unnamed: R30.2, U2.4
unnamed: R31.2, U2.5
unnamed: R32.2, U2.6
unnamed: R33.2, U2.7
unnamed: R34.2, U3.2
unnamed: R35.2, U3.3
unnamed: R36.2, U3.4
unnamed: R37.2, U3.5
unnamed: R38.2, U3.6
unnamed: R39.2, U3.7
unnamed: R40.2, U4.2
unnamed: R41.2, U4.3
unnamed: R42.2, U4.4
unnamed: R43.2, U4.5
unnamed: R44.2, U4.6
unnamed: R45.2, U4.7
Seg1: AFF1.7, AFF2.7, AFF3.7, AFF4.7, AFF5.7, AFF6.7, AFF7.7, AFF8.7, AFF9.7, AFF10.7, AFF11.7, AFF12.7, AFF13.7, AFF14.7, AFF15.7, AFF16.7, AFF17.7, AFF18.7, Q2.3
Seg2: AFF1.6, AFF2.6, AFF3.6, AFF4.6, AFF5.6, AFF6.6, AFF7.6, AFF8.6, AFF9.6, AFF10.6, AFF11.6, AFF12.6, AFF13.6, AFF14.6, AFF15.6, AFF16.6, AFF17.6, AFF18.6, Q3.3
Seg3: AFF1.4, AFF2.4, AFF3.4, AFF4.4, AFF5.4, AFF6.4, AFF7.4, AFF8.4, AFF9.4, AFF10.4, AFF11.4, AFF12.4, AFF13.4, AFF14.4, AFF15.4, AFF16.4, AFF17.4, AFF18.4, Q4.3
Seg4: AFF1.2, AFF2.2, AFF3.2, AFF4.2, AFF5.2, AFF6.2, AFF7.2, AFF8.2, AFF9.2, AFF10.2, AFF11.2, AFF12.2, AFF13.2, AFF14.2, AFF15.2, AFF16.2, AFF17.2, AFF18.2, Q5.3
Seg5: AFF1.1, AFF2.1, AFF3.1, AFF4.1, AFF5.1, AFF6.1, AFF7.1, AFF8.1, AFF9.1, AFF10.1, AFF11.1, AFF12.1, AFF13.1, AFF14.1, AFF15.1, AFF16.1, AFF17.1, AFF18.1, Q6.3
Seg6: AFF1.9, AFF2.9, AFF3.9, AFF4.9, AFF5.9, AFF6.9, AFF7.9, AFF8.9, AFF9.9, AFF10.9, AFF11.9, AFF12.9, AFF13.9, AFF14.9, AFF15.9, AFF16.9, AFF17.9, AFF18.9, Q7.3
Seg7: AFF1.10, AFF2.10, AFF3.10, AFF4.10, AFF5.10, AFF6.10, AFF7.10, AFF8.10, AFF9.10, AFF10.10, AFF11.10, AFF12.10, AFF13.10, AFF14.10, AFF15.10, AFF16.10, AFF17.10, AFF18.10, Q8.3
Seg8: AFF1.5, AFF2.5, AFF3.5, AFF4.5, AFF5.5, AFF6.5, AFF7.5, AFF8.5, AFF9.5, AFF10.5, AFF11.5, AFF12.5, AFF13.5, AFF14.5, AFF15.5, AFF16.5, AFF17.5, AFF18.5, Q9.3
