FordPrfkt/StepperController/boards/HandController/rescue-backup/HandController-2021-05-21-20-15-34.sch

## KiCad design boards/HandController/rescue-backup/HandController-2021-05-21-20-15-34.sch (2019-04-07)

Schematic: HandController-2021-05-21-20-15-34.sch

Parts:
J1: Conn_01x09; JST_EH_B09B-EH-A_09x2.50mm_Straight
SW1: SW_Push; SW_SPST_B3SL-1002P
SW2, SW3, SW4, SW5: SW_Push; SW_Tactile_Straight_KSA0Axx1LFTR
SW6: Rotary_Encoder; SW_SPST_Panasonic_EVQPL_3PL_5PL_PT_A08
