FordPrfkt/StepperController/boards/HighPowerDriver/HPDriver/Connector.kicad_sch

## KiCad design boards/HighPowerDriver/HPDriver/Connector.kicad_sch (2022-08-06)

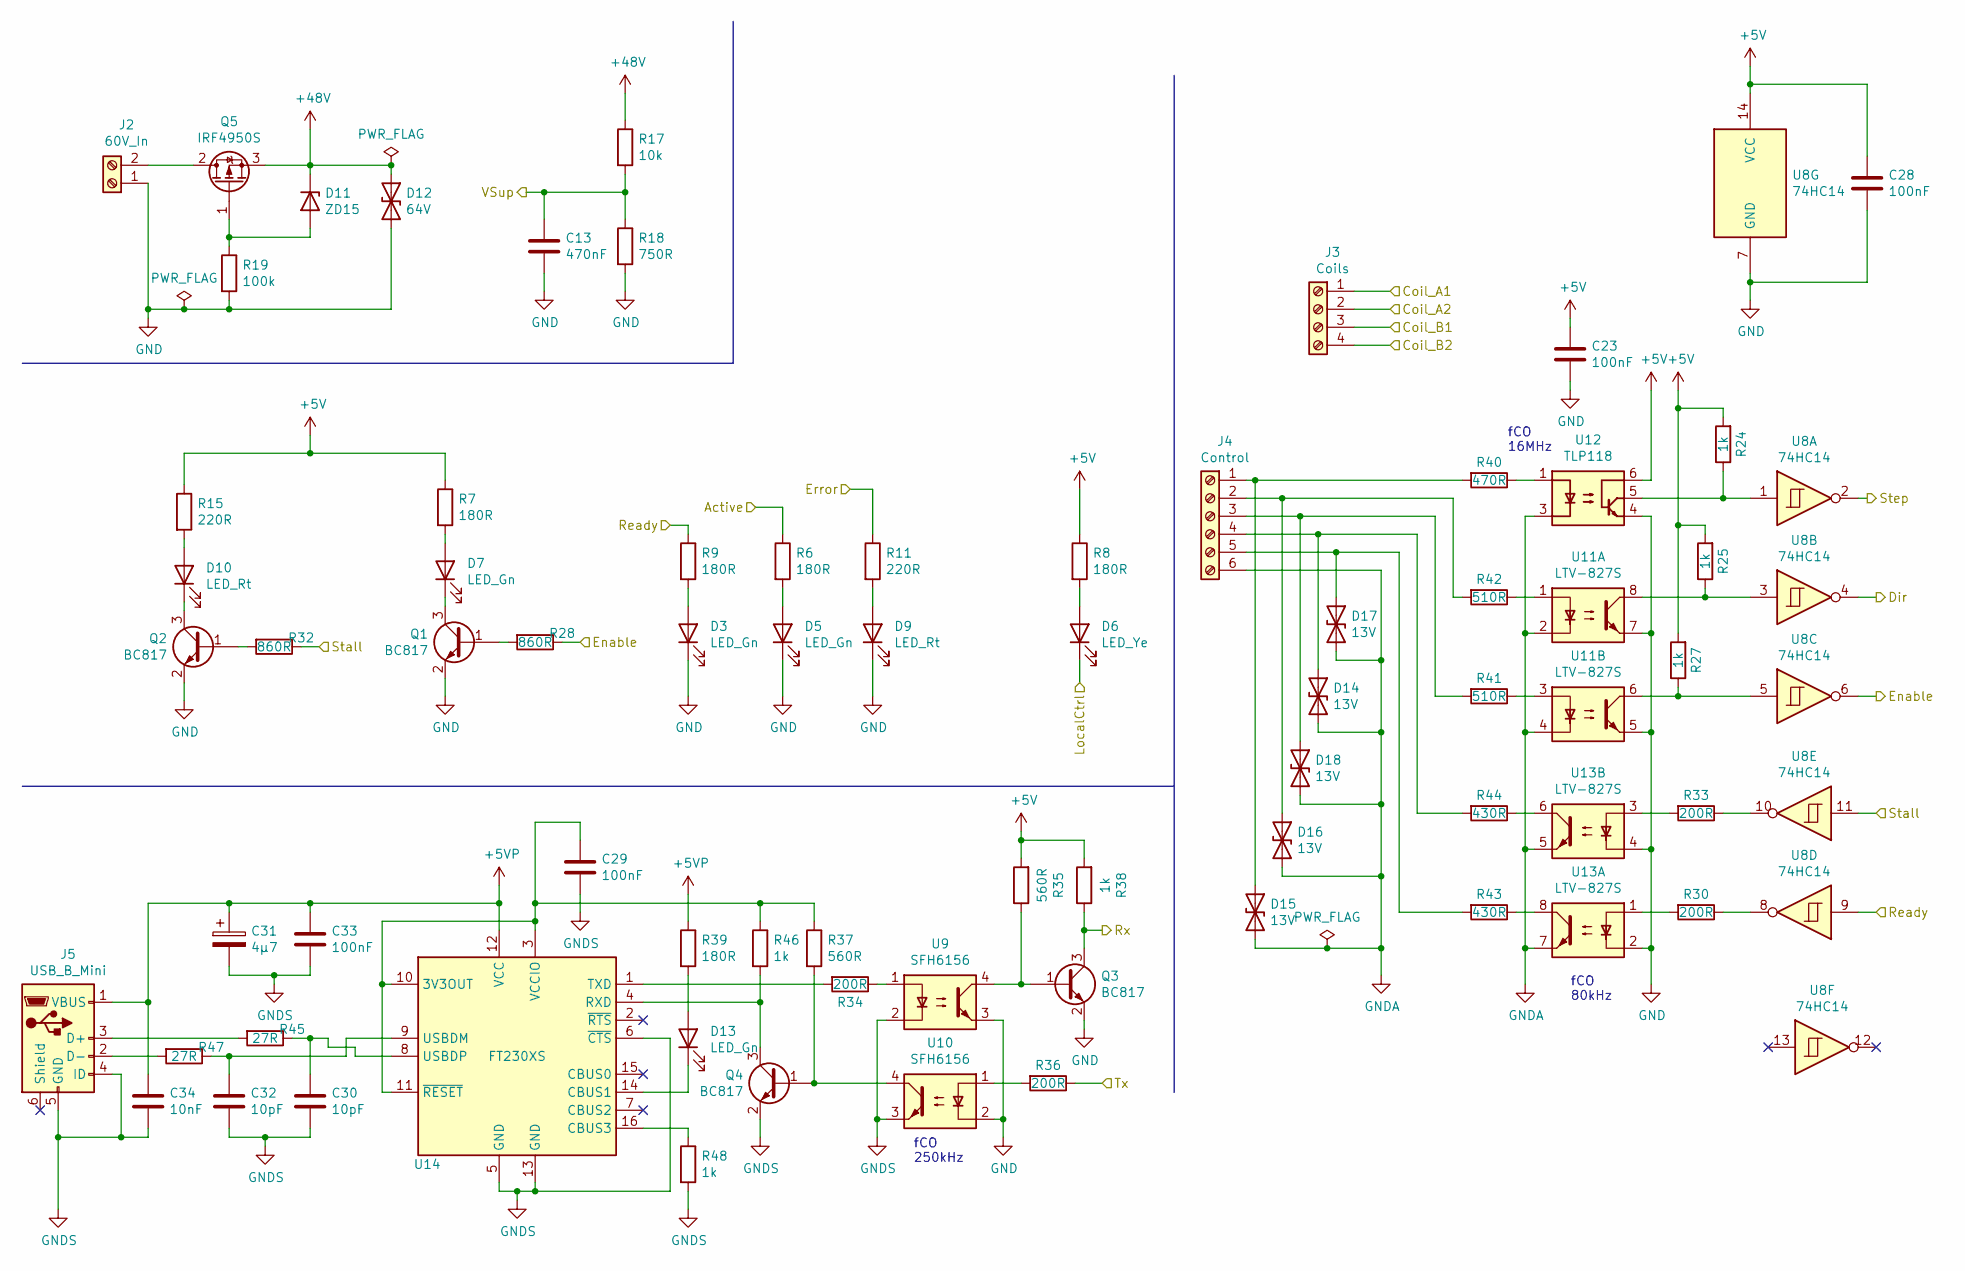
[picture p41: schematic Connector.kicad_sch]

Parts:
C13: 470nF; C_0805_2012Metric
C23, C28, C29, C33: 100nF; C_0805_2012Metric
C30, C32: 10pF; C_0805_2012Metric
C31: 4µ7; C_0805_2012Metric_Pad1.15x1.40mm_HandSolder
C34: 10nF; C_0805_2012Metric
D3, D5, D7, D13: LED_Gn; LED_0805_2012Metric
D6: LED_Ye; LED_0805_2012Metric
D9, D10: LED_Rt; LED_0805_2012Metric
D11: ZD15; D_SOT-23_ANK
D12: 64V; D_SMB
D14, D15, D16, D17, D18: 13V; D_SMA
J2: 60V_In; PhoenixContact_MSTBA_2,5_2-G_1x02_P5.00mm_Horizontal
J3: Coils; PhoenixContact_MSTBA_2,5_4-G_1x04_P5.00mm_Horizontal
J4: Control; PhoenixContact_MSTBA_2,5_6-G_1x06_P5.00mm_Horizontal
J5: USB_B_Mini; USB_Mini-B_Lumberg_2486_01_Horizontal
Q1, Q2, Q3, Q4: BC817; SOT-23
Q5: IRF4950S; TO-263-2
R6, R7, R8, R9, R39: 180R; R_0805_2012Metric
R11, R15: 220R; R_0805_2012Metric
R17: 10k; R_0805_2012Metric
R18: 750R; R_0805_2012Metric
R19: 100k; R_0805_2012Metric
R24, R25, R27, R38, R46, R48: 1k; R_0805_2012Metric
R28, R32: 860R; R_0805_2012Metric
R30, R33, R34, R36: 200R; R_0805_2012Metric
R35, R37: 560R; R_0805_2012Metric
R40: 470R; R_0805_2012Metric
R41, R42: 510R; R_0805_2012Metric
R43, R44: 430R; R_0805_2012Metric
R45, R47: 27R; R_0805_2012Metric
U8: 74HC14; SOIC-14_3.9x8.7mm_P1.27mm
U9, U10: SFH6156; SMDIP-4_W7.62mm
U11, U13: LTV-827S; SMDIP-8_W9.53mm
U12: TLP118; MFSOP6-5_4.4x3.6mm_P1.27mm
U14: FT230XS; SSOP-16_3.9x4.9mm_P0.635mm

Connections:
+5V: C23.1, C28.1, R7.1, R8.1, R15.1, R24.2, R25.2, R27.2, R35.2, R38.2, U8.14 (VCC), U12.6
+5VP: C31.1, C33.1, C34.1, J5.1 (VBUS), R39.1, U14.12 (VCC)
+48V: D11.1 (K), D12.1 (A1), Q5.3 (S), R17.1
Active: R6.1
Coil_A1: J3.1
Coil_A2: J3.2
Coil_B1: J3.3
Coil_B2: J3.4
Dir: U8.4
Enable: R28.1, U8.6
Error: R11.1
GND: C13.2, C23.2, C28.2, D3.1 (K), D5.1 (K), D9.1 (K), D12.2 (A2), J2.1, Q1.2 (E), Q2.2 (E), Q3.2 (E), R18.2, R19.2, U8.7 (GND), U9.3, U10.2, U11.5, U11.7, U12.4, U13.2, U13.4
GNDA: D14.2 (A2), D15.2 (A2), D16.2 (A2), D17.2 (A2), D18.2 (A2), J4.6, U11.2, U11.4, U12.3, U13.5, U13.7
GNDS: C29.2, C30.2, C31.2, C32.2, C33.2, C34.2, J5.4 (ID), J5.5 (GND), Q4.2 (E), R48.2, U9.2, U10.3, U14.5 (GND), U14.6 (~CTS), U14.13 (GND)
LocalCtrl: D6.1 (K)
unnamed: C29.1, R37.1, R46.1, U14.3 (VCCIO), U14.10 (3V3OUT), U14.11 (~RESET)
unnamed: C30.1, R45.1, U14.8 (USBDP)
unnamed: C32.1, R47.1, U14.9 (USBDM)
unnamed: D3.2 (A), R9.2
unnamed: D5.2 (A), R6.2
unnamed: D6.2 (A), R8.2
unnamed: D7.1 (K), Q1.3 (C)
unnamed: D7.2 (A), R7.2
unnamed: D9.2 (A), R11.2
unnamed: D10.1 (K), Q2.3 (C)
unnamed: D10.2 (A), R15.2
unnamed: D11.2 (A), Q5.1 (G), R19.1
unnamed: D13.1 (K), U14.14 (CBUS1)
unnamed: D13.2 (A), R39.2
unnamed: D14.1 (A1), J4.4, R44.2
unnamed: D15.1 (A1), J4.1, R40.2
unnamed: D16.1 (A1), J4.2, R42.2
unnamed: D17.1 (A1), J4.5, R43.2
unnamed: D18.1 (A1), J4.3, R41.2
unnamed: J2.2, Q5.2 (D)
unnamed: J5.2 (D-), R47.2
unnamed: J5.3 (D+), R45.2
unnamed: Q1.1 (B), R28.2
unnamed: Q2.1 (B), R32.2
unnamed: Q3.1 (B), R35.1, U9.4
unnamed: Q4.1 (B), R37.2, U10.4
unnamed: Q4.3 (C), R46.2, U14.4 (RXD)
unnamed: R24.1, U8.1, U12.5
unnamed: R25.1, U8.3, U11.8
unnamed: R27.1, U8.5, U11.6
unnamed: R30.1, U8.8
unnamed: R30.2, U13.1
unnamed: R33.1, U8.10
unnamed: R33.2, U13.3
unnamed: R34.1, U9.1
unnamed: R34.2, U14.1 (TXD)
unnamed: R36.2, U10.1
unnamed: R40.1, U12.1
unnamed: R41.1, U11.3
unnamed: R42.1, U11.1
unnamed: R43.1, U13.8
unnamed: R44.1, U13.6
unnamed: R48.1, U14.16 (CBUS3)
Ready: R9.1, U8.9
Rx: Q3.3 (C), R38.1
Stall: R32.1, U8.11
Step: U8.2
Tx: R36.1
VSup: C13.1, R17.2, R18.1

Notes on the sheet:
fCO 80kHz
fCO 16MHz
fCO 250kHz
