FordPrfkt/StepperController/boards/HighPowerDriver/HPDriver/Controller.kicad_sch

## KiCad design boards/HighPowerDriver/HPDriver/Controller.kicad_sch (2022-08-06)

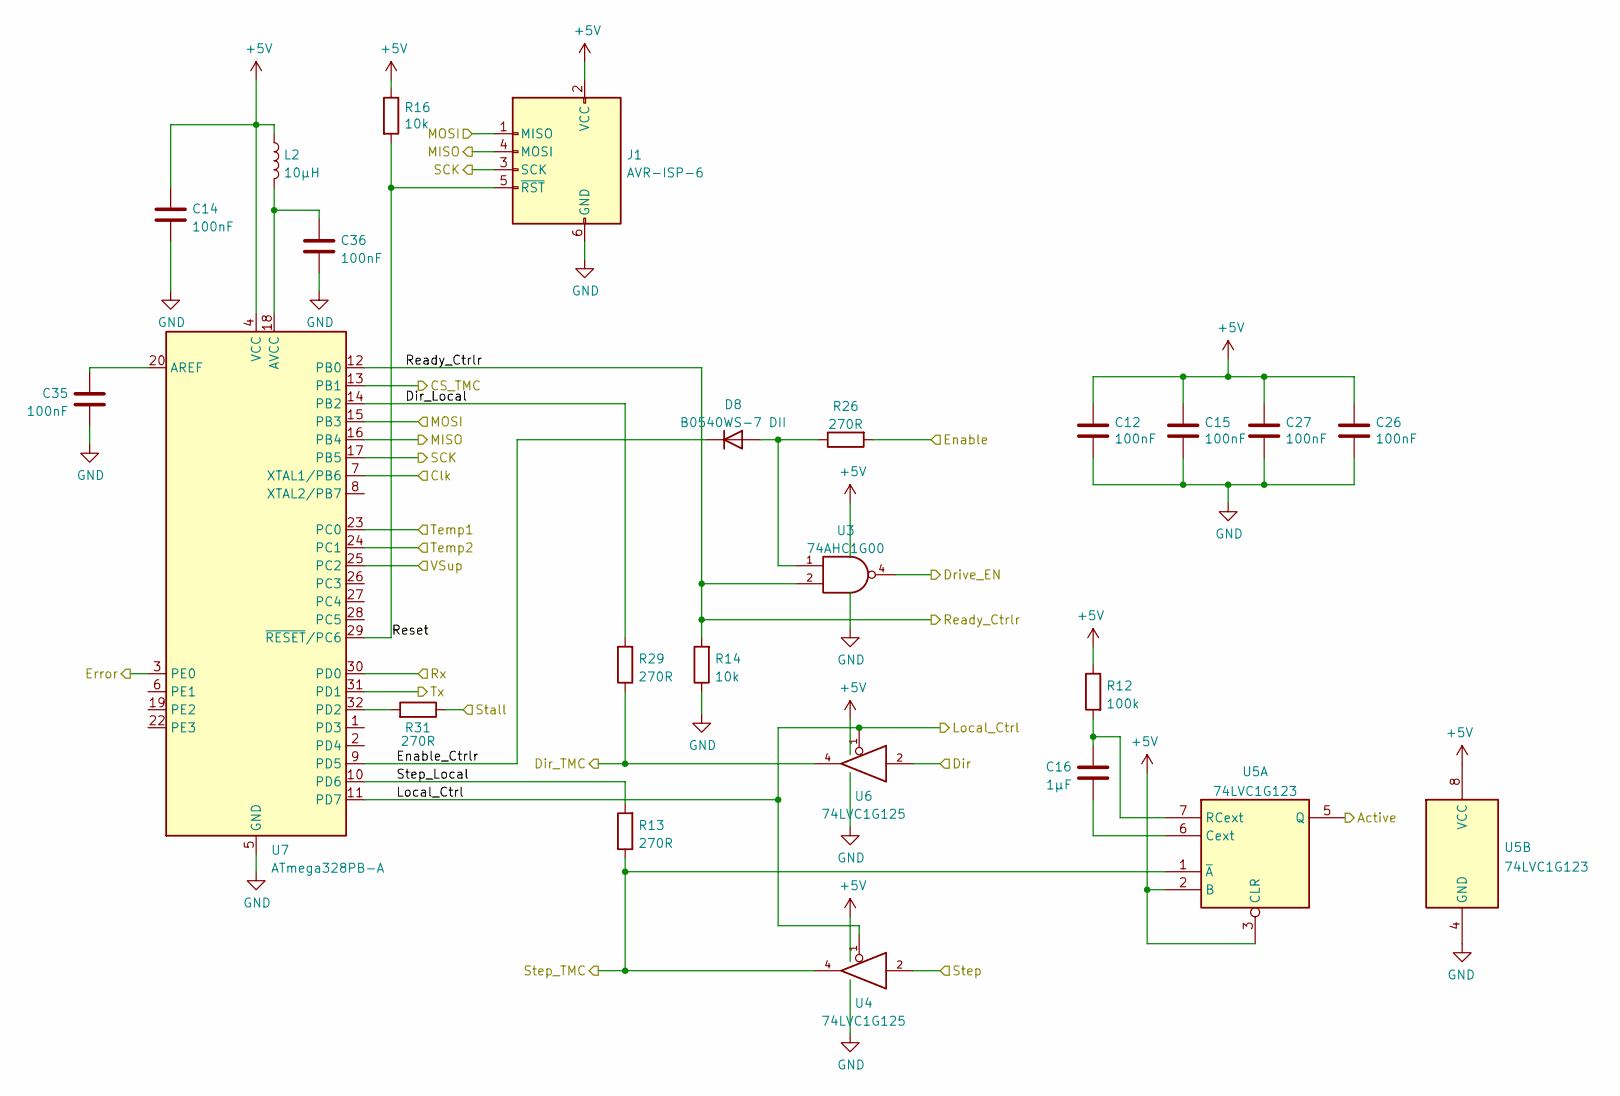
[picture p42: schematic Controller.kicad_sch]

Parts:
C12, C14, C15, C26, C27, C35, C36: 100nF; C_0805_2012Metric
C16: 1µF; C_0805_2012Metric
D8: B0540WS-7 DII; D_SOD-323
J1: AVR-ISP-6; IDC-Header_2x03_P2.54mm_Vertical
L2: 10µH; L_0805_2012Metric
R12: 100k; R_0805_2012Metric
R13, R26, R29, R31: 270R; R_0805_2012Metric
R14, R16: 10k; R_0805_2012Metric
U3: 74AHC1G00; SOT-23-5
U4, U6: 74LVC1G125; SOT-23-5
U5: 74LVC1G123; VSSOP-8_3.0x3.0mm_P0.65mm
U7: ATmega328PB-A; TQFP-32_7x7mm_P0.8mm

Connections:
+5V: C12.1, C14.1, C15.1, C26.1, C27.1, J1.2 (VCC), L2.1, R12.1, R16.1, U3.5 (VCC), U4.5 (VCC), U5.2 (B), U5.3 (CLR), U5.8 (VCC), U6.5 (VCC), U7.4 (VCC)
Active: U5.5 (Q)
CS_TMC: U7.13 (PB1)
Clk: U7.7 (XTAL1/PB6)
Dir: U6.2
Dir_Local: R29.2, U7.14 (PB2)
Dir_TMC: R29.1, U6.4
Drive_EN: U3.4
Enable: R26.2
Enable_Ctrlr: D8.1 (K), U7.9 (PD5)
Error: U7.3 (PE0)
GND: C12.2, C14.2, C15.2, C26.2, C27.2, C35.2, C36.2, J1.6 (GND), R14.1, U3.3 (GND), U4.3 (GND), U5.4 (GND), U6.3 (GND), U7.5 (GND), U7.21 (GND)
Local_Ctrl: U4.1, U6.1, U7.11 (PD7)
MISO: J1.4 (MOSI), U7.16 (PB4)
MOSI: J1.1 (MISO), U7.15 (PB3)
unnamed: C16.1, U5.6 (Cext)
unnamed: C16.2, R12.2, U5.7 (RCext)
unnamed: C35.1, U7.20 (AREF)
unnamed: C36.1, L2.2, U7.18 (AVCC)
unnamed: D8.2 (A), R26.1, U3.1
unnamed: R31.2, U7.32 (PD2)
Ready_Ctrlr: R14.2, U3.2, U7.12 (PB0)
Reset: J1.5 (~RST), R16.2, U7.29 (~RESET/PC6)
Rx: U7.30 (PD0)
SCK: J1.3 (SCK), U7.17 (PB5)
Stall: R31.1
Step: U4.2
Step_Local: R13.2, U7.10 (PD6)
Step_TMC: R13.1, U4.4, U5.1 (~A)
Temp1: U7.23 (PC0)
Temp2: U7.24 (PC1)
Tx: U7.31 (PD1)
VSup: U7.25 (PC2)
