FordPrfkt/StepperController/boards/HighPowerDriver/HPDriver/Driver.kicad_sch

## KiCad design boards/HighPowerDriver/HPDriver/Driver.kicad_sch (2022-08-06)

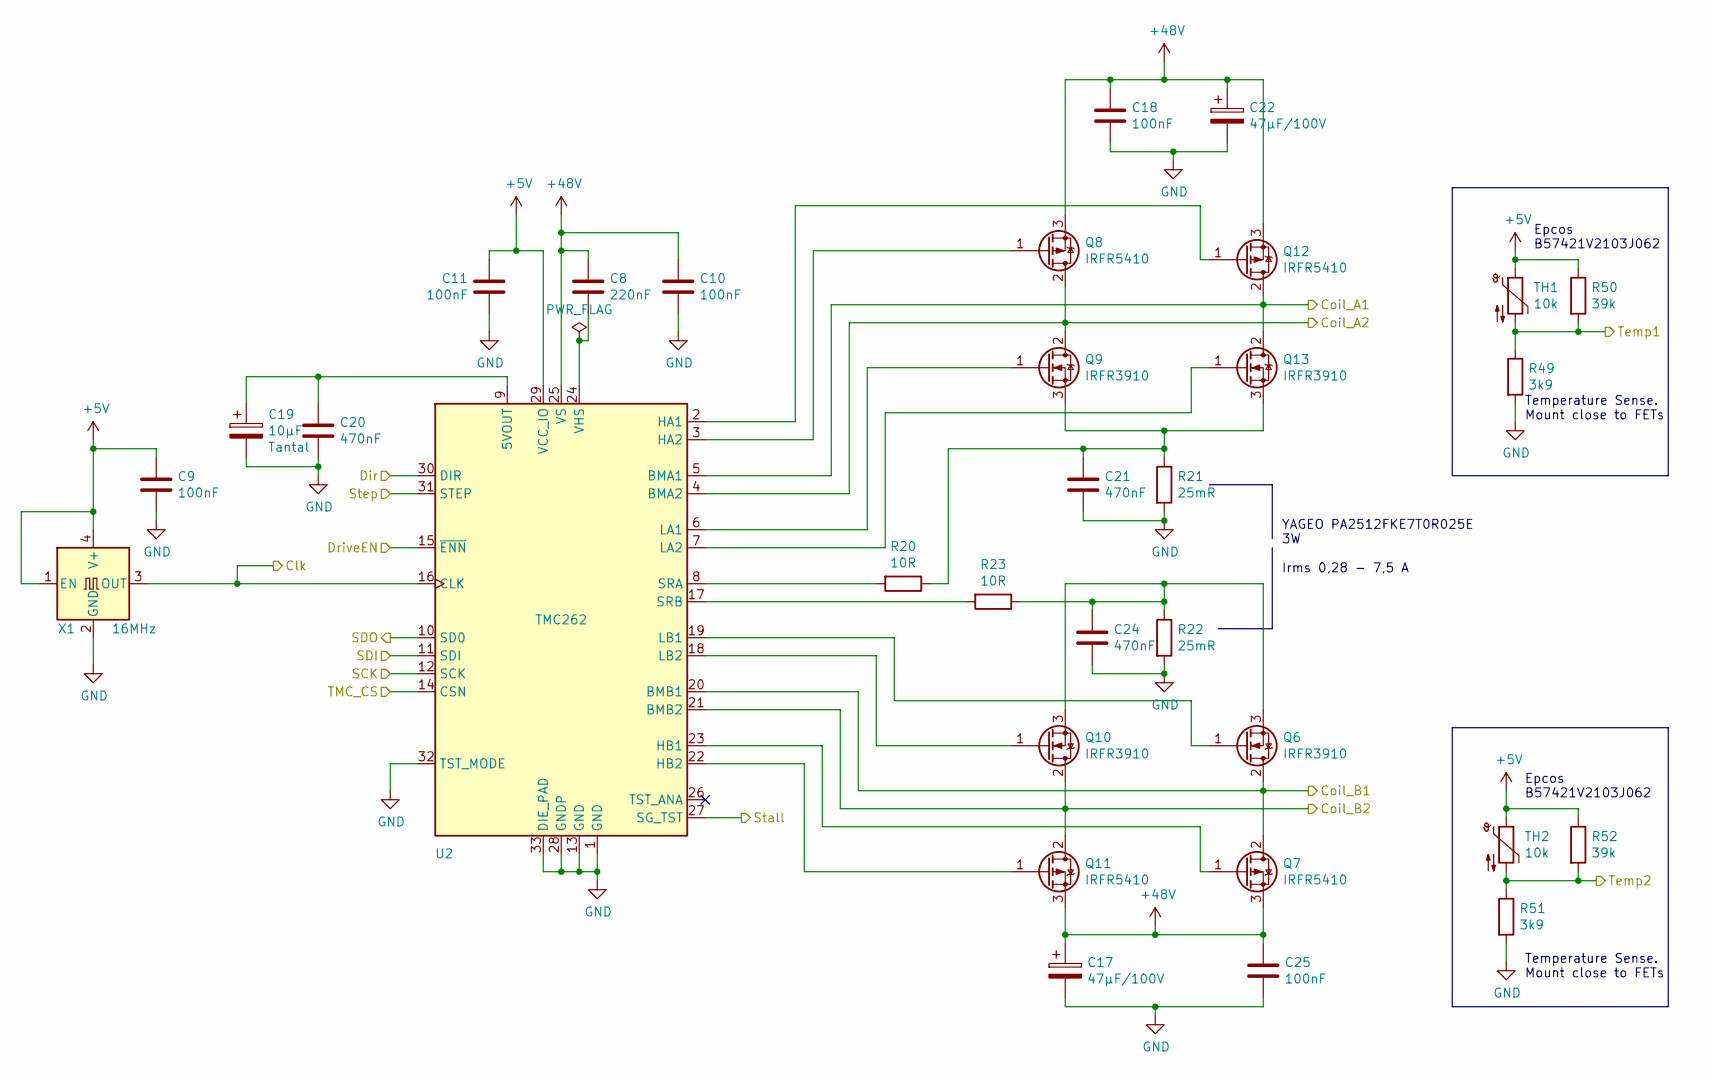
[picture p43: schematic Driver.kicad_sch]

Parts:
C8: 220nF; C_0805_2012Metric
C9, C10, C11, C18, C25: 100nF; C_0805_2012Metric
C17, C22: 47µF/100V; CP_Elec_10x10
C19: 10µF; CP_EIA-3528-21_Kemet-B
C20, C21, C24: 470nF; C_0805_2012Metric
Q6, Q9, Q10, Q13: IRFR3910; TO-252-2
Q7, Q8, Q11, Q12: IRFR5410; TO-252-2
R20, R23: 10R; R_0805_2012Metric
R21, R22: 25mR; R_2512_6332Metric
R49, R51: 3k9; R_0805_2012Metric
R50, R52: 39k; R_0805_2012Metric
TH1, TH2: 10k; R_0805_2012Metric
U2: TMC262; QFN-32-1EP_5x5mm_P0.5mm_EP3.45x3.45mm
X1: 16MHz; Oscillator_SMD_EuroQuartz_XO53-4Pin_5.0x3.2mm_HandSoldering

Connections:
+5V: C9.1, C11.1, R50.1, R52.1, TH1.1, TH2.1, U2.29 (VCC_IO), X1.1 (EN), X1.4 (V+)
+48V: C8.1, C10.1, C17.1, C18.1, C22.1, C25.1, Q7.3 (S), Q8.3 (S), Q11.3 (S), Q12.3 (S), U2.25 (VS)
Clk: U2.16 (CLK), X1.3 (OUT)
Coil_A1: Q12.2 (D), Q13.2 (D), U2.5 (BMA1)
Coil_A2: Q8.2 (D), Q9.2 (D), U2.4 (BMA2)
Coil_B1: Q6.2 (D), Q7.2 (D), U2.20 (BMB1)
Coil_B2: Q10.2 (D), Q11.2 (D), U2.21 (BMB2)
Dir: U2.30 (DIR)
DriveEN: U2.15 (~ENN)
GND: C9.2, C10.2, C11.2, C17.2, C18.2, C19.2, C20.2, C21.2, C22.2, C24.2, C25.2, R21.2, R22.2, R49.2, R51.2, U2.1 (GND), U2.13 (GND), U2.28 (GNDP), U2.32 (TST_MODE), U2.33 (DIE_PAD), X1.2 (GND)
unnamed: C8.2, U2.24 (VHS)
unnamed: C19.1, C20.1, U2.9 (5VOUT)
unnamed: C21.1, Q9.3 (S), Q13.3 (S), R20.1, R21.1
unnamed: C24.1, Q6.3 (S), Q10.3 (S), R22.1, R23.1
unnamed: Q6.1 (G), U2.19 (LB1)
unnamed: Q7.1 (G), U2.23 (HB1)
unnamed: Q8.1 (G), U2.3 (HA2)
unnamed: Q9.1 (G), U2.6 (LA1)
unnamed: Q10.1 (G), U2.18 (LB2)
unnamed: Q11.1 (G), U2.22 (HB2)
unnamed: Q12.1 (G), U2.2 (HA1)
unnamed: Q13.1 (G), U2.7 (LA2)
unnamed: R20.2, U2.8 (SRA)
unnamed: R23.2, U2.17 (SRB)
SCK: U2.12 (SCK)
SDI: U2.11 (SDI)
SDO: U2.10 (SD0)
Stall: U2.27 (SG_TST)
Step: U2.31 (STEP)
TMC_CS: U2.14 (CSN)
Temp1: R49.1, R50.2, TH1.2
Temp2: R51.1, R52.2, TH2.2

Notes on the sheet:
YAGEO PA2512FKE7T0R025E 3W Irms 0,28 - 7,5 A
Epcos B57421V2103J062
Temperature Sense. Mount close to FETs
