FordPrfkt/StepperController/boards/HighPowerDriver/HPDriver/Supply.kicad_sch

## KiCad design boards/HighPowerDriver/HPDriver/Supply.kicad_sch (2022-03-21)

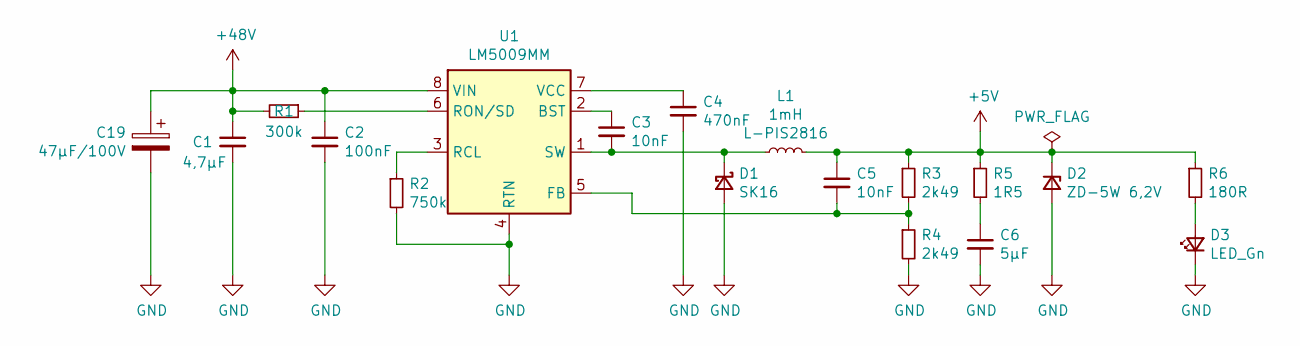
[picture p44: schematic Supply.kicad_sch]

Parts:
C1: 4,7µF; C_1210_3225Metric
C2: 100nF; C_0805_2012Metric
C3, C5: 10nF; C_0805_2012Metric
C4: 470nF; C_0805_2012Metric
C6: 5µF; C_1210_3225Metric
C19: 47µF/100V; CP_Elec_8x10
D1: SK16; D_SMA
D2: ZD-5W 6,2V; D_SMB
D3: LED_Gn; LED_0805_2012Metric
L1: 1mH; L_7.3x7.3_H4.5
R1: 300k; R_0805_2012Metric
R2: 750k; R_0805_2012Metric
R3, R4: 2k49; R_0805_2012Metric
R5: 1R5; R_0805_2012Metric
R6: 180R; R_0805_2012Metric
U1: LM5009MM; MSOP-8_3x3mm_P0.65mm

Connections:
+5V: C5.1, D2.1 (K), L1.2, R3.1, R5.1, R6.1
+48V: C1.1, C2.1, C19.1, R1.2, U1.8 (VIN)
GND: C1.2, C2.2, C4.2, C6.2, C19.2, D1.2 (A), D2.2 (A), D3.1 (K), R2.2, R4.2, U1.4 (RTN)
unnamed: C3.1, U1.2 (BST)
unnamed: C3.2, D1.1 (K), L1.1, U1.1 (SW)
unnamed: C4.1, U1.7 (VCC)
unnamed: C5.2, R3.2, R4.1, U1.5 (FB)
unnamed: C6.1, R5.2
unnamed: D3.2 (A), R6.2
unnamed: R1.1, U1.6 (RON/SD)
unnamed: R2.1, U1.3 (RCL)
