FordPrfkt/StepperController/boards/StepperController/rescue-backup/Controller-2019-03-11-01-49-32.sch

## KiCad design boards/StepperController/rescue-backup/Controller-2019-03-11-01-49-32.sch (2019-04-07)

Schematic: Controller-2019-03-11-01-49-32.sch

Parts:
C4, C5, C6, C7, C46: 100nF; C_0805_HandSoldering
C8, C9: 22pF; C_0805_HandSoldering
C47: 10µF; C_0805_HandSoldering
D32: ZMY5.6; D_SOT-23_ANK
D33: Led_x2; LED_D5.0mm-3
IC1: ATMEGA128-A; TQFP-64_14x14mm_Pitch0.8mm
J2: SPI_Extern; vasch_strip_4x2
P7: JTAG; vasch_strip_5x2
R3: 220R; R_0805_HandSoldering
R4: 150R; R_0805_HandSoldering
R70: 12k; R_0805_HandSoldering
SW1: ResetCycle; SW_0773
U4: 74LS11; so-14
Y1: 16MHz; hc-49_smd

Notes on the sheet:
Status LED
Nächstes mal AT2561
Pullup vorsehen oder an allen Control Pins verwendung interner pullup erlauben
Emergency off an Reset
Hardwareentprellung
Jumper/Schalter an Stall ?
