FordPrfkt/StepperController/boards/StepperController/rescue-backup/Driver-2019-03-11-01-49-32.sch

## KiCad design boards/StepperController/rescue-backup/Driver-2019-03-11-01-49-32.sch (2019-04-07)

Schematic: Driver-2019-03-11-01-49-32.sch

Parts:
C14: 100nF; C_0805_HandSoldering
JP2: JUMPER3; Pin_Header_Straight_1x03_Pitch2.54mm
R5: 10k; R_0805_HandSoldering
U2: 74HC11; so-14
X1: 16MHz; XO91
