FordPrfkt/StepperController/boards/StepperController/rescue-backup/Driver_X-2019-03-11-01-49-32.sch

## KiCad design boards/StepperController/rescue-backup/Driver_X-2019-03-11-01-49-32.sch (2019-04-07)

Schematic: Driver_X-2019-03-11-01-49-32.sch

Parts:
C16, C17, C18, C20, C21: 100nF; C_0805_HandSoldering
C19: 470nF; C_0805_HandSoldering
C22, C25: 10nF; C_0805_HandSoldering
C23, C24: 100µF; c_elec_8x10.5
D9: LED_RT; LED_0805
P8: CONN_X; mors_4p
Q3: BC817-40; SOT-23
R15: 220R; R_0805_HandSoldering
R16, R18: 22R; R_0805_HandSoldering
R17, R19: 100mR; R_2512_HandSoldering
R30: 4k7; R_0805_HandSoldering
U5: TMC2660; TQFP-44_10x10mm_Pitch0.8mm
