FordPrfkt/StepperController/boards/StepperController/rescue-backup/Driver_Y-2019-03-11-01-49-32.sch

## KiCad design boards/StepperController/rescue-backup/Driver_Y-2019-03-11-01-49-32.sch (2019-04-07)

Schematic: Driver_Y-2019-03-11-01-49-32.sch

Parts:
C26, C27, C28, C30, C31: 100nF; C_0805_HandSoldering
C29, C32: 470nF; C_0805_HandSoldering
C33, C34: 100µF; c_elec_8x10.5
C35: 10nF; C_0805_HandSoldering
D10: LED_RT; LED_0805
P9: CONN_Y; mors_4p
Q4: BC817-40; SOT-23
R20: 220R; R_0805_HandSoldering
R21: 10R; R_0805_HandSoldering
R22: 150mR; R_2512_HandSoldering
R23: 22R; R_0805_HandSoldering
R24: 100mR; R_2512_HandSoldering
R31: 4k7; R_0805_HandSoldering
U6: TMC2660; TQFP-44_10x10mm_Pitch0.8mm
