FordPrfkt/StepperController/boards/StepperController/rescue-backup/Driver_Z-2019-03-11-01-49-32.sch

## KiCad design boards/StepperController/rescue-backup/Driver_Z-2019-03-11-01-49-32.sch (2019-04-07)

Schematic: Driver_Z-2019-03-11-01-49-32.sch

Parts:
C36, C37, C38, C40, C41: 100nF; C_0805_HandSoldering
C39: 470nF; C_0805_HandSoldering
C42, C45: 10nF; C_0805_HandSoldering
C43, C44: 100µF; c_elec_8x10.5
D11: LED_RT; LED_0805
P10: CONN_Z; mors_4p
Q5: BC817-40; SOT-23
R25: 220R; R_0805_HandSoldering
R26, R28: 22R; R_0805_HandSoldering
R27, R29: 100mR; R_2512_HandSoldering
R32: 4k7; R_0805_HandSoldering
U7: TMC2660; TQFP-44_10x10mm_Pitch0.8mm
