FordPrfkt/StepperController/boards/StepperController/rescue-backup/Interface-2019-03-11-01-49-32.sch

## KiCad design boards/StepperController/rescue-backup/Interface-2019-03-11-01-49-32.sch (2019-04-07)

Schematic: Interface-2019-03-11-01-49-32.sch

Parts:
C3, C10, C12, C50, C51, C52, C53: 100nF; C_0805_HandSoldering
C11: 100nf; C_0805_HandSoldering
C13: 4,7µF; C_0805_HandSoldering
D3, D4, D13, D14, D24, D25: ZMY5,6; D_SOT-23_ANK
D5, D6: 1N4148; sod323
D7, D8: LED_YE; LED_0805
D26, D27: LED_Rd; LED_0805
D28, D30, D31: LED_Gn; LED_0805
J1, J3: DB9_Female; DB_9F
J4: Reference; b8b-ph-kl
J6: Ext; b4b-ph-kl
JP1, JP3: JUMPER3; Pin_Header_Straight_1x03_Pitch2.54mm
P2: Cover; b2b-ph-kl
P3: USB_B; conn_usb_B
P4: Relay2; mors_2p
P5: Relay1; mors_2p
P6: Emer_Off; b2b-ph-kl
P12: Coolant; b4b-ph-kl
P13: Spindle; b5b-ph-kl
Q1, Q2, Q8, Q9: BC817-40; SOT-23
Q6, Q7: BC807-40; SOT-23
R2, R8, R12, R13, R36, R37, R38, R39, R40, R41, R51, R52, R53, R56, R57, R65, R71, R78, R79, R80, R83, R84, R86: 4k7; R_0805_HandSoldering
R6, R7, R14, R33, R34, R35, R42, R43, R44, R45, R46, R47, R48, R54, R58: 1k; R_0805_HandSoldering
R9, R49: 10k; R_0805_HandSoldering
R10, R11: 150R; R_0805_HandSoldering
R50, R59, R77: 10R; R_0805_HandSoldering
R55, R60, R72, R73, R74, R75, R76, R81, R82, R85: 100R; R_0805_HandSoldering
R61, R62, R63, R64, R66: 220R; R_0805_HandSoldering
RL1, RL2: FINDER-36.11-4301; Fujiutsu_JS-MT
U2: 74HC11; so-14
U3: FT232RL; SSOP-28_5.3x10.2mm_Pitch0.65mm
U8, U9, U10, U11: 74HC245; tssop-20

Notes on the sheet:
USB / Serial Interface
Relais
End Stop / Reference Switches
Jog Wheel / External Display
LED Indicators
Spindle / Cover / Emergency Off
Generic External Interface
TEST muss an GND!
Hardwareentprellung
Filterung/Schutzschaltung an 5V Ausgang?
Ändern für Normal-Closed, 5V Schaltend, wie bei Cover
