FordPrfkt/StepperController/boards/StepperController/rescue-backup/PowerSupply-2019-03-11-01-49-32.sch

## KiCad design boards/StepperController/rescue-backup/PowerSupply-2019-03-11-01-49-32.sch (2019-04-07)

Schematic: PowerSupply-2019-03-11-01-49-32.sch

Parts:
C1: 100µF; c_elec_8x10.5
C2: 1000µF; C_Radial_D16_L25_P7.5
C15: 10µF; C_0805_HandSoldering
C48, C49: 100nF; C_0805_HandSoldering
D1: SK34; do214ac
D2: LED_GN; LED_0805
D12: SM6T 30CA; do214aa
D20: P6SMB 6,8A; do214aa
F1: 10AT; Fuseholder5x20_horiz_SemiClosed_Casing10x25mm
F2: 4AT; R_Axial_DIN0207_L6.3mm_D2.5mm_P10.16mm_Horizontal
L1: L-PISR 150µH; Choke_SMD_PISR_Handsoldering_FASTRON
P1: Power; mors_2p
R1: 220R; R_0805_HandSoldering
R67: 5k1; R_0805_HandSoldering
R68: 8k6; R_0805_HandSoldering
R69: 1k2; R_0805_HandSoldering
TH1: 10k; R_0805_HandSoldering
U1: LM2576S-5; TO-263-5Lead

Notes on the sheet:
Temperature Sense (Close to VREG)
