FordPrfkt/StepperController/boards/StepperDisplay/rescue-backup/Controller-2021-07-29-16-15-11.sch

## KiCad design boards/StepperDisplay/rescue-backup/Controller-2021-07-29-16-15-11.sch (2019-04-07)

Schematic: Controller-2021-07-29-16-15-11.sch

Parts:
BZ1: buzzer; Buzzer_12x9.5RM7.6
C1, C2: 100nF; C_0805
C3: 100µF; c_elec_4x5.8
IC1: ATTINY861-P; SOIC-20_7.5x12.8mm_Pitch1.27mm
P1: ISP; Pin_Header_Straight_2x03
P2: CONN_01X06; b6b-ph-kl
Q1: BC817-40; SOT-23_Handsoldering
R1: 1k; R_0805_HandSoldering
SW1: SW_PUSH; SW_SPST_EVPBF
X1: 12MHz; Resonator_CSTCE
