FordPrfkt/StepperController/boards/StepperDisplay/rescue-backup/LEDS-2021-07-29-16-15-11.sch

## KiCad design boards/StepperDisplay/rescue-backup/LEDS-2021-07-29-16-15-11.sch (2019-04-07)

Schematic: LEDS-2021-07-29-16-15-11.sch

Parts:
C10: 100nF; C_0805_HandSoldering
Q2, Q3, Q4, Q5, Q6, Q7, Q8, Q9: IRLML2502; SOT-23_Handsoldering
R20, R21, R22, R23, R24, R25, R26, R27: 100R; R_0805_HandSoldering
U1: 74HC595; SO-16-N
