FordPrfkt/StepperController/boards/StepperDisplay/rescue-backup/LEDSX-2021-07-29-16-15-11.sch

## KiCad design boards/StepperDisplay/rescue-backup/LEDSX-2021-07-29-16-15-11.sch (2019-04-07)

Schematic: LEDSX-2021-07-29-16-15-11.sch

Parts:
AFF1, AFF2, AFF3, AFF4, AFF5, AFF6: 7SEGMENTS; 7SegmentLED_LTS6760_LTS6780
C4: 100nF; C_0805_HandSoldering
C5: 100µF; c_elec_4x5.8
Q10, Q11, Q12, Q13, Q14, Q15: BC817-40; SOT-23_Handsoldering
R2, R3, R4, R5, R6, R7: 18R; R_0805_HandSoldering
R28, R29, R30, R31, R32, R33: 1k; R_0805_HandSoldering
U2: 74HC595; SO-16-N
