FordPrfkt/StepperController/boards/StepperDisplay/rescue-backup/LEDSY-2021-07-29-16-15-11.sch

## KiCad design boards/StepperDisplay/rescue-backup/LEDSY-2021-07-29-16-15-11.sch (2019-04-07)

Schematic: LEDSY-2021-07-29-16-15-11.sch

Parts:
AFF7, AFF8, AFF9, AFF10, AFF11, AFF12: 7SEGMENTS; 7SegmentLED_LTS6760_LTS6780
C6: 100nF; C_0805_HandSoldering
C7: 100µF; c_elec_4x5.8
Q16, Q17, Q18, Q19, Q20, Q21: BC817-40; SOT-23_Handsoldering
R8, R9, R10, R11, R12, R13: 18R; R_0805_HandSoldering
R34, R35, R36, R37, R38, R39: 1k; R_0805_HandSoldering
U3: 74HC595; SO-16-N
