FordPrfkt/StepperController/boards/StepperDisplay/rescue-backup/LEDSZ-2021-07-29-16-15-11.sch

## KiCad design boards/StepperDisplay/rescue-backup/LEDSZ-2021-07-29-16-15-11.sch (2019-04-07)

Schematic: LEDSZ-2021-07-29-16-15-11.sch

Parts:
AFF13, AFF14, AFF15, AFF16, AFF17, AFF18: 7SEGMENTS; 7SegmentLED_LTS6760_LTS6780
C8: 100nF; C_0805_HandSoldering
C9: 100µF; c_elec_4x5.8
Q22, Q23, Q24, Q25, Q26, Q27: BC817-40; SOT-23_Handsoldering
R14, R15, R16, R17, R18, R19: 18R; R_0805_HandSoldering
R40, R41, R42, R43, R44, R45: 1k; R_0805_HandSoldering
U4: 74HC595; SO-16-N
