FordPrfkt/StepperController/(commit log)

2016-02-11 Work in Progress
    [Controller.sch, Driver.sch, Driver_X.sch, Driver_Y.sch, Driver_Z.sch, Interface.sch, LEDsX.sch, LEDsY.sch]
2016-02-27 Recover from damaged repository
    [Controller.sch, Driver.sch, Interface.sch, LEDsX.sch, LEDsY.sch, LEDsZ.sch, PowerSupply.sch, StepperController.kicad_pcb]
2016-02-27 Layout Displayplatine fertig
    [Controller.sch, LEDsX.sch, LEDsY.sch, LEDsZ.sch, StepperDisplay.kicad_pcb, StepperDisplay.sch]
2016-02-28 Cover-Anschluss hinzu, Schutzdioden geändert
    [Controller.sch, Driver.sch, Driver_X.sch, Driver_Y.sch, Driver_Z.sch, Interface.sch, PowerSupply.sch, StepperController.kicad_pcb]
2016-03-03 Layouting... Neuer Oszillator für TMC
    [Controller.sch, Driver.sch, Driver_X.sch, Driver_Y.sch, Driver_Z.sch, StepperController.kicad_pcb]
2016-03-15 Minor layout changes
    [StepperController.kicad_pcb]
2016-05-02 Fixed Part Libraries
    [Controller.sch, Driver.sch, Driver_X.sch, Driver_Y.sch, Driver_Z.sch, Interface.sch, PowerSupply.sch, StepperController.kicad_pcb]
2016-05-05 Thermal vias, changed footprint of logic ics
    [Controller.sch, Driver.sch, Interface.sch, PowerSupply.sch, StepperController.kicad_pcb]
2016-08-24 Changed to segment multiplexing, new layout
    [Controller.sch, LCD.sch, LEDsX.sch, LEDsY.sch, LEDsZ.sch, StepperDisplay.kicad_pcb, StepperDisplay.sch]
2016-08-27 Layout Release 1
    [Controller.sch, LEDsX.sch, LEDsY.sch, LEDsZ.sch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]
2016-09-03 Added Ext. Connector, new Layout of Supply to TMC2660
    [Controller.sch, Driver.sch, Driver_X.sch, Driver_Y.sch, Driver_Z.sch, Interface.sch, StepperController.kicad_pcb, StepperController.sch]
2016-09-05 Layout updated
    [Controller.sch, Driver.sch, Driver_X.sch, Driver_Y.sch, Driver_Z.sch, Interface.sch, LEDsX.sch, LEDsY.sch]
2016-09-18 New LED Driving Scheme
    [Controller.sch, LEDS.sch, LEDsX.sch, LEDsY.sch, LEDsZ.sch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]
2016-09-19 Pre-Release Layout
    [Controller.sch, Driver.sch, Driver_X.sch, Driver_Y.sch, Driver_Z.sch, Interface.sch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]
2016-09-19 Added Schematic PDF
2016-10-15 Version 0.0.1
    [Interface.sch, StepperController.kicad_pcb]
2016-12-20 Button readout working. Version 1.0 Finished
2016-12-20 Layout optimizations
    [Interface.sch, PowerSupply.sch, StepperController.kicad_pcb]
2017-03-12 Added Reset Logic, Layout changes
    [Controller.sch, Driver.sch, Driver_X.sch, Driver_Y.sch, Driver_Z.sch, Interface.sch, PowerSupply.sch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]
2017-03-13 Removed Accidental commit, changed µC to ATMega128A
    [Controller.sch, StepperController.kicad_pcb, alarm_codes_en_US.csv, build_option_codes_en_US.csv, config.h, cpu_map.h, defaults.h, error_codes_en_US.csv]
2017-05-08 Added Connector for Buttons & Emergency Off for Relays
    [Controller.sch, Driver.sch, Driver_X.sch, Driver_Y.sch, Driver_Z.sch, Interface.sch, StepperController.kicad_pcb, StepperController.sch]
2017-05-17 Final Version for Manufacturing
    [StepperController.kicad_pcb]
2017-08-27 Added Buffering for Inputs
    [Controller.sch, Driver.sch, Driver_X.sch, Driver_Y.sch, Driver_Z.sch, Interface.sch, PowerSupply.sch, StepperController.kicad_pcb]
2017-09-27 Added Buffers for I/O, Changed Pinout to be compatible with grbl
    [Controller.sch, Driver.sch, Driver_X.sch, Driver_Y.sch, Driver_Z.sch, Interface.sch, StepperController.kicad_pcb, StepperController.sch]
2017-09-29 Changed Footprints
    [Controller.sch, Interface.sch, StepperController.kicad_pcb]
2018-02-11 Removed SW, Added HandController, Small PCB changes
    [Controller.sch, Driver.sch, Driver_X.sch, Driver_Y.sch, Driver_Z.sch, HandController.kicad_pcb, HandController.sch, Interface.sch]
2019-04-07 Changed to KiCad 5.1 and added HP Stepper Driver
    [Connector.sch, Controller.sch, Driver.sch, HPController.kicad_pcb, HPController.sch, HPDriver.kicad_pcb, HPDriver.sch, Supply.sch]
2019-04-07 Changed to KiCad 5.1
    [Controller-2019-02-21-22-43-43.sch, Controller-2019-03-11-01-49-32.sch, Controller.sch, Driver-2019-03-11-01-49-32.sch, Driver.sch, Driver_X-2019-03-11-01-49-32.sch, Driver_X.sch, Driver_Y-2019-03-11-01-49-32.sch]
2019-04-07 Selected FETs
    [Connector.sch, Driver.sch, HPDriver.kicad_pcb]
2019-07-30 Updated Layout
    [Connector.sch, Controller.sch, Ethernet.sch, HPController.sch, HPDriver.kicad_pcb, HPDriver.sch, Supply.sch, USB.sch]
2019-08-04 Update HPDriver.kicad_pcb
    Layout update
    [HPDriver.kicad_pcb]
2019-08-21 Changed Connector to Phoenix Type
    [Connector.sch, HPDriver.kicad_pcb, USB.sch]
2019-09-29 Release 1.0
    [HPDriver-B_Cu.gbr, HPDriver-B_Mask.gbr, HPDriver-B_SilkS.gbr, HPDriver-Edge_Cuts.gbr, HPDriver-F_Cu.gbr, HPDriver-F_Mask.gbr, HPDriver-F_SilkS.gbr, HPDriver-In1_Cu.gbr]
2019-12-19 Changed position of LEDs, improved routing
    [HPDriver-B_Cu.gbr, HPDriver-B_Mask.gbr, HPDriver-B_SilkS.gbr, HPDriver-Edge_Cuts.gbr, HPDriver-F_Cu.gbr, HPDriver-F_Mask.gbr, HPDriver-F_SilkS.gbr, HPDriver-In1_Cu.gbr]
2020-07-22 Layout v1.0 finished
    [Connector.sch, Controller.sch, Driver.sch, HPDriver.kicad_pcb, HPDriver.sch, Supply.sch]
2021-05-21 Added Control Logic for Enable/Step/Dir Signals
    [Connector.sch, Controller.sch, Driver.sch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]
2021-11-07 Added Logic to allow local control of stepper trough µC
    [HPDriver-B_Cu.gbr, HPDriver-B_Mask.gbr, HPDriver-B_SilkS.gbr, HPDriver-Edge_Cuts.gbr, HPDriver-F_Cu.gbr, HPDriver-F_Mask.gbr, HPDriver-F_SilkS.gbr, HPDriver-In1_Cu.gbr]
2021-12-10 Changed Controller to ATtiny406
    [Connector.sch, Controller.sch, Driver.sch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]
2022-03-21 Moved to Kicad 6.0
    [Connector.kicad_sch, Connector.sch, Controller.kicad_sch, Controller.sch, Driver.kicad_sch, Driver.sch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]
2022-03-21 Minor Layout fix
    [HPDriver-B_Cu.gbr, HPDriver-B_Mask.gbr, HPDriver-B_Silkscreen.gbr, HPDriver-Edge_Cuts.gbr, HPDriver-F_Cu.gbr, HPDriver-F_Mask.gbr, HPDriver-F_Silkscreen.gbr, HPDriver-In1_Cu.gbr]
2022-08-06 Changed Controller to ATmega328PB
    The ATtiny did not have enough flash
    [Connector.kicad_sch, Connector.sch, Controller-2021-07-29-16-15-11.sch, Controller.kicad_sch, Controller.sch, Driver.kicad_sch, Ethernet.sch, HPController.kicad_pcb]
2022-08-09 Revert "Delete boards/HighPowerDriver - Kopie directory"
    This reverts commit 429dd5f8732def63523e52ec431af87c5fce2a12.
    [Connector.kicad_sch, Connector.sch, Controller.kicad_sch, Controller.sch, Driver.kicad_sch, Ethernet.sch, HPController.kicad_pcb, HPController.sch]
