FordPrfkt/StepperController/(notices)

Notices in the files:
boards/StepperController/rescue-backup/Interface-2019-03-11-01-49-32.sch:
CC BY-NC-SA 4.0
Licensed under Creative Commons
